sinyakov-sa/plane/MG20_3550_Wing_RevA36_SmoothBREP/README_RU.md

# MG20 3550 — крыло Rev A.36 SmoothBREP

База: Rev A.35.

## Элероны

Элероны упрощены и теперь полностью зашиты бальзой **1,0 мм сверху и снизу по всей площади**. Отдельный носовой D-box, его задняя стенка и плёночная обтяжка элеронов удалены.

Внешняя поверхность новой обшивки взята непосредственно с точной аэродинамической поверхности A.35. Все 14 нервюр элеронов перестроены с посадкой **1,05 мм** под лист 1,0 мм, то есть оставлен технологический запас 0,05 мм.

Закрылки не менялись: каркас + термоусадочная плёнка 0,08 мм.

Расчётная масса полной бальзовой обшивки двух элеронов: **19.0 г**.

Повторный импорт STEP: **PASS**. Материал новых деталей после импорта: Balsa, плотность 0,16 г/см³.

Основная сборка: `MG20_Wing_A36_SmoothBREP_KOMPAS.step`.
