sinyakov-sa/plane/нервюры перехода/README_RU.txt

MG20 — НЕРВЮРЫ ПЕРЕХОДНЫХ КОЛОДОК КОНСОЛИ, RevA / 15x5
Дата: 23.10.2026. Все размеры в миллиметрах.

КОМПЛЕКТ
На ОДНУ консоль: O0350, O0385, O0405, O0500, O0640.
Каждая нервюра состоит из передней FWD и задней AFT половинки: всего 10 деталей.
Координаты 350 / 385 / 405 / 500 / 640 отсчитываются от корня съёмной консоли.
Координата задаёт СРЕДНЮЮ плоскость 3-мм нервюры. Учтена геометрия по её толщине.
Для двух консолей вырезать комплект дважды. Профиль по высоте не зеркалить.
O0230 уже входит в комплект пенала; повторно не вырезать.
На отметке 680 мм отдельной нервюры в исходном расписании нет.

МАТЕРИАЛ И РАСКЛАДКА
Берёзовая авиационная фанера 3 мм для всех десяти деталей.
Это изменение по сравнению с исходным A26: O0385/O0405/O0640 были из бальзы 3 мм.
O0350 и O0500 сохраняют исходный материал — берёзовую фанеру 3 мм.
Расчётная масса комплекта около 32 г на консоль при плотности 700 кг/м3.
Исходные соответствующие нервюры A26: около 16,8 г на консоль.
Прибавка около 30 г на обе консоли; к прибавке массы полок прибавляется отдельно.
Раскладка помещается в лист 297 мм по X и 420 мм по Y.
Волокна наружных слоёв вдоль X (хорды). Ноль станка — снизу слева.
Позиции и обозначения показаны в LAYOUT.png и LAYOUT_LABELS_DO_NOT_CUT.svg.
Автоматической гравировки в NC нет. Подписать детали по раскладке до извлечения.

ПОРЯДОК РЕЗКИ
1. NC/00_FIT_TESTS_PLY3.nc — сначала пробные участки посадки O0350/O0500/O0640
   и контрольная деталь 30 x 20 мм. Пробные участки вырезаны из геометрии нервюр,
   это не детали для вклейки. Их положения: FIT_TESTS_LABELS_DO_NOT_CUT.svg.
2. Проверить пробные участки на фактическом переходе без натяга, с сохранением
   проектной высоты профиля и места под обшивку. Если колодки ещё не изготовлены,
   окончательное совпадение посадки до их примерки не подтверждено.
3. NC/01_RIBS_ONE_CONSOLE_PLY3.nc — основной комплект на одну консоль.
4. Для другой консоли повторить основной файл на новой заготовке.

ПАРАМЕТРЫ NC
LaserGRBL / GRBL: G21, G90, G94; M4 S1000; $30=1000, $32=1.
Подача 232,8 мм/мин, один проход — перенесено из предыдущего комплекта нервюр
пенала из фанеры 3 мм. Это исходный режим для той же установки и материала;
проверить прорезание на пробных деталях перед основным листом.
Компенсация ширины реза 0,20 мм УЖЕ ВНЕСЕНА в траектории NC.
Не включать дополнительную компенсацию, не масштабировать; overrides 100%.
Лазер выключается перед каждым быстрым перемещением и в конце файла.
В DXF_NOMINAL и SVG_NOMINAL даны НОМИНАЛЬНЫЕ контуры без компенсации реза.
При использовании их в своей CAM внести компенсацию самостоятельно один раз.
Индивидуальные DXF используют координаты профиля: по Z/Y возможны отрицательные
значения. Готовая общая раскладка перенесена в положительные координаты листа.
SVG с LABELS_DO_NOT_CUT предназначены только для просмотра, не для резки.

ГЕОМЕТРИЧЕСКАЯ ПРИВЯЗКА
Аэродинамический контур, крутка, положение заднего лонжерона и границ рулей:
исходные скрипты MG20_3550_Wing_RevA26_SmoothBREP.
O0350 обрезана перед внешним закрылком; O0385/O0405 сохраняют полный хвостовой
контур как опоры неподвижного участка между закрылком и элероном.
O0500/O0640 обрезаны перед элероном. Подвижные нервюры рулей в комплект не входят.
Главный переход: колодки 5p2 длиной 450 мм, шириной 44,30 мм у начала,
по MG20_Upper_Console_Shoe_450_Dimensions.pdf и актуальному
MG20_Lower_Console_Shoe_450_Dimensions.pdf, прочитанным 23.10.2026.
Отметка начала колодки d=230; конец колодки d=680.
До d=500 сохранены наружные поверхности и сужение этих колодок.
После d=500 вырезы рассчитаны на суммарный габарит колодка + сопряжённая полка
шириной 15 мм и общей толщиной 5 мм в зоне уса, далее — на полку 15 x 5 мм.
Это не означает, что можно вклеить полную рейку 5 мм ПОВЕРХ колодки:
в зоне 500–680 мм нужен сопряжённый ус; суммарная толщина — 5 мм.
Ранее выданные чертежи колодок рассчитаны на переменную полку: новое сопряжение
рейки 15 x 5 с колодкой подгоняется совместно, наружные поверхности сохраняются.
После отметки 680 наружная полка должна плавно продолжить эту поверхность.
Стенки перехода 2 мм, наружного лонжерона 1 мм.
На d=500 учтены наружные накладки стенок толщиной 1 мм и клеевой слой 0,1 мм.
Номинальный зазор к силовому узлу — 0,20 мм с учётом изменения сечения
по толщине нервюры. На O0500/O0640 торцы половинок прямые, без мелких выступов.
На O0350/O0385/O0405 средние выступы подходят к боковым стенкам между колодками.
Не сдвигать половинки внутрь для устранения технологического зазора.
Нервюры фиксировать на стапеле в проектной ориентации.

ПРОВЕРКИ И ГРАНИЦЫ ПРИМЕНИМОСТИ
Проверены замкнутость и корректность контуров, отсутствие пересечений деталей
на листе, размещение в 297 x 420 мм, компенсация реза и зазор к расчётному
силовому габариту по всей толщине нервюры. В приложении — verification.json.
Половинки не образуют замкнутые диафрагмы и не заменяют усиление пенала.
Это геометрически проверенный комплект для примерки и изготовления нервюр,
а не подтверждение прочности переработанного перехода или всего крыла.
Фактические колодки, накладки и клеевые наплывы не измерены.
Действующая 3D-сборка крыла этим архивом не обновляется.

ВОСПРОИЗВЕДЕНИЕ
build.py + source/: Python 3, numpy, matplotlib, shapely, ezdxf.
Запуск: python3 build.py. Скрипт записывает результаты рядом с собой.
Не запускать генератор из source отдельно: это исходник прежней модели A26.
