sinyakov-sa/plane/нервюры пенала консоли/README_RU.txt

MG20: комплект НОВЫХ нервюр пенала ОДНОЙ консоли, адаптация RevA26.
7 деталей. Для второй консоли повторить комплект, профиль не зеркалить.
01: O0000, берёзовая авиационная фанера 3 мм; 280x60 мм; F232.8.
02: передние и задние половинки O0035/O0180, берёзовая фанера 2 мм; 270x110 мм; F480.
03: половинки O0230, берёзовая фанера 3 мм; 190x60 мм; F232.8.
Везде M4 S1000, один проход, $30=1000, $32=1. Ноль снизу слева, волокна вдоль X.
Компенсация уже внесена: 2 мм — 0.25 мм; 3 мм — 0.20 мм. Масштаб и overrides 100%.
Посадки сохранены из RevD (2 мм) и эмпирической RevC (O0230).
Профиль хвостов и пазы заднего лонжерона — RevA26. O0035 теперь до полной задней кромки.
O0000 новая: носовой контур под обшивку 1.5 мм, отверстие 20.4x20.4 мм.
На новую O0000 полоски бальзы 0.5 мм НЕ нужны.
O0180/O0230 новые: длина уже по RevA26; компенсирующая накладка около 4 мм на заднюю рейку НЕ нужна.
Не использовать эти NC для дорезки установленных деталей.
Перед основными файлами используйте соответствующие тесты выступов; примерка без натяга.
Проверены замкнутость, отсутствие самопересечений/наложений и сохранение посадок.
Комплект не является подтверждением прочности разрезных нервюр или полной адаптацией переходных колодок и остального крыла.
