sinyakov-sa/plane/нервюры пенала центроплана/README_RU.txt

Нервюры ОДНОГО пенала ЦЕНТРОПЛАНА MG20, адаптация A26.
C595 — цельная корневая, отверстие под трубу 20.4x20.4, авиационная берёзовая фанера 3 мм.
C560/C525 — передние и задние половинки, берёзовая фанера 2 мм.
C445 — передняя и задняя половинки, берёзовая фанера 3 мм.
Отсчёт от торца стыка: C595=0; C560=35; C525=70; C445=150 мм.
Комплект 7 деталей, для двух пеналов центроплана вырезать два комплекта.
Нервюры ставятся в плоскостях сечений крыла; не разворачивать все перпендикулярно наклонной трубе.
Учтён наклон оси трубы 2 градуса по проекту. Контуры и задние пазы A26, носовая обшивка 2 мм.
Посадки выступов перенесены из исправленных консольных NC RevD (2 мм) и RevC (3 мм).
Это предполагает одинаковый фактический зазор между рейками с консолью; сначала приложенные тесты.
TEST_O0230_TONGUE_REVC используется как тест посадки C445, несмотря на старое имя.
3 мм F232.8; 2 мм F480; M4 S1000; один проход; $30=1000; $32=1.
Керф уже внесён: 0.20/0.25 соответственно. Масштаб и overrides 100%. Ноль снизу слева. Волокна вдоль X.
Заготовки: 01 280x60; 02 290x120; 03 210x65 мм.
DXF — номинальные контуры БЕЗ компенсации; NC — готовые траектории с компенсацией.
Цельные C560/C525 не выбраны: минимальные перемычки вокруг необработанных крышек с зазором 0.2 составили бы около 0.86/1.24 мм.
C445: нижняя крышка 3 мм выступает за профиль примерно на 1.10 мм в худшей точке по ширине.
До вклейки проверить профилирование нижней крышки; для зазора 0.15 мм нужно снять в этой точке около 1.25 мм (остаток около 1.75 мм). Не снимать одинаково по всей ширине.
Профилирование крышек и прочность разрезных нервюр/пенала требуют отдельной проверки; NC не являются подтверждением прочности узла.
Переходные C365/C285/C205 в комплект не входят. Файлы для новых деталей, не для дорезки склеенного узла.
