sinyakov-sa/plane/хвост/MG20_Tail_RevD/README_RU.md

# MG20 — хвостовое оперение RevD

**Статус: эскизная конструкция для обсуждения и изготовления пробных образцов. Не предназначена для установки на летающую модель без расчёта и проверки.**

## Главное отличие от RevC

- Устранена различная стреловидность левой и правой осей руля высоты: обе лежат на **одной прямой X=140 мм, Z=0**. Для этого передняя кромка на конце стабилизатора изменена с 40 на **56 мм**; остальные хорды сохранены.
- Ось руля направления сделана вертикальной **X=210 мм, Y=0**. Передняя кромка вершины киля перенесена со 120 на **84 мм**.
- Передние кромки подвижных рулей выполнены клинообразными, с локальным уменьшением толщины. Ширина условной щели вдоль X — 2 мм.
- Силовая сборка дополнена сегментированными стенками между полками лонжеронов: **32 стенки из берёзовой фанеры 2 мм**, их торцы стыкуются с нервюрами.
- Увеличено число нервюр до **38**; возле условных петель назначены фанерные усиленные нервюры.
- Смоделированы шесть отдельных реек/брусков передней кромки из бальзы: три неподвижные и три клиновидные на рулях. Их необходимо профилировать; их 3D-форма — конечный наружный контур, а не закупочный прямоугольный брусок.
- Показаны девять мест установки осей петель. **Крепёж, конкретные петли и их посадочные карманы не спроектированы**, цилиндры в отдельном STEP — только координатные маркеры.

**Внимание: геометрия RevC и RevD НЕ взаимозаменяема. Нельзя смешивать детали лазерной резки из разных ревизий.**

## Основные размеры и геометрия, мм

| Характеристика | Значение |
|---|---:|
| Размах стабилизатора | 1000 |
| Корневая / концевая хорда стабилизатора, включая РВ | 200 / 120 |
| Смещение передней кромки стабилизатора у конца | **56** |
| Высота киля | 420 |
| Корневая / концевая хорда киля, включая РН | 300 / 180 |
| Смещение передней кромки киля наверху | **84** |
| Ось шарниров двух половин РВ | **X=140, Z=0**, параллельно Y |
| Ось шарниров РН | **X=210, Y=0**, параллельно Z |
| Профили | NACA 0010 (H), NACA 0009 (V), полилинейная аппроксимация |
| Промежуток между половинами РВ | 30 |
| Толщина верхних/нижних полок основного лонжерона | ном. 5×4, требует расчёта |
| Полки заднего лонжерона | ном. 3×3, требует расчёта |
| Предварительная толщина фанерных стенок | 2 |

Система осей: **+X назад по самолёту**, +Y вправо, +Z вверх. Эти координаты локальные, до привязки к фюзеляжу. Размеры могут измениться после определения объёма, плеча хвоста, массы и центровки MG20.

## Состав

- **6 аэродинамических оболочек-габаритов**: 2 неподвижные части стабилизатора, 2 половины руля высоты, киль и руль направления (объёмные STEP-представления внешней формы, а не сплошные физические блоки).
- **88 конструктивных твёрдых тел**: 38 нервюр, 32 отрезка стенок лонжеронов, 12 полок, 6 фасонных передних кромок.
- **9 координатных маркеров шарниров**. Это не настоящие шарниры и не монтажные отверстия.
- **DXF 1:1**: фанерные нервюры 2 мм (21 шт.), бальза 3 мм (7 шт.), бальза 2 мм (10 шт.), фанерные стенки 2 мм (32 шт.). Все детали присутствуют отдельно в листах.

### Для чего нужны файлы

- `step/MG20_RevD_Envelope_6Solids.step` — общий аэродинамический внешний вид (6 твёрдых тел).
- `step/MG20_RevD_Structure.step` — конструктивная сборка без обшивки, шарниров, тяг, крепления к фюзеляжу (88 отдельных тел).
- `step/MG20_RevD_Hinge_Datums_ONLY.step` — координатные маркеры для проверки компоновки (9 тел).
- `step/HS_R_Fixed.step` — одиночное тело для первой проверки в КОМПАС.
- `step/HS_R_Fixed_AP203_DIAGNOSTIC.step` / `...AP214IS_DIAGNOSTIC.step` — две версии схемы STEP для проверки совместимости импорта.
- `cut/RevD_Ribs_*_TRIAL_1to1.dxf` — пробные контуры нервюр.
- `cut/RevD_Shear_Webs_PLY2_TRIAL_1to1.dxf` — пробные развёрнутые контуры стенок, ширина по высоте профиля.
- `tables/Rib_Cutlist.csv`, `tables/Shear_Web_Cutlist.csv`, `tables/Other_Members.csv` — спецификации.
- `tables/Hinges_Datums.csv` — координаты осей по каждому месту навески.
- `tables/Clearance_Sweep.csv` — протокол кинематической проверки сечений.
- `parameters.json`, `generate.py` — параметры и воспроизводимый генератор.
- `verification.json` — результаты повторного открытия STEP через OpenCascade.

**DXF не включают поправку на ширину реза, свойства конкретной фанеры, разбухание клеевого шва или запас под окончательную обработку.** На слоях `CUT` находятся линии реза, на `PART_ID_DO_NOT_CUT` — только обозначения. Пазы у полок содержат номинальный суммарный конструктивный зазор **0,2 мм**, который не заменяет учёт ширины реза. Сначала проверять на образцах.

## Проверка кинематики

При повороте **только наружного профиля** вокруг прямых расчётных осей проверено 41 сечение по размаху и 25 углов в каждом сечении (в сумме 2050 проверок). В пределах ±25° для РВ и ±30° для РН пересечений профилей не обнаружено; минимальный расстояние по сечениям — **1,663 мм**.

Это **не гарантия возможности такого полного отклонения**: не учтены петли, винты, кабанчики, тяги, обшивка, эластичность, тепловые деформации и взаимное 3D-пересечение у законцовок и фюзеляжа. Допускаемые рабочие отклонения должны устанавливаться отдельно.

## Что не сделано — нельзя считать конструкцию завершённой

1. **Крепление оперения к фюзеляжу и силовой корневой узел**: неизвестны реальные габариты и сечение хвостовой балки; сверлить монтажные отверстия по этой ревизии нельзя.
2. **Физические шарниры, усиление мест вклейки, кабанчики, тяги, сервомашинки**: маркеры показывают только положение осей, не готовые узлы.
3. **Замкнутый носовой D-бокс и торсионная жёсткость рулей**: отсутствуют верхняя/нижняя бальзовая обшивка и соединения обшивки с полками/носовыми элементами. Без них твёрдость на кручение недостаточно определена.
4. **Прочность и ресурс**: не проверены нагрузки на хвост, изгиб лонжеронов, срез стенок, вырыв шарниров, прочность клеевых соединений, флаттер. Сечения 5×4 и 3×3 только предварительные.
5. **Подбор габаритов оперения**: аэродинамические объёмные коэффициенты горизонтального/вертикального оперения не рассчитаны из реальной площади/САХ крыла и плеча до фокуса хвоста.
6. **Массовая оптимизация**: 21 фанерная нервюра — консервативная временная схема, может оказаться слишком тяжёлой.

## Импорт в КОМПАС-3D

1. Проверить **`step/HS_R_Fixed.step`**: должно появиться ОДНО твёрдое тело, габарит примерно X=0…139; Y=0…500; Z≈±10 мм.
2. Если файл распознаётся, но тела нет, попробовать AP203 и AP214IS из той же папки; выполнить «Показать всё» и проверить видимость тел в дереве модели.
3. Затем проверить шесть оболочек и только после этого крупную структурную сборку на 88 тел.
4. При повторяющейся пустой модели требуется сравнение заголовка и типов STEP-сущностей с проверенно открывающимся STEP крыла. В этой среде запуск КОМПАС невозможен; OpenCascade подтвердил наличие валидной геометрии, **но импорт КОМПАС не проверен**.

## Порядок дальнейшей конструкторской работы

Следующий обоснованный этап — совместить хвост с геометрией хвостовой балки и рассчитать нагрузки/сечение лонжеронов при реально принятой Vmax и перегрузке. После этого завершить физические узлы навески и замкнутую обшивку (торсионные коробки), затем выпустить изготовительные чертежи с припусками и допусками.
