sinyakov-sa/plane/хвост/MG20_Tail_RevA/README_RU.md

# MG20 — хвостовое оперение RevA

Предварительная CAD-компоновка, 24.10.2026. Не рабочий комплект для изготовления.
Выбран вариант обычного оперения: низко расположенный стабилизатор, отдельный киль,
две половины руля высоты и руль направления. Выбор ориентирован на простоту изготовления
и обслуживания деревянной модели; глобальная оптимизация массы и аэродинамики не выполнена.

## Файлы
- MG20_Tail_RevA_Envelope.step — внешние объёмы стабилизатора, двух рулей высоты, киля и руля направления; пять деталей. Эти объёмы НЕ изображают сплошные деревянные детали.
- MG20_Tail_RevA_Frame.step — отдельная компоновочная модель каркаса. Не накладывать её на внешние объёмы при расчёте массы.
- MG20_Tail_RevA_Preview.png — вид внешней формы и каркаса.
- build_tail.py — воспроизводимый исходник (Python, CadQuery 2.7, NumPy, Matplotlib).
- parameters_and_validation.json — размеры, расчёт и результат повторного чтения STEP.

## Исходные данные и выбор размеров
Прочитан исходник generate_wing_cutpack.py из MG20_3550_Wing_RevA26_SmoothBREP.zip.
Размах крыла 3550 мм, хорда 310 мм у корня и 169 мм на конце; линия 25% хорды прямая.
Для предварительного подбора используется номинальная трапеция без поправки на округление
последних 15 мм законцовок и проекцию поперечного V. Площадь 0,850225 м².
САХ вычисляется как (2/3)*(cr²+cr*ct+ct²)/(cr+ct).

Горизонтальное оперение: полный размах 1000 мм, хорды 200/120 мм,
смещение передней кромки законцовки назад 56 мм, полная площадь 0,160 м².
Плечо 800 мм между точками 25% САХ крыла и оперения — новое проектное допущение,
а не измерение существующего фюзеляжа. Номинальный коэффициент Vh около 0,61.
Руль высоты: 30% местной хорды, две половины, центральный вырез шириной 70 мм.

Вертикальное оперение: высота 420 мм, хорды 300/180 мм, стреловидность передней
кромки 120 мм, площадь 0,1008 м², плечо 900 мм, Vv около 0,030.
Руль направления: номинально 35% местной хорды. Корень киля расположен на Z=25 мм,
верх на Z=445 мм относительно средней плоскости стабилизатора.
Оба профиля — симметричный NACA 0010 с конечной толщиной задней кромки.
Угол установки обоих оперений в модели 0°; это геометрическая исходная установка,
не рассчитанная балансировка в полёте.

Метод: Vh=Sh*lh/(Sw*MAC), Vv=Sv*lv/(Sw*b).
В таблице Embry-Riddle для планера/мотопланера ориентиры 0,6 и 0,03:
https://eaglepubs.erau.edu/introductiontoaerospaceflightvehicles/chapter/aircraft-stability-control/
Определения и ограничения метода:
https://unicado.pages.rwth-aachen.de/unicado.gitlab.io/documentation/sizing/empennage_design/basic-concepts/
Коэффициенты рассчитаны по полным площадям, до вычета щелей и центрального выреза.
Это лишь начальный подбор; они не заменяют проверку устойчивости и управляемости.

## Каркас и изготовление
Представлены нервюры толщиной 2 мм, передние элементы, продольные стенки и элементы
по линии навески. Для основной части нервюр предложена бальза; корневые нервюры
и нервюры у центрального выреза — берёзовая фанера 2 мм. Это предложения RevA,
а не подтверждение достаточной прочности данных сечений.
Каркас иллюстрирует расположение элементов. Его сечения и клеевые соединения
не рассчитаны. В модели нет полок силовых лонжеронов, обшивки D-носка, усилений
под петли, самих петель, кабанчиков, приводов, разъёмов и узла крепления к фюзеляжу.
Конструкция каркаса требует доработки до выпуска файлов резки.
Задние кромки выполнены по профилю и требуют технологического утолщения/подбора заготовки.

Между неподвижными и подвижными объёмами оставлена номинальная щель 2 мм.
Рули показаны в нейтрали: скосы носиков и оси петель ещё не разработаны;
свобода отклонения не подтверждена. По этим STEP нельзя назначать рабочие углы рулей.
Центральный вырез и высота киля условны до получения геометрии хвостовой балки.

## Координаты и импорт в КОМПАС
Единицы — миллиметры. Как в исходнике крыла: X вдоль размаха, Y назад по хорде,
Z вверх. Начало — передняя кромка крыла в центральном сечении.
Положение хвоста уже задано в этой системе; произвольный перенос при совмещении
изменит принятые плечи. Перед соединением с крылом проверить оси импортированной сборки.
Открывать STEP отдельно через импорт КОМПАС; Envelope — внешняя форма, Frame — каркас.
Нативная сборка КОМПАС не создавалась. Импорт проверен средствами OpenCascade/CadQuery,
открытие непосредственно в КОМПАС в этой среде не проверялось.

## Что необходимо перед изготовлением
1. Согласовать плечи и посадочные поверхности с фюзеляжем, проверить зазор до земли.
2. Установить диапазон центровки, массу, расчётные скорости и перегрузки.
3. Проверить продольную/путевую устойчивость, скос потока, балансировку с закрылками
   и запас управления; при необходимости изменить площади и угол установки.
4. Рассчитать силовой каркас, крепление, шарниры, приводы и массу хвоста, проверить
   жёсткость и риск флаттера. Затем разработать рабочую конструкцию и файлы резки.

## Размещение в репозитории
При добавлении в sinyakov-sa/plane проверена имеющаяся версия крыла RevA36:
в её SOURCE/generate_wing_cutpack.py сохранены SEMISPAN=1775 мм и линейная
хорда 310–169 мм. Поэтому номинальные площадь и САХ, использованные для
предварительного подбора оперения, соответствуют и этим параметрам RevA36.
Полная проверка совместной сборки и аэродинамики с RevA36 не выполнялась.

Для пересоздания файлов: `python build_tail.py` из окружения с CadQuery 2.7,
NumPy 2.x и Matplotlib. Скрипт сохраняет результаты рядом с собой.

## Исправление экспорта для КОМПАС (24.10.2026)
Первый вариант открывался у пользователя пустой моделью. Сравнение с рабочим
MG20_Wing_A36_SmoothBREP_KOMPAS.step выявило отличие: в старом Envelope было
118 PCURVE и 59 SURFACE_CURVE, а в крыле эти сущности отсутствуют.
Причина отказа непосредственно в КОМПАС пока не подтверждена.

Экспорт заменён на прямой XCAF/STEPCAF, как в исходнике крыла:
- AP214, write.surfacecurve.mode=0, write.precision.mode=1;
- отдельные определения деталей, компоненты и UpdateAssemblies перед записью;
- каждый отдельный solid каркаса оформлен отдельной деталью сборки;
- вспомогательные PCURVE/SURFACE_CURVE отсутствуют.

Сначала открывать **MG20_Tail_RevA_Frame.step** для каркаса или
**MG20_Tail_RevA_Envelope.step** для внешней формы.
Дополнительные файлы **..._FLAT.step** содержат те же тела без дерева сборки —
запасной вариант для проверки импорта. Они не сохраняют разделение на именованные
компоненты и предназначены для открытия как многотельная геометрия.

Геометрия повторно импортирована в OpenCascade: проверены количество, валидность,
объёмы и габариты тел относительно первоначальных STEP (допуск габаритов 0,001 мм,
относительный допуск объёма 0,1%). После исключения PCURVE импортёр заново
восстанавливает параметризацию границ; объёмы могут незначительно различаться. Результат в
KOMPAS_EXPORT_AUDIT.json. Проверка непосредственно в КОМПАС не выполнялась;
исправление экспорта не меняет предварительный статус конструкции.
export_kompas.py используется основным build_tail.py, поэтому исправление
сохраняется при повторной генерации модели.
