sinyakov-sa/plane/нервюры пенала консоли/layout.png

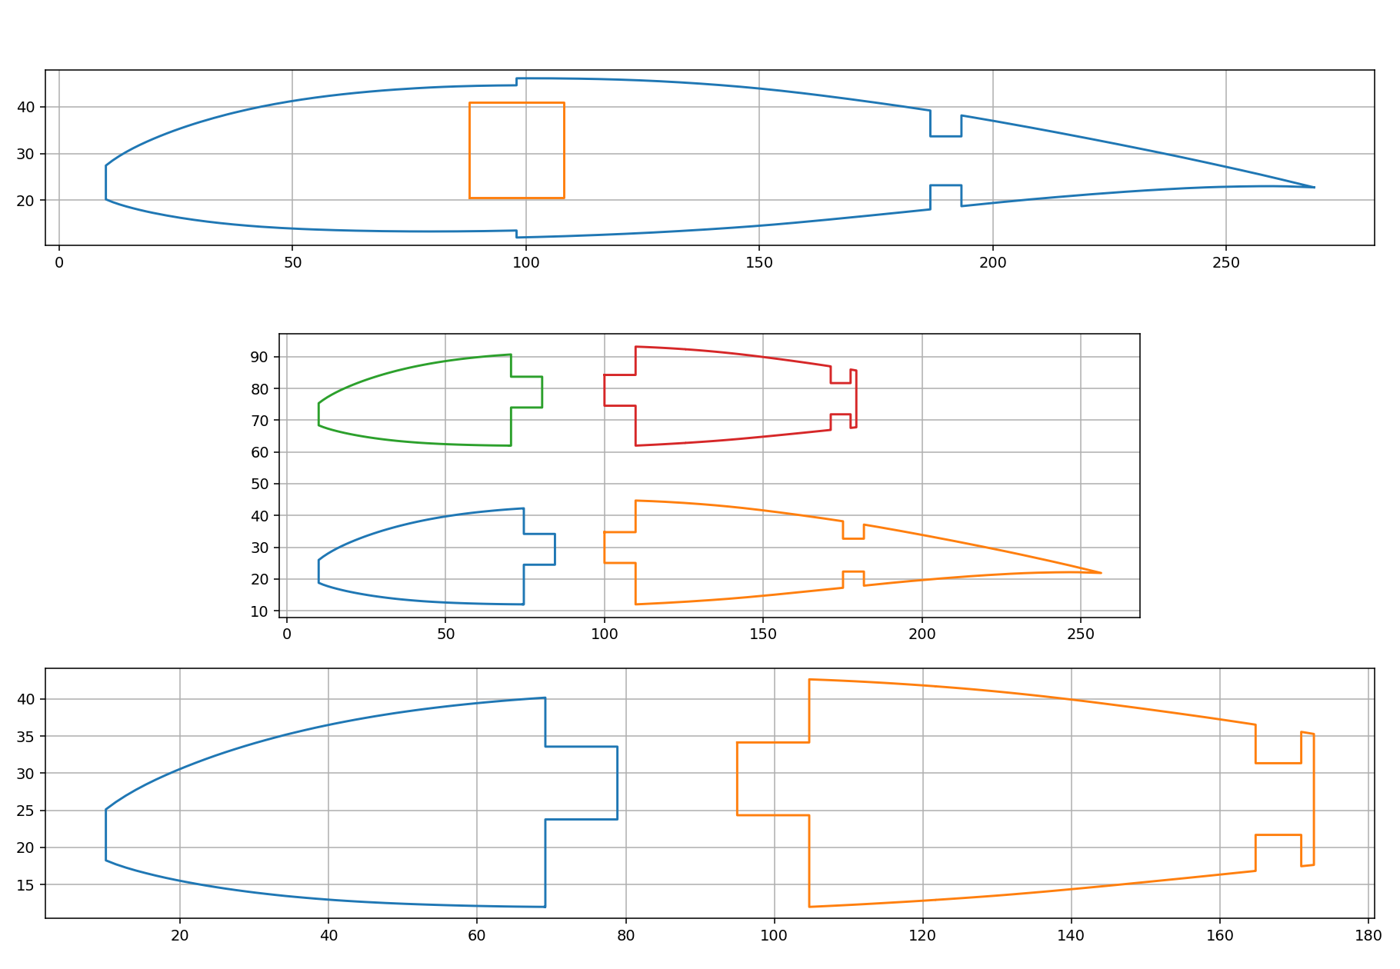
нервюры пенала консоли/layout.png
