sinyakov-sa/plane/нервюры пенала центроплана/layout.png

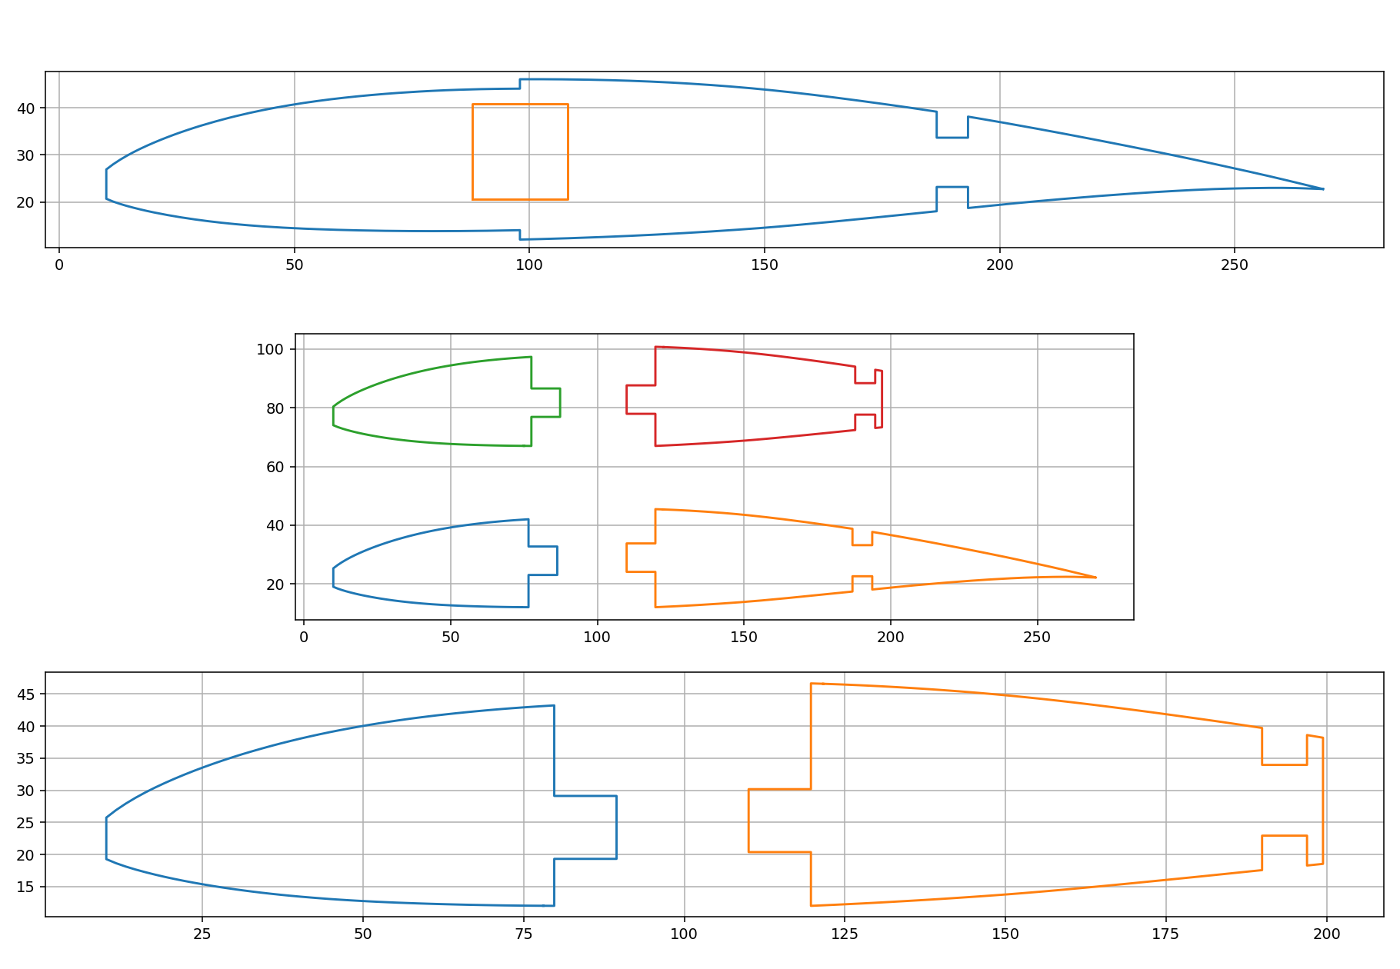
нервюры пенала центроплана/layout.png
