sinyakov-sa/plane/нервюры перехода/LAYOUT.png

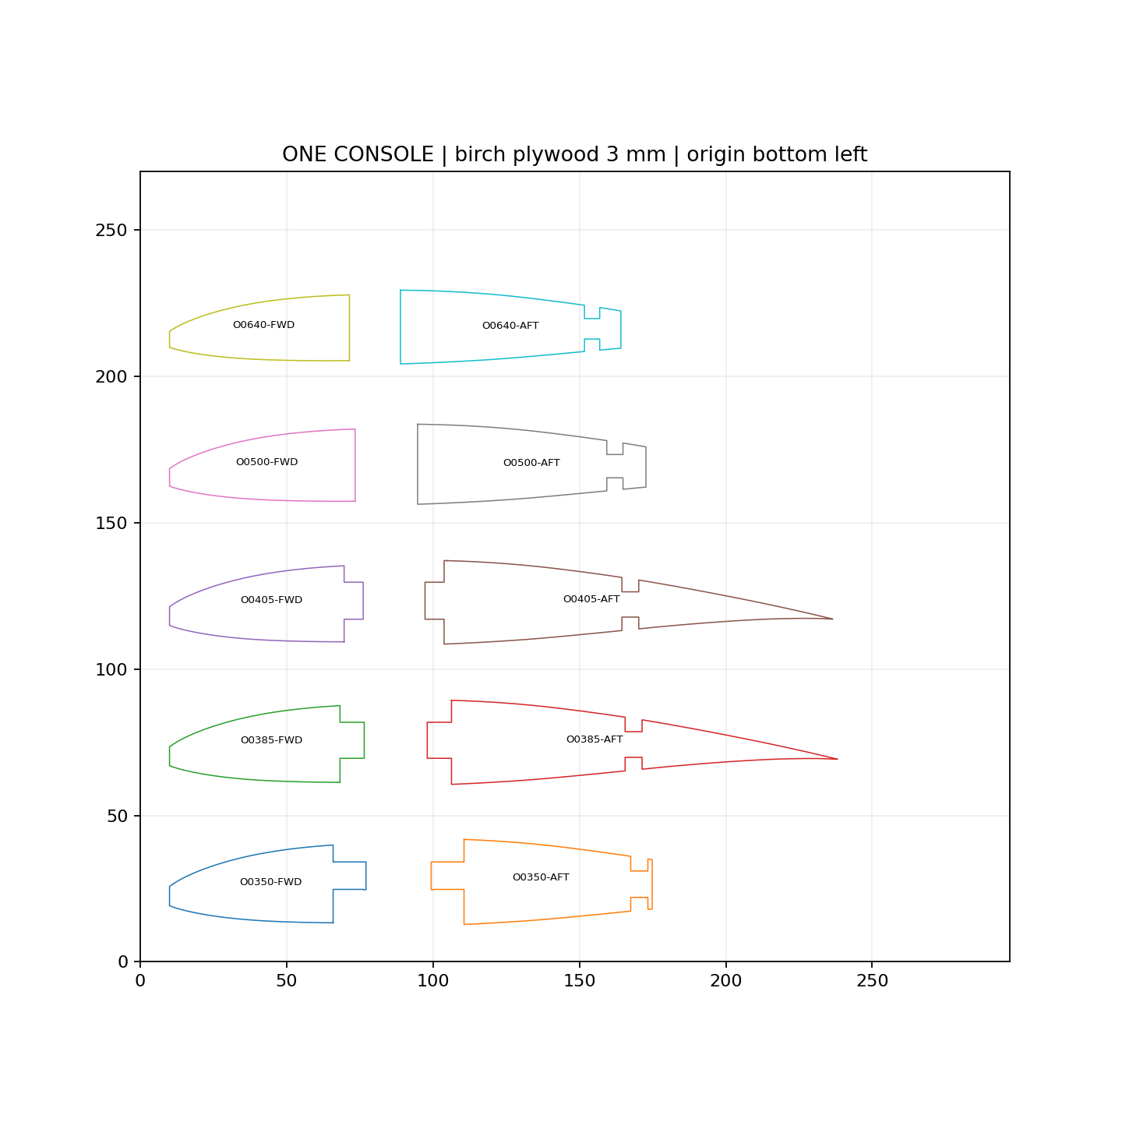
нервюры перехода/LAYOUT.png
