sinyakov-sa/plane/хвост/MG20_Tail_RevD/previews/MG20_RevD_Control_Clearance.png

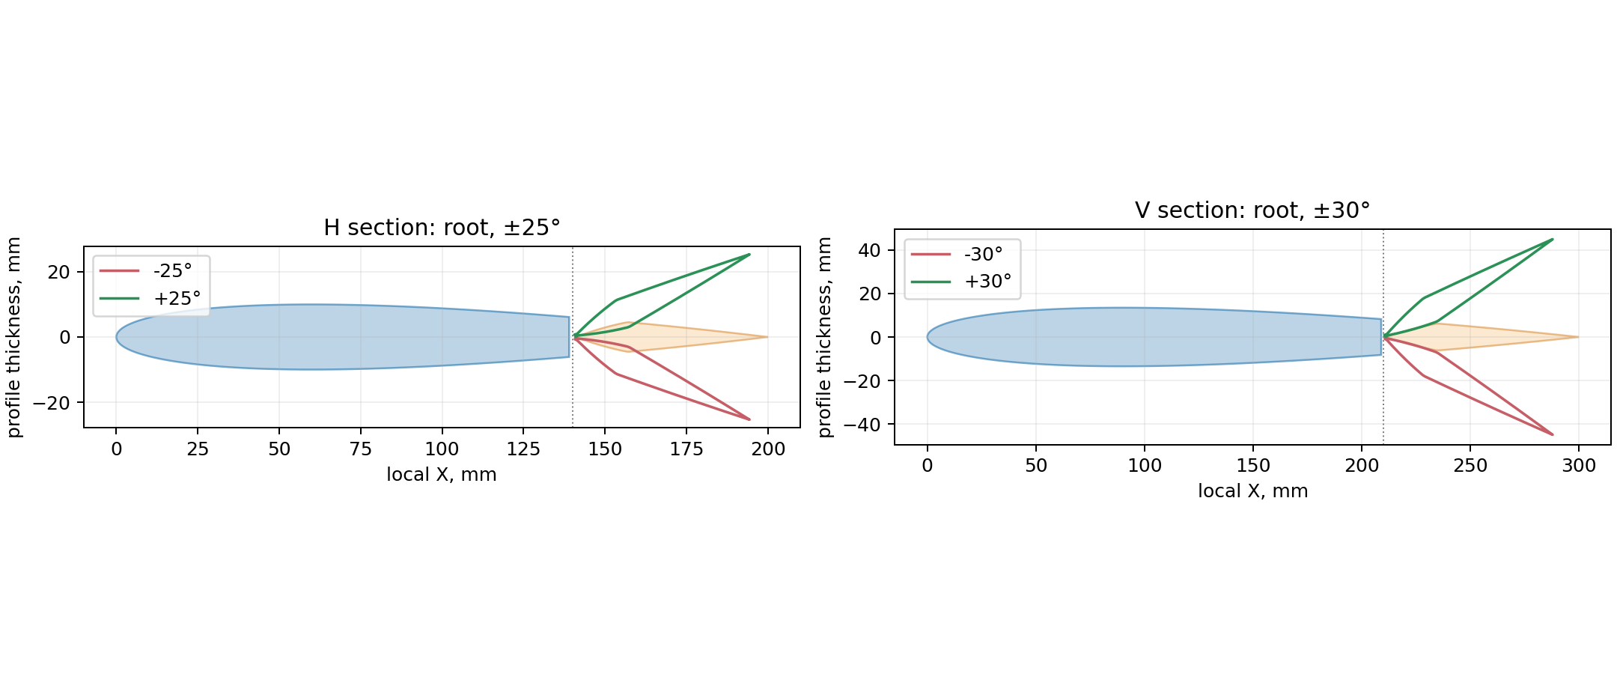
хвост/MG20_Tail_RevD/previews/MG20_RevD_Control_Clearance.png
