sinyakov-sa/plane/хвост/MG20_Tail_RevD/previews/MG20_RevD_Horizontal_Plan.png

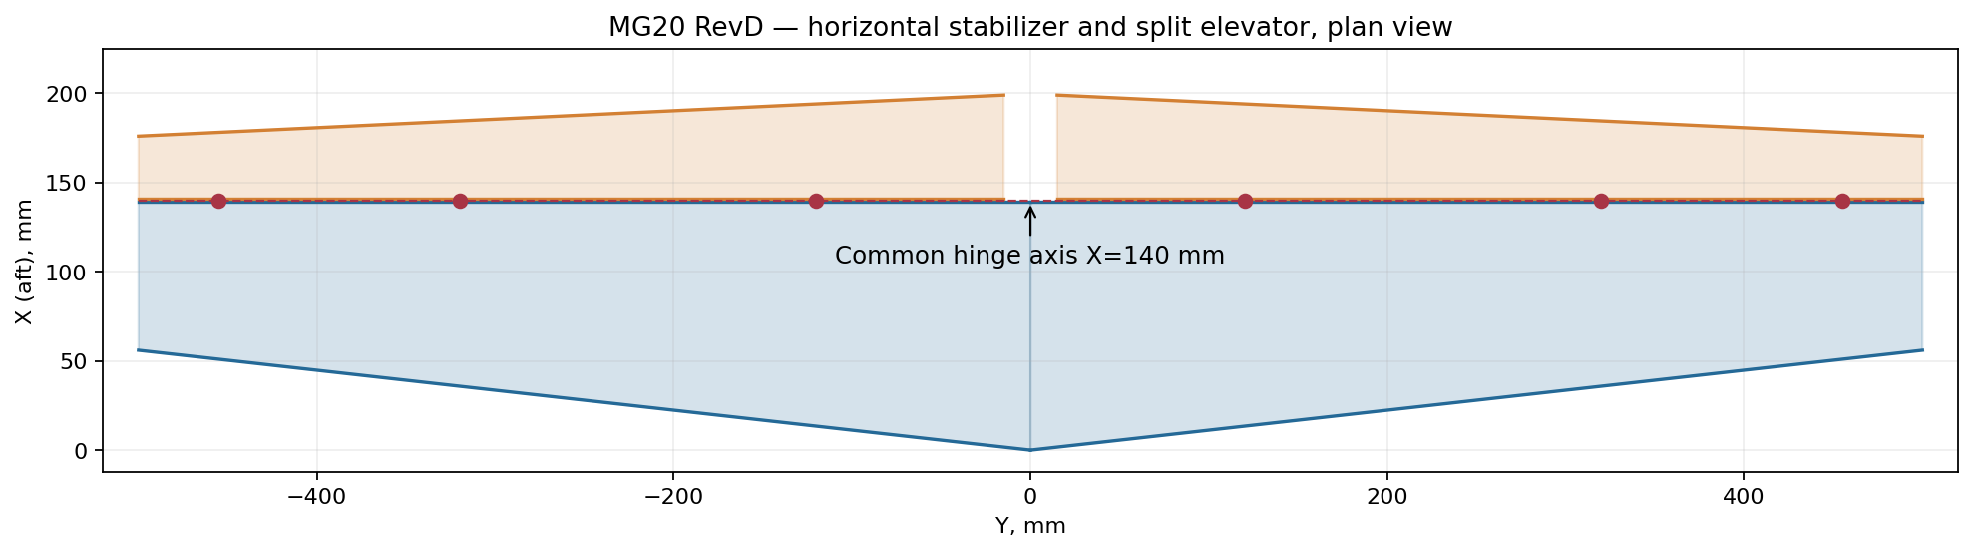
хвост/MG20_Tail_RevD/previews/MG20_RevD_Horizontal_Plan.png
