sinyakov-sa/plane/хвост/MG20_Tail_RevD/previews/MG20_RevD_Vertical_Side.png

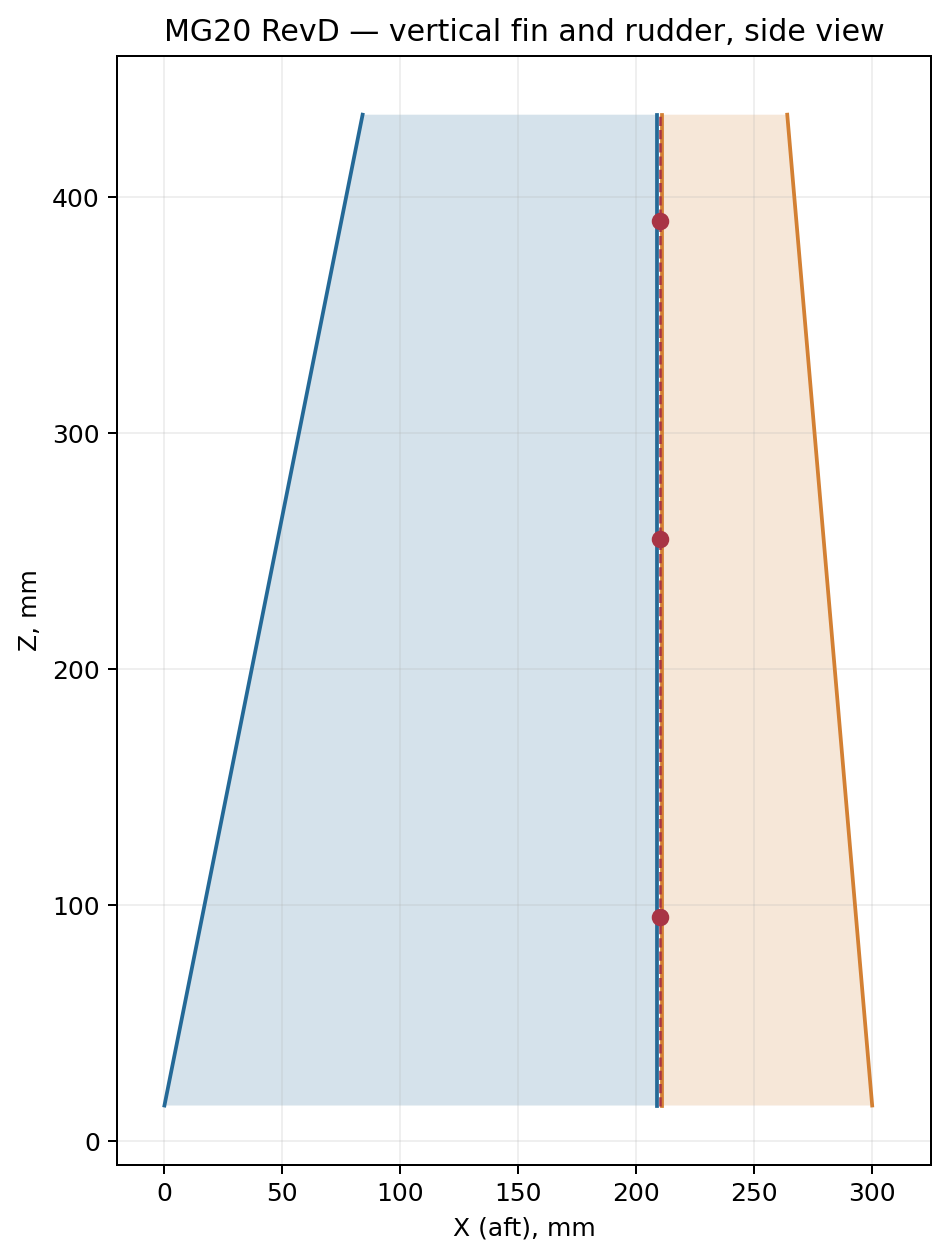
хвост/MG20_Tail_RevD/previews/MG20_RevD_Vertical_Side.png
