sinyakov-sa/plane/нервюры пенала центроплана/03_C445_PLY3_nominal.dxf

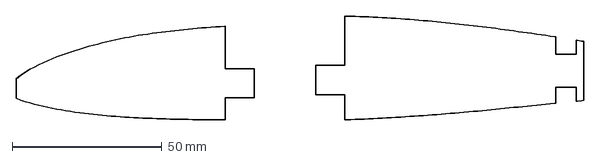
[picture p8: CAD file, 2026-10-22]
нервюры пенала центроплана/03_C445_PLY3_nominal.dxf
189.4 x 34.6 mm
