sinyakov-sa/plane/нервюры перехода/DXF_NOMINAL/O0640-AFT.dxf

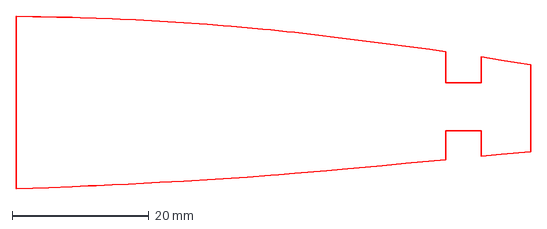
[picture p9: CAD file, 2026-10-23]
нервюры перехода/DXF_NOMINAL/O0640-AFT.dxf
75.3 x 25.2 mm
