sinyakov-sa/plane/хвост/MG20_Tail_RevB_4Solids.step

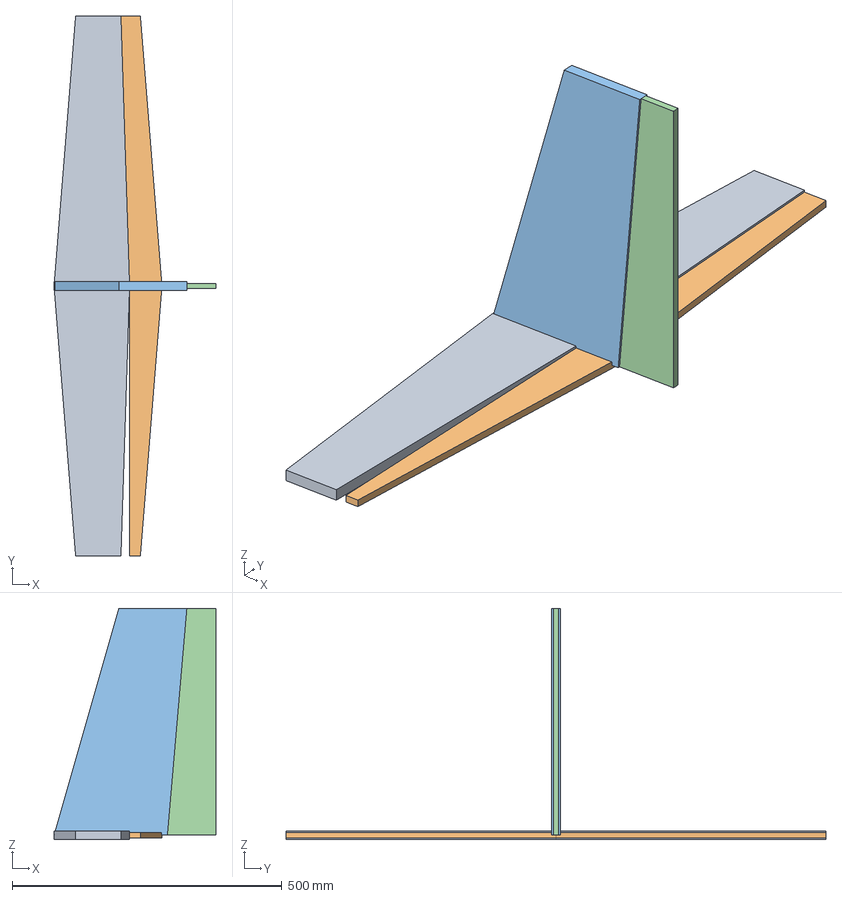
[picture p10: CAD file, 2026-10-23]
хвост/MG20_Tail_RevB_4Solids.step
300.0 x 1000.0 x 428.0 mm
