sinyakov-sa/plane/хвост/MG20_Tail_RevD/cut/RevD_Ribs_BALSA3_TRIAL_1to1.dxf

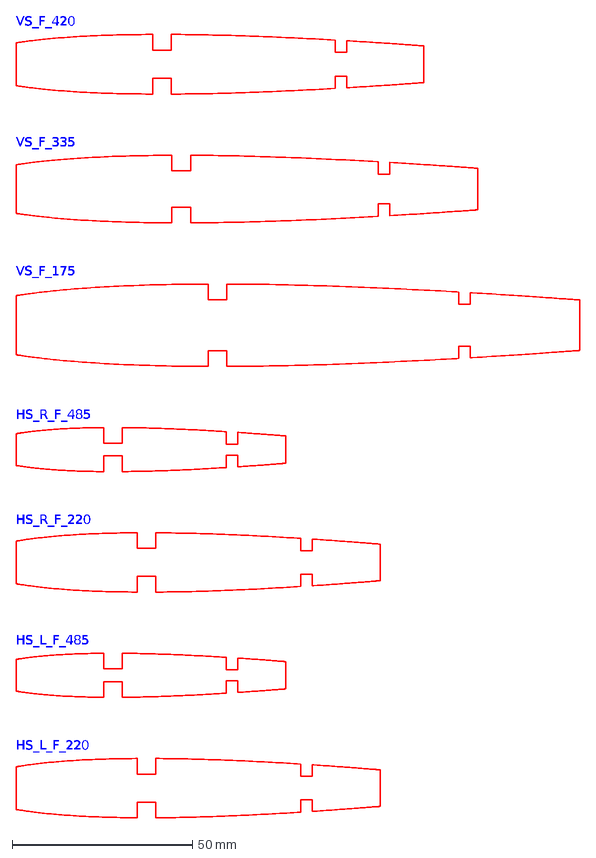
[picture p11: CAD file, 2026-10-23]
хвост/MG20_Tail_RevD/cut/RevD_Ribs_BALSA3_TRIAL_1to1.dxf
HS_L_F_220
HS_L_F_485
HS_R_F_220
HS_R_F_485
VS_F_175
VS_F_335
VS_F_420
