sinyakov-sa/plane/хвост/MG20_Tail_RevD/step/VS_Rudder.step

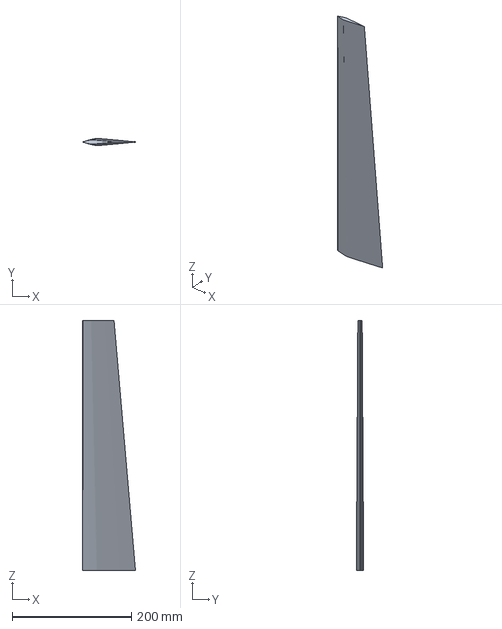
[picture p12: CAD file, 2026-10-23]
хвост/MG20_Tail_RevD/step/VS_Rudder.step
89.0 x 12.3 x 420.0 mm
