sinyakov-sa/plane/нервюры пенала центроплана/01_C595_ROOT_PLY3_nominal.dxf

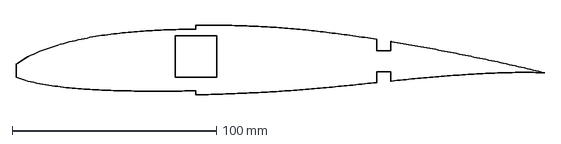
[picture p13: CAD file, 2026-10-22]
нервюры пенала центроплана/01_C595_ROOT_PLY3_nominal.dxf
258.7 x 34.1 mm
