sinyakov-sa/plane/нервюры перехода/DXF_NOMINAL/O0500-FWD.dxf

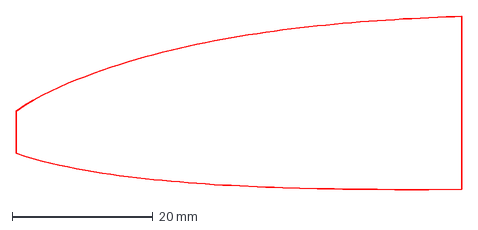
[picture p14: CAD file, 2026-10-23]
нервюры перехода/DXF_NOMINAL/O0500-FWD.dxf
63.4 x 24.7 mm
