sinyakov-sa/plane/хвост/MG20_Tail_RevD/step/VS_Fin.step

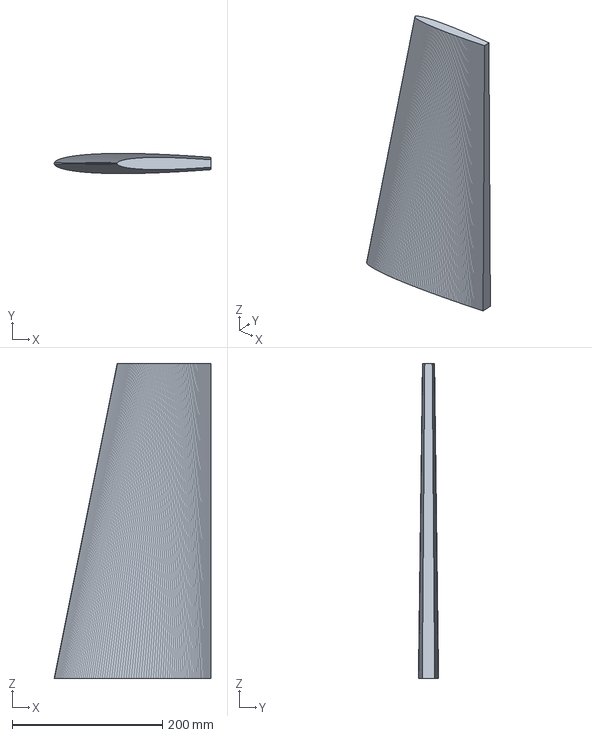
[picture p15: CAD file, 2026-10-23]
хвост/MG20_Tail_RevD/step/VS_Fin.step
209.0 x 27.0 x 420.0 mm
