sinyakov-sa/plane/нервюры пенала центроплана/02_C560_C525_PLY2_nominal.dxf

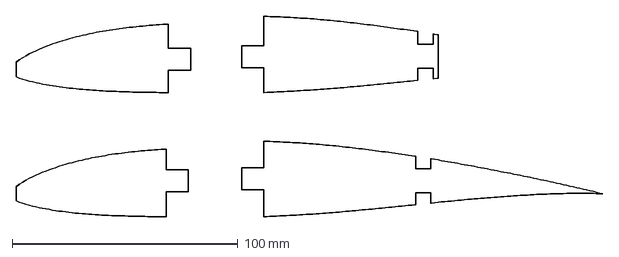
[picture p16: CAD file, 2026-10-22]
нервюры пенала центроплана/02_C560_C525_PLY2_nominal.dxf
260.0 x 88.8 mm
