sinyakov-sa/plane/нервюры перехода/DXF_NOMINAL/O0405-AFT.dxf

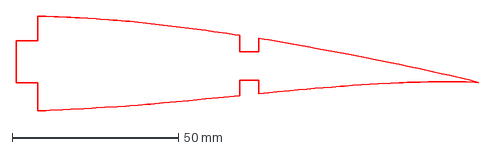
[picture p17: CAD file, 2026-10-23]
нервюры перехода/DXF_NOMINAL/O0405-AFT.dxf
139.3 x 28.5 mm
