sinyakov-sa/plane/хвост/MG20_Tail_RevD/cut/RevD_Ribs_BALSA2_TRIAL_1to1.dxf

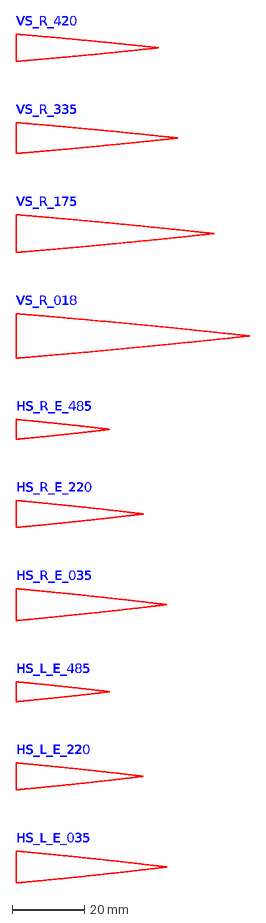
[picture p18: CAD file, 2026-10-23]
хвост/MG20_Tail_RevD/cut/RevD_Ribs_BALSA2_TRIAL_1to1.dxf
HS_L_E_035
HS_L_E_220
HS_L_E_485
HS_R_E_035
HS_R_E_220
HS_R_E_485
VS_R_018
VS_R_175
VS_R_335
VS_R_420
