sinyakov-sa/plane/хвост/MG20_Tail_RevD/step/HS_R_Fixed_AP214IS_DIAGNOSTIC.step

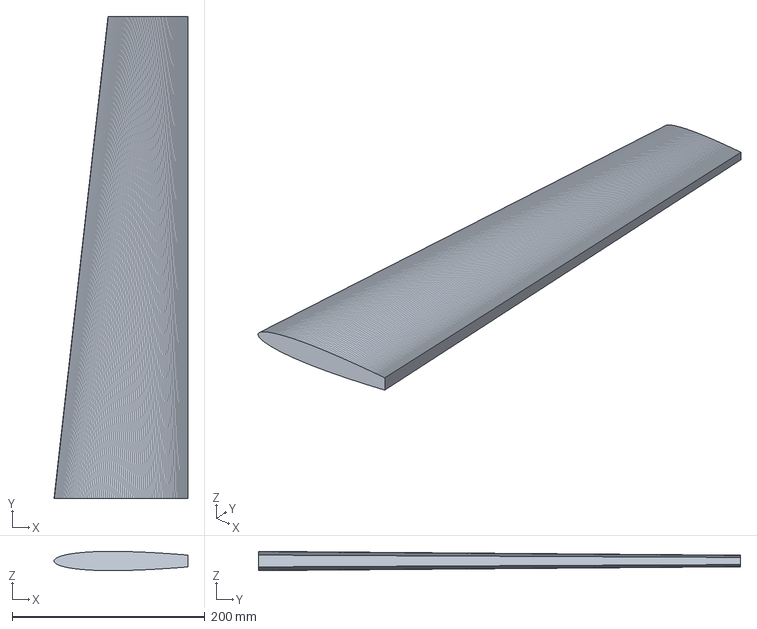
[picture p19: CAD file, 2026-10-23]
хвост/MG20_Tail_RevD/step/HS_R_Fixed_AP214IS_DIAGNOSTIC.step
139.0 x 500.0 x 20.0 mm
