sinyakov-sa/plane/нервюры перехода/DXF_NOMINAL/O0385-AFT.dxf

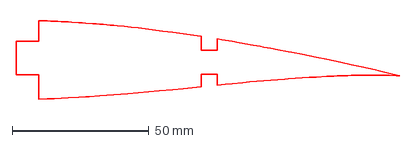
[picture p20: CAD file, 2026-10-23]
нервюры перехода/DXF_NOMINAL/O0385-AFT.dxf
140.1 x 28.7 mm
