sinyakov-sa/plane/хвост/MG20_Tail_RevD/cut/RevD_Ribs_PLY2_TRIAL_1to1.dxf

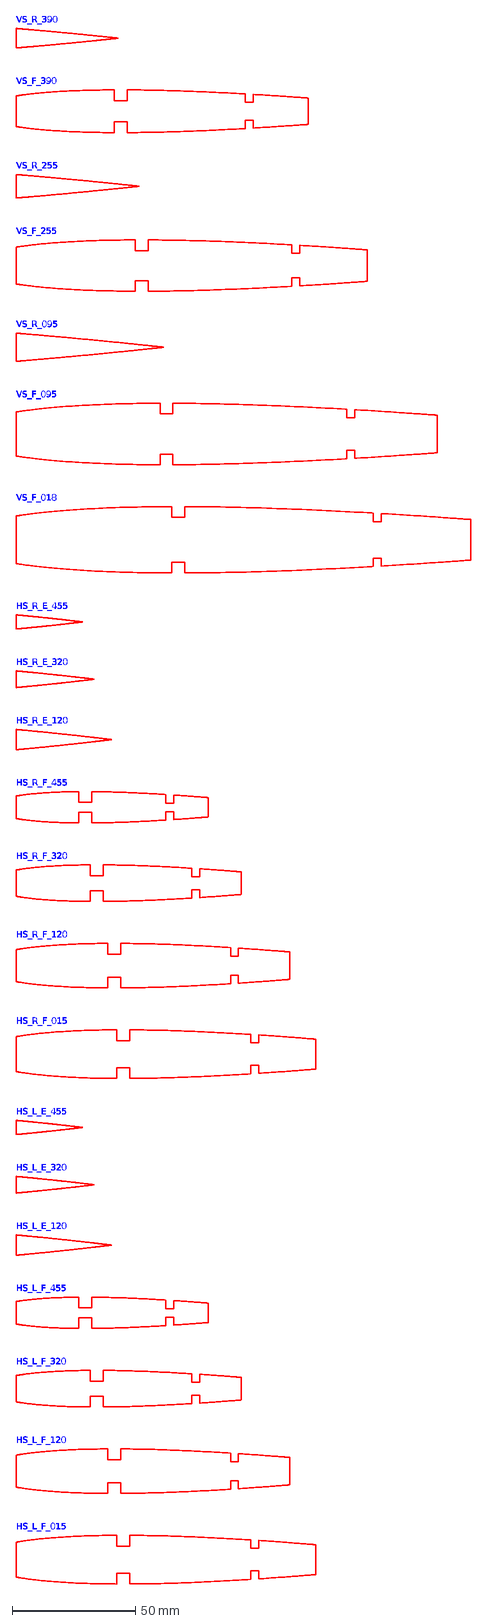
[picture p21: CAD file, 2026-10-23]
хвост/MG20_Tail_RevD/cut/RevD_Ribs_PLY2_TRIAL_1to1.dxf
HS_L_F_015
HS_L_F_120
HS_L_F_320
HS_L_F_455
HS_L_E_120
HS_L_E_320
HS_L_E_455
HS_R_F_015
HS_R_F_120
HS_R_F_320
HS_R_F_455
HS_R_E_120
HS_R_E_320
HS_R_E_455
VS_F_018
VS_F_095
VS_R_095
VS_F_255
VS_R_255
VS_F_390
VS_R_390
