sinyakov-sa/plane/хвост/MG20_Tail_RevD/step/MG20_RevD_Envelope_6Solids.step

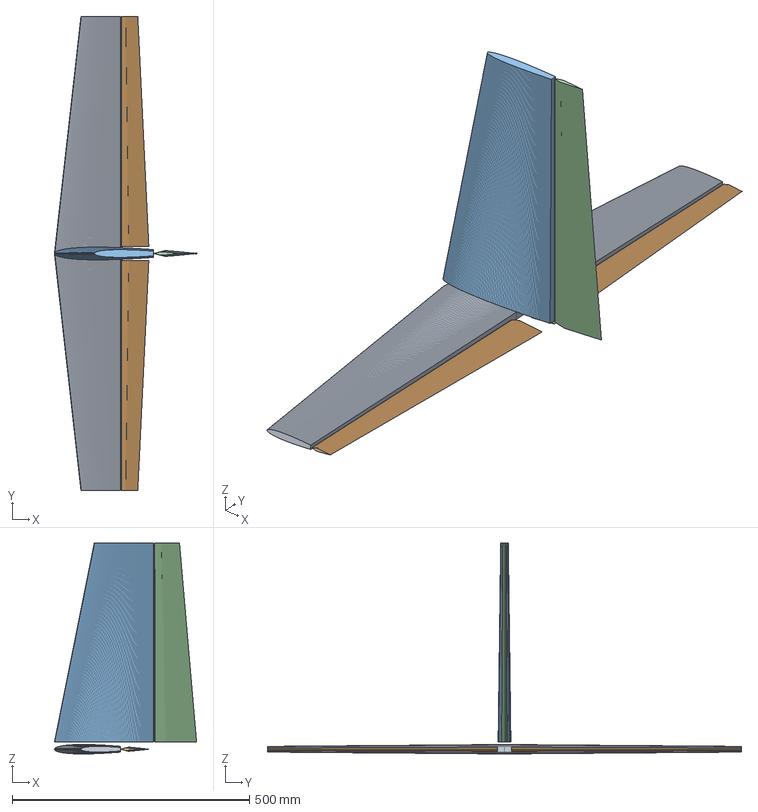
[picture p22: CAD file, 2026-10-23]
хвост/MG20_Tail_RevD/step/MG20_RevD_Envelope_6Solids.step
300.0 x 1000.0 x 445.0 mm
