sinyakov-sa/plane/нервюры перехода/DXF_NOMINAL/O0385-FWD.dxf

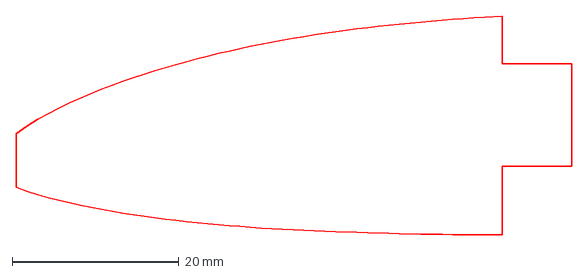
[picture p23: CAD file, 2026-10-23]
нервюры перехода/DXF_NOMINAL/O0385-FWD.dxf
66.5 x 26.2 mm
