sinyakov-sa/plane/хвост/MG20_Tail_RevD/step/HS_L_Elevator.step

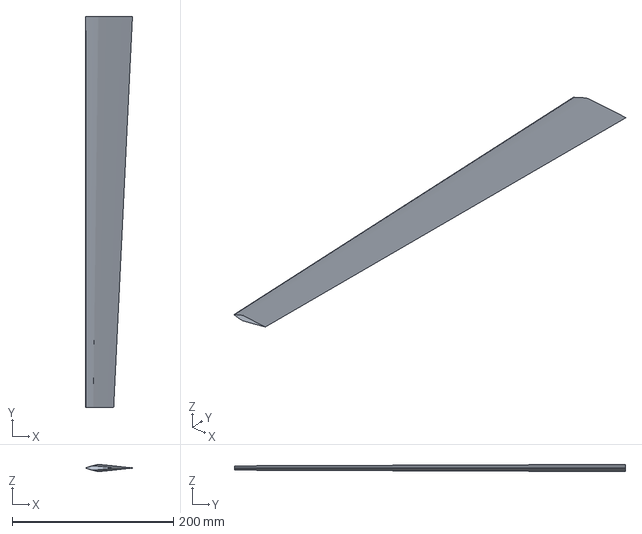
[picture p24: CAD file, 2026-10-23]
хвост/MG20_Tail_RevD/step/HS_L_Elevator.step
58.3 x 485.0 x 8.95 mm
