sinyakov-sa/plane/нервюры перехода/DXF_NOMINAL/O0500-AFT.dxf

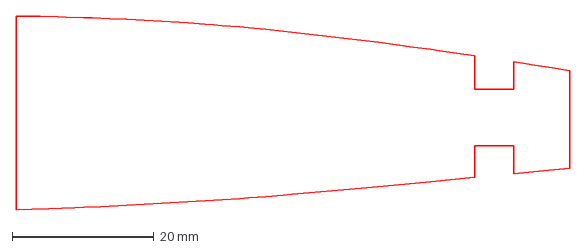
[picture p25: CAD file, 2026-10-23]
нервюры перехода/DXF_NOMINAL/O0500-AFT.dxf
78.0 x 27.3 mm
