sinyakov-sa/plane/хвост/MG20_Tail_RevD/step/MG20_RevD_Hinge_Datums_ONLY.step

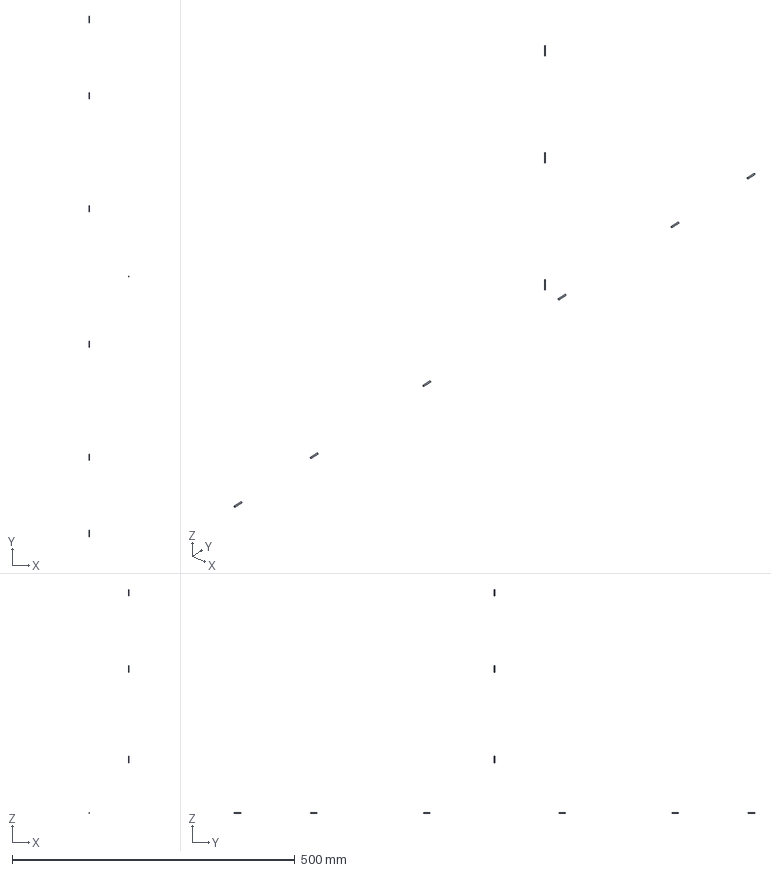
[picture p26: CAD file, 2026-10-23]
хвост/MG20_Tail_RevD/step/MG20_RevD_Hinge_Datums_ONLY.step
71.6 x 922.0 x 396.8 mm
