sinyakov-sa/plane/нервюры перехода/DXF_NOMINAL/O0350-AFT.dxf

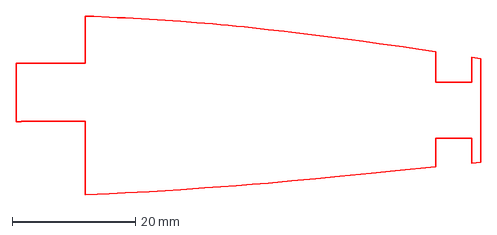
[picture p27: CAD file, 2026-10-23]
нервюры перехода/DXF_NOMINAL/O0350-AFT.dxf
75.5 x 29.1 mm
