sinyakov-sa/plane/нервюры перехода/DXF_NOMINAL/FIT_TESTS.dxf

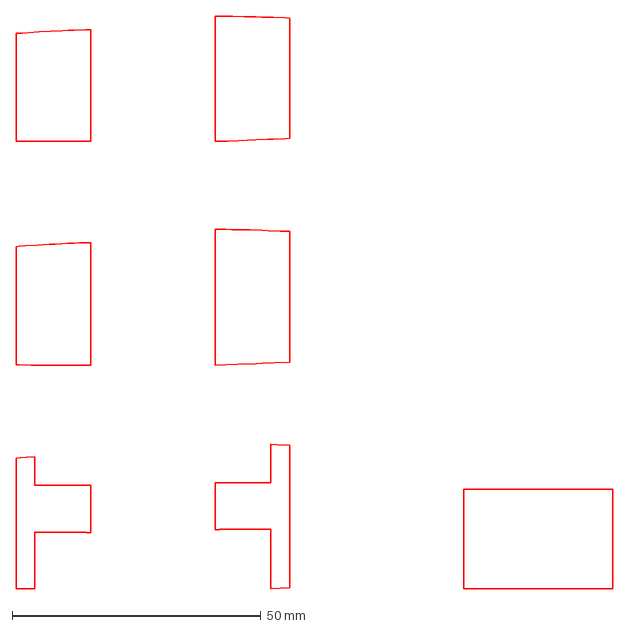
[picture p28: CAD file, 2026-10-23]
нервюры перехода/DXF_NOMINAL/FIT_TESTS.dxf
120.0 x 115.2 mm
