sinyakov-sa/plane/нервюры перехода/DXF_NOMINAL/O0405-FWD.dxf

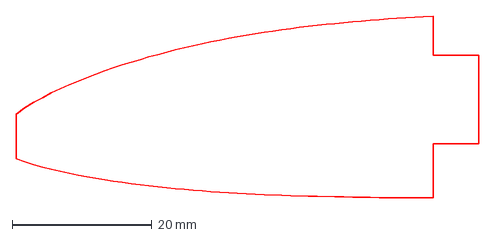
[picture p29: CAD file, 2026-10-23]
нервюры перехода/DXF_NOMINAL/O0405-FWD.dxf
66.2 x 26.0 mm
