sinyakov-sa/plane/нервюры перехода/DXF_NOMINAL/SHEET_ONE_CONSOLE_297x420.dxf

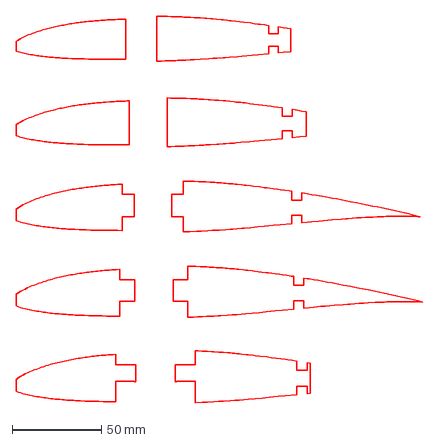
[picture p30: CAD file, 2026-10-23]
нервюры перехода/DXF_NOMINAL/SHEET_ONE_CONSOLE_297x420.dxf
228.2 x 216.7 mm
