sinyakov-sa/plane/нервюры перехода/DXF_NOMINAL/O0350-FWD.dxf

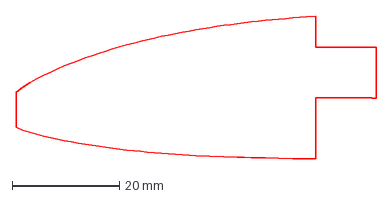
[picture p31: CAD file, 2026-10-23]
нервюры перехода/DXF_NOMINAL/O0350-FWD.dxf
67.1 x 26.6 mm
