sinyakov-sa/plane/нервюры перехода/DXF_NOMINAL/O0640-FWD.dxf

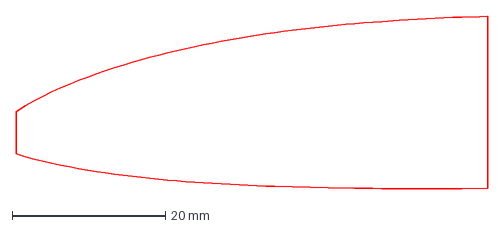
[picture p32: CAD file, 2026-10-23]
нервюры перехода/DXF_NOMINAL/O0640-FWD.dxf
61.5 x 22.5 mm
