sinyakov-sa/plane/(list of files, cad)

Other CAD files:
MG20_3550_Wing_RevA36_SmoothBREP/MG20_Wing_A36_SmoothBREP_KOMPAS.step
хвост/MG20_Tail_RevD/cut/RevD_Shear_Webs_PLY2_TRIAL_1to1.dxf
хвост/MG20_Tail_RevD/step/HS_L_Fixed.step
хвост/MG20_Tail_RevD/step/HS_R_Elevator.step
хвост/MG20_Tail_RevD/step/MG20_RevD_Structure.step
хвост/MG20_Tail_RevD/step/HS_R_Fixed_AP203_DIAGNOSTIC.step
хвост/MG20_Tail_RevD/step/HS_R_Fixed.step
хвост/MG20_Tail_RevA/MG20_Tail_RevA_Envelope.step
хвост/MG20_Tail_RevA/MG20_Tail_RevA_Envelope_FLAT.step
хвост/MG20_Tail_RevA/MG20_Tail_RevA_Frame.step
хвост/MG20_Tail_RevA/MG20_Tail_RevA_Frame_FLAT.step
хвост/MG20_Tail_RevB/H_Elevator.step
хвост/MG20_Tail_RevB/H_Stabilizer.step
хвост/MG20_Tail_RevB/V_Fin.step
хвост/MG20_Tail_RevB/V_Rudder.step
хвост/MG20_Tail_RevC/cut/Fit_Test_Slots_5mm_3mm.dxf
хвост/MG20_Tail_RevC/cut/Tail_Ribs_balsa2_1to1.dxf
хвост/MG20_Tail_RevC/cut/Tail_Ribs_balsa3_1to1.dxf
хвост/MG20_Tail_RevC/cut/Tail_Ribs_ply2_1to1.dxf
хвост/MG20_Tail_RevC/step/HS_R_Fixed_AP203.step
хвост/MG20_Tail_RevC/step/HS_R_Fixed_AP214IS.step
хвост/MG20_Tail_RevC/step/MG20_RevC_Airfoil_6Solids.step
хвост/MG20_Tail_RevC/step/MG20_RevC_Skeleton.step
хвост/MG20_Tail_RevC/step/skins/HS_L_Elevator.step
хвост/MG20_Tail_RevC/step/skins/HS_L_Fixed.step
хвост/MG20_Tail_RevC/step/skins/HS_R_Elevator.step
хвост/MG20_Tail_RevC/step/skins/HS_R_Fixed.step
хвост/MG20_Tail_RevC/step/skins/VS_Fin.step
хвост/MG20_Tail_RevC/step/skins/VS_Rudder.step
