sinyakov-sa/plane/MG20_3550_Wing_RevA36_SmoothBREP/SOURCE/generate_wing_cutpack.py

#!/usr/bin/env python3
"""Generate the MG-20/3550 Wing Rev A.29 internal-rear-M6-pad package.

All dimensions are millimetres.  The script deliberately separates nominal
geometry from machine kerf compensation.  Kerf is established with the
included coupon and applied in CAM/LaserGRBL, never baked into the master DXF.
"""

from __future__ import annotations

import csv
import hashlib
import json
import math
import shutil
import textwrap
import zipfile
from dataclasses import dataclass, field
from pathlib import Path
from typing import Iterable, Sequence

import matplotlib.pyplot as plt
import numpy as np


ROOT = Path(__file__).resolve().parent
SOURCE = ROOT / "source_airfoils"
OUT = ROOT / "MG20_3550_Wing_RevA31_Development"
ZIP_PATH = ROOT / "MG20_3550_Wing_RevA31_Development.zip"

BED_W = 400.0
BED_H = 300.0
MARGIN = 10.0
GAP = 6.0
REVISION = "A.31-OF-servo-U-frame"
DATE = "2026-08-30"

SEMISPAN = 1775.0
CENTRE_PANEL_HALF = 595.0
OUTER_PANEL_LENGTH = 1180.0
TIP_LENGTH = 15.0
TIP_ROOT_GLOBAL = SEMISPAN - TIP_LENGTH
TIP_ROOT_LOCAL = OUTER_PANEL_LENGTH - TIP_LENGTH
TIP_OUTER_PLANFORM_SCALE = 0.96
TIP_OUTER_THICKNESS_SCALE = 0.03
LEADING_EDGE_CUTBACK = 4.0
MEMBER_NOTCH_CLEARANCE = 0.15
JOINER_OPENING_CLEARANCE = 0.20

# A.21 moves the continuous rear spar forward to 70% chord and the flap hinge
# to 74% chord.  The 4%-chord separation from A.20 is retained, while flap
# chord grows from 24% to 26%.  The rear M6 wing-mount axis moves forward too.
REAR_SPAR_FRACTION = 0.70
FLAP_HINGE_FRACTION = 0.74
AILERON_HINGE_FRACTION = 0.77
# A.24 uses a physical flap pivot: the steel pin centre is the actual rotation
# axis.  The pin line remains at nominal 74% chord, but vertically it sits
# 3.5 mm above the local lower airfoil contour.  This keeps a 5 mm hinge
# barrel inside the profile with about 1 mm lower-skin allowance.
FLAP_HINGE_HALF_GAP = 1.00
HINGE_HALF_GAP = FLAP_HINGE_HALF_GAP  # compatibility with older helper names
HINGE_SPAR_CHORD = 4.0
FLAP_HINGE_AXIS_ABOVE_LOWER_MM = 3.5
FLAP_MAX_DOWN_DEG = 50.0
FLAP_MAX_UP_DEG = 8.0
FLAP_NOSE_REAR_OFFSET = 7.0
FLAP_BARREL_POCKET_DIAMETER_MM = 5.5
FLAP_HINGE_SHANK_DIAMETER_MAX = 4.0

# A.23 fixes the aileron hinge line.  The former 1.4 mm shell gap was paired
# with two 4 mm vertical spars that touched at the 77% axis.  A.23 gives the
# aileron its own 2.0 mm neutral gap and a double-bevel nose sized for ±25°.
AILERON_HINGE_HALF_GAP = 1.0
AILERON_MAX_DEFLECTION_DEG = 25.0
AILERON_NOSE_REAR_OFFSET = 6.0  # axis -> aft face of shaped balsa nose block

# A.23 separates flap and aileron hinge hardware. Flaps use larger point
# hinges; the thinner outboard aileron uses smaller hinges and adaptive
# hardwood block heights so the blocks remain inside the local profile.
FLAP_HINGE_BARREL_DIAMETER_MAX = 5.0
AILERON_HINGE_BARREL_DIAMETER_MAX = 3.0
FLAP_HINGE_BLOCK_HEIGHT = 8.0
AILERON_HINGE_BLOCK_HEIGHTS = {1025: 9.0, 1235: 7.5, 1450: 6.0, 1660: 4.7}
FLAP_HINGE_BLOCK_CHORD = 12.0
AILERON_HINGE_BLOCK_CHORD = 6.0
AILERON_HINGE_BLOCK_AXIS_OFFSET = 2.0
AILERON_HINGE_SHANK_DIAMETER_MAX = 2.8
HINGE_BLOCK_SPAN = 20.0
HINGE_BLOCK_MIN_PROFILE_MARGIN = 0.9

# A.30 replaces the old free-floating 80x70 servo plates with real recessed
# hatch modules.  The 1.5 mm cover and 1.5 mm bezel share one local tangent
# plane 0.8 mm inside the lower airfoil contour; a 2 mm birch backing ring
# supports the cover.  Two 6x6 spruce rails bridge the adjacent fixed ribs and
# carry the frame.  The servo itself stays removable with the cover on two
# hardwood mounting blocks which pass through the backing-ring opening.
SERVO_COVER_THICKNESS = 1.5
SERVO_BEZEL_THICKNESS = 1.5
SERVO_BACKING_THICKNESS = 2.0
SERVO_RECESS_MM = 0.80
SERVO_SUPPORT_RAIL_SIZE = 6.0
SERVO_COVER_SCREW_DIAMETER = 2.7   # M2.5 clearance
SERVO_SCREW_SPAN_OFFSET = 25.0
SERVO_OF_SIDE_RAIL_SPAN_OFFSET = 30.0
SERVO_OF_SIDE_RAIL_SPAN_WIDTH = 8.0
SERVO_OF_JOINER_FACE_ALLOWANCE = 0.85
SERVO_BAY_DEFS = {
    "CF": {
        "panel": "CENTRE", "rib0": "C205", "rib1": "C285",
        "local0": 205.0, "local1": 285.0, "global0": 205.0, "global1": 285.0,
        "centre": 245.0, "fraction": 0.54,
        "cover_span": 68.0, "cover_chord": 56.0,
        "bezel_span": 74.0, "bezel_chord": 62.0,
        "bezel_open_span": 68.4, "bezel_open_chord": 56.4,
        "backing_open_span": 58.0, "backing_open_chord": 46.0,
        "rail_chord_offset": 26.5, "screw_chord_offset": 26.0,
        "mount_block_span": 48.0, "mount_block_chord": 6.0, "mount_block_height": 6.0,
        "servo_plan_envelope": "body <=42x20 mm; check actual depth before drilling",
    },
    "OF": {
        "panel": "OUTER", "rib0": "O230", "rib1": "O350",
        "local0": 230.0, "local1": 350.0, "global0": 825.0, "global1": 945.0,
        "centre": 885.0, "fraction": 0.54,
        "cover_span": 68.0, "cover_chord": 56.0,
        "bezel_span": 74.0, "bezel_chord": 62.0,
        "bezel_open_span": 68.4, "bezel_open_chord": 56.4,
        "backing_open_span": 54.0, "backing_open_chord": 42.0,
        "rail_chord_offset": 25.0, "screw_chord_offset": 24.5,
        "screw_points": [(-30.0,-10.0),(30.0,-10.0),(25.0,24.5),(-25.0,24.5)],
        "mount_block_span": 48.0, "mount_block_chord": 6.0, "mount_block_height": 6.0,
        "servo_plan_envelope": "low-profile body <=42x20 mm; check actual depth before drilling",
    },
    "AIL": {
        "panel": "OUTER", "rib0": "O785", "rib1": "O880",
        "local0": 785.0, "local1": 880.0, "global0": 1380.0, "global1": 1475.0,
        "centre": 1427.5, "fraction": 0.53326,
        "cover_span": 68.0, "cover_chord": 46.0,
        "bezel_span": 74.0, "bezel_chord": 52.0,
        "bezel_open_span": 68.4, "bezel_open_chord": 46.4,
        "backing_open_span": 58.0, "backing_open_chord": 36.0,
        "rail_chord_offset": 21.5, "screw_chord_offset": 21.0,
        "mount_block_span": 48.0, "mount_block_chord": 5.0, "mount_block_height": 5.0,
        "servo_plan_envelope": "slim wing-servo body <=34x18 mm; verify depth <=10-11 mm",
    },
}

def hinge_fraction(control_kind: str) -> float:
    return FLAP_HINGE_FRACTION if control_kind == "flap" else AILERON_HINGE_FRACTION

def hinge_half_gap(control_kind: str) -> float:
    return FLAP_HINGE_HALF_GAP if control_kind == "flap" else AILERON_HINGE_HALF_GAP

def fixed_hinge_front_x(chord: float, control_kind: str, global_y: float | None = None) -> float:
    if control_kind == "flap" and global_y is not None:
        axis_x = flap_hinge_geometry(global_y)["axis_x"]
        return axis_x - FLAP_HINGE_HALF_GAP - HINGE_SPAR_CHORD
    return hinge_fraction(control_kind) * chord - hinge_half_gap(control_kind) - HINGE_SPAR_CHORD


def movable_hinge_aft_x(chord: float, control_kind: str, global_y: float | None = None) -> float:
    if control_kind == "aileron":
        return AILERON_HINGE_FRACTION * chord + AILERON_NOSE_REAR_OFFSET
    if global_y is not None:
        return flap_hinge_geometry(global_y)["rear_x"]
    return FLAP_HINGE_FRACTION * chord + FLAP_NOSE_REAR_OFFSET


def _airfoil_ordinate_mm(global_y: float, x_mm: float) -> tuple[float, float]:
    chord = chord_at_global_y(global_y)
    _, yu, yl = interpolate_airfoil(profile_thickness_at_y(global_y))
    src_x = AIRFOILS[10.0][0]
    xf = max(0.0, min(1.0, x_mm / chord))
    return float(np.interp(xf, src_x, yu) * chord), float(np.interp(xf, src_x, yl) * chord)

def _flap_nominal_axis_local(global_y: float) -> tuple[float, float]:
    chord=chord_at_global_y(global_y); x=FLAP_HINGE_FRACTION*chord
    _,zl=_airfoil_ordinate_mm(global_y,x)
    return x, zl+FLAP_HINGE_AXIS_ABOVE_LOWER_MM


def _flap_local_axis_to_3d(global_y: float, x_local: float, z_local: float) -> np.ndarray:
    chord=chord_at_global_y(global_y); le=0.25*(310.0-chord)
    y0=le+x_local; a=math.radians(-twist_at_y(global_y)); yy=y0-77.5
    ca,sa=math.cos(a),math.sin(a)
    yt=77.5+yy*ca-z_local*sa; zt=yy*sa+z_local*ca
    if global_y<=595.0: return np.array([global_y,yt,zt],dtype=float)
    th=math.radians(2.0); t=global_y-595.0
    return np.array([595.0+t*math.cos(th)-zt*math.sin(th),yt,t*math.sin(th)+zt*math.cos(th)],dtype=float)


def _flap_nominal_axis_3d(global_y: float) -> np.ndarray:
    x,z=_flap_nominal_axis_local(global_y)
    return _flap_local_axis_to_3d(global_y,x,z)


def _flap_actual_axis_3d(global_y: float) -> np.ndarray:
    # A rigid flap needs all point-hinge pin centres to be exactly collinear.
    # Use the end hinge centres to define the straight physical line and
    # intersect that line with the requested rib/section plane.
    a,b=((155.0,530.0) if global_y<595.0 else (655.0,955.0))
    p0,p1=_flap_nominal_axis_3d(a),_flap_nominal_axis_3d(b); d=p1-p0
    if global_y<=595.0:
        if abs(d[0])<1e-12: raise ValueError('degenerate centre flap hinge axis')
        t=(global_y-p0[0])/d[0]
    else:
        th=math.radians(2.0); n=np.array([math.cos(th),0.0,math.sin(th)])
        target=global_y-595.0
        denom=float(np.dot(n,d))
        t=(target-float(np.dot(n,p0-np.array([595.0,0.0,0.0]))))/denom
    return p0+t*d


def _flap_axis_3d_to_local(global_y: float, p: np.ndarray) -> tuple[float,float]:
    chord=chord_at_global_y(global_y); le=0.25*(310.0-chord)
    if global_y<=595.0:
        yt=float(p[1]); zt=float(p[2])
    else:
        th=math.radians(2.0); X=float(p[0]-595.0); Z=float(p[2])
        zt=-X*math.sin(th)+Z*math.cos(th); yt=float(p[1])
    a=math.radians(-twist_at_y(global_y)); yy=yt-77.5
    ca,sa=math.cos(a),math.sin(a)
    y0=77.5+yy*ca+zt*sa
    z0=-yy*sa+zt*ca
    return y0-le,z0


def flap_hinge_axis_local(global_y: float) -> tuple[float,float]:
    return _flap_axis_3d_to_local(global_y,_flap_actual_axis_3d(global_y))


def flap_hinge_geometry(global_y: float) -> dict[str, float]:
    """A.24 flap section around the *physical steel-pin centre*.

    The point-hinge pin centre is the actual rotation axis.  It stays on the
    74% chord line and is located 3.5 mm above the local lower contour.  The
    movable balsa nose is asymmetric: the lower bevel is sized for 50 deg down
    and the upper bevel for 8 deg up.  The fixed wing ends 1.0 mm ahead of the
    pin centre and the movable V-apex starts 1.0 mm aft of it.
    """
    chord = chord_at_global_y(global_y)
    axis_x, axis_z = flap_hinge_axis_local(global_y)
    zu_axis, zl_axis = _airfoil_ordinate_mm(global_y, axis_x)
    if axis_z >= zu_axis - 2.0:
        raise ValueError(f"Flap hinge axis leaves insufficient upper material at y={global_y}")
    apex_x = axis_x + FLAP_HINGE_HALF_GAP

    def root(upper: bool, angle_deg: float) -> float:
        slope = math.tan(math.radians(angle_deg))
        def f(x: float) -> float:
            zu, zl = _airfoil_ordinate_mm(global_y, x)
            dz = (zu - axis_z) if upper else (axis_z - zl)
            return x - (apex_x + max(0.0, dz) * slope)
        lo, hi = apex_x, min(chord - 4.0, axis_x + 18.0)
        flo, fhi = f(lo), f(hi)
        if flo * fhi > 0.0:
            raise ValueError(f"Flap bevel root not bracketed at y={global_y}: {flo}, {fhi}")
        for _ in range(70):
            mid = 0.5 * (lo + hi)
            fm = f(mid)
            if flo * fm <= 0.0:
                hi, fhi = mid, fm
            else:
                lo, flo = mid, fm
        return 0.5 * (lo + hi)

    upper_x = root(True, FLAP_MAX_UP_DEG)
    lower_x = root(False, FLAP_MAX_DOWN_DEG)
    upper_z, _ = _airfoil_ordinate_mm(global_y, upper_x)
    _, lower_z = _airfoil_ordinate_mm(global_y, lower_x)
    rear_x = axis_x + FLAP_NOSE_REAR_OFFSET
    if rear_x <= max(upper_x, lower_x) + 1.0:
        raise ValueError(f"Flap nose rear face too close to bevel root at y={global_y}")
    return {
        "axis_x": axis_x, "axis_z": axis_z, "apex_x": apex_x,
        "upper_x": upper_x, "upper_z": upper_z,
        "lower_x": lower_x, "lower_z": lower_z,
        "rear_x": rear_x,
        "fixed_aft_x": axis_x - FLAP_HINGE_HALF_GAP,
    }

def aileron_bevel_geometry(global_y: float) -> dict[str, float]:
    """Section geometry for the A.23 double-bevel aileron nose."""
    chord = chord_at_global_y(global_y)
    axis_x = AILERON_HINGE_FRACTION * chord
    zu_axis, zl_axis = _airfoil_ordinate_mm(global_y, axis_x)
    axis_z = 0.5 * (zu_axis + zl_axis)
    apex_x = axis_x + AILERON_HINGE_HALF_GAP
    slope = math.tan(math.radians(AILERON_MAX_DEFLECTION_DEG))

    def root(upper: bool) -> float:
        def f(x: float) -> float:
            zu, zl = _airfoil_ordinate_mm(global_y, x)
            dz = (zu - axis_z) if upper else (axis_z - zl)
            return x - (apex_x + max(0.0, dz) * slope)
        lo, hi = apex_x, min(chord - 4.0, axis_x + 12.0)
        flo, fhi = f(lo), f(hi)
        if flo * fhi > 0.0:
            raise ValueError(f"Aileron bevel root not bracketed at y={global_y}: {flo}, {fhi}")
        for _ in range(70):
            mid = 0.5 * (lo + hi)
            fm = f(mid)
            if flo * fm <= 0.0:
                hi, fhi = mid, fm
            else:
                lo, flo = mid, fm
        return 0.5 * (lo + hi)

    upper_x = root(True)
    lower_x = root(False)
    upper_z, _ = _airfoil_ordinate_mm(global_y, upper_x)
    _, lower_z = _airfoil_ordinate_mm(global_y, lower_x)
    return {
        "axis_x": axis_x, "axis_z": axis_z, "apex_x": apex_x,
        "upper_x": upper_x, "upper_z": upper_z,
        "lower_x": lower_x, "lower_z": lower_z,
        "rear_x": axis_x + AILERON_NOSE_REAR_OFFSET,
    }

# A.15 keeps every load-path, control-boundary and servo-bay station.  Only
# redundant intermediate stations are removed/re-spaced.  Compared with A.13,
# O090 and O270 are deleted and O595/O690 are replaced by one O640 station.
CENTER_FIXED_POSITIONS = [0, 75, 100, 125, 205, 285, 365, 445, 525, 560, 595]
OUTER_FIXED_POSITIONS = [0, 35, 180, 230, 350, 385, 405, 500, 640, 785, 880, 975, 1090, 1165]
CENTER_FLAP_RIB_POSITIONS = [129, 205, 285, 365, 445, 525, 556]
OUTER_FLAP_RIB_POSITIONS = [39, 180, 230, 350, 381]
AILERON_RIB_POSITIONS = [409, 500, 640, 785, 880, 975, 1086]
LEGACY_OUTER_FIXED_POSITIONS = [0, 35, 90, 180, 230, 270, 350, 385, 405, 500, 595, 690, 785, 880, 975, 1090, 1180]

STOCK_LENGTH = 600.0
STOCK_WIDTH = 300.0
ROOT_TUBE_CENTRE = 8.013
JOINER_TUBE = 20.0
JOINER_CLEAR = 20.4
JOINER_WEB = 2.0
JOINER_COVER = 1.0
JOINER_SLEEVE_WIDTH = JOINER_CLEAR + 2 * JOINER_WEB
JOINER_SLEEVE_HEIGHT = JOINER_CLEAR + 2 * JOINER_COVER
CENTRE_INSERTION = 150.0
OUTER_INSERTION = 230.0
CENTRE_RAIL_OVERLAP = 120.0
OUTER_RAIL_OVERLAP = 120.0
CENTRE_SHOE_NARROW = 120.0
OUTER_SHOE_NARROW = 150.0
CENTRE_TRANSITION = CENTRE_RAIL_OVERLAP + CENTRE_SHOE_NARROW
OUTER_TRANSITION = OUTER_RAIL_OVERLAP + OUTER_SHOE_NARROW
CAP_SCARF_LENGTH = 180.0
CAP_SCARF_FEATHER = 0.10
CAP_SCARF_GLUE_LINE = 0.10

# A.21 retains the A.18 centre-panel / fuselage interface.  The mount bay is bounded by the
# new C075 rib and existing C100 rib on each side; hardware is centred in the
# bay so neither the longitudinal front pin nor the vertical rear bolt cuts a rib.
MOUNT_BAY_INNER = 75.0
MOUNT_BAY_OUTER = 100.0
MOUNT_SPAN = 0.5 * (MOUNT_BAY_INNER + MOUNT_BAY_OUTER)
MOUNT_PIN_DIAMETER = 8.0
MOUNT_PIN_LENGTH = 80.0
MOUNT_PIN_BLOCK = (35.0, 25.0, 18.0)  # chord x span x height, hardwood
MOUNT_PIN_BLOCK_X0 = 20.0
MOUNT_PIN_BLOCK_X1 = MOUNT_PIN_BLOCK_X0 + MOUNT_PIN_BLOCK[0]
MOUNT_PIN_FRONT_PROJECTION = 25.0
MOUNT_BOLT_X = 182.0
MOUNT_BOLT_DIAMETER = 6.0
MOUNT_BOLT_CLEARANCE = 6.5
MOUNT_BOLT_SLEEVE_OD = 8.0
# A.28 rear M6 package fits entirely inside the clear 22 mm bay between the
# 3 mm C075/C100 ribs.  0.10 mm nominal adhesive/assembly clearance is left
# at each rib face; neither the hardwood block nor the plywood pads intersect
# a rib in CAD.
MOUNT_BOLT_BAY_SIDE_CLEARANCE = 0.10
MOUNT_BOLT_FIT_SPAN = (MOUNT_BAY_OUTER - 1.5) - (MOUNT_BAY_INNER + 1.5) - 2*MOUNT_BOLT_BAY_SIDE_CLEARANCE
MOUNT_BOLT_BLOCK = (25.0, MOUNT_BOLT_FIT_SPAN, 20.0)
MOUNT_BOLT_PAD = (40.0, MOUNT_BOLT_FIT_SPAN, 3.0)
MOUNT_BOLT_PAD_SKIN_OFFSET = 2.0  # centre-panel balsa skin; pads sit fully inside contour
MOUNT_BOLT_SLEEVE_BORE = 8.10
MOUNT_BOLT_SCREW_LENGTH = 45.0
MOUNT_BOLT_HEAD_DIAMETER = 10.0
MOUNT_BOLT_HEAD_HEIGHT = 6.0
MOUNT_BOLT_WASHER_OD = 12.0
MOUNT_BOLT_WASHER_ID = 6.6
MOUNT_BOLT_WASHER_THICKNESS = 1.6
MOUNT_BOLT_FUSELAGE_THREAD_ENGAGEMENT_MIN = 8.0

# A.25 replaces the small rectangular external front-pin doublers with
# forward rib-shaped birch-plywood doublers.  They run from the solid leading-
# edge interface through the main-spar cap notch and end just aft of the main
# spar, so pin-block loads spread into the D-box skin/leading edge and main spar.
MOUNT_PIN_DOUBLER_THICKNESS = 3.0
MOUNT_PIN_DOUBLER_AFT_FRACTION = 0.40
MOUNT_PIN_DOUBLER_OUTBOARD_SHIFT_MM = 3.0


Point = tuple[float, float]


@dataclass
class Circle:
    center: Point
    radius: float
    layer: str = "CUT"


@dataclass
class TextMark:
    at: Point
    text: str
    height: float = 3.0
    layer: str = "ENGRAVE"


@dataclass
class Part:
    part_id: str
    material: str
    thickness: float
    outer: list[Point]
    holes: list[list[Point]] = field(default_factory=list)
    circles: list[Circle] = field(default_factory=list)
    marks: list[TextMark] = field(default_factory=list)
    note: str = ""
    source_station: float | None = None

    def all_cut_points(self) -> list[Point]:
        pts = list(self.outer)
        for poly in self.holes:
            pts.extend(poly)
        for c in self.circles:
            x, y = c.center
            r = c.radius
            pts.extend([(x - r, y - r), (x + r, y + r)])
        return pts

    def bbox(self) -> tuple[float, float, float, float]:
        pts = self.all_cut_points()
        xs = [p[0] for p in pts]
        ys = [p[1] for p in pts]
        return min(xs), min(ys), max(xs), max(ys)


@dataclass
class PlacedPart:
    part: Part
    dx: float
    dy: float


def read_airfoil(path: Path) -> tuple[np.ndarray, np.ndarray, np.ndarray]:
    """Return common ascending x, upper y and lower y arrays."""
    rows: list[tuple[float, float]] = []
    for line in path.read_text(encoding="latin-1").splitlines()[1:]:
        fields = line.replace(",", ".").split()
        if len(fields) < 2:
            continue
        try:
            rows.append((float(fields[0]), float(fields[1])))
        except ValueError:
            continue
    arr = np.asarray(rows, dtype=float)
    if len(arr) < 40:
        raise ValueError(f"Too few points in {path}")
    le = int(np.argmin(arr[:, 0]))
    upper = arr[: le + 1][::-1]
    lower = arr[le:]
    x = 0.5 * (1.0 - np.cos(np.linspace(0.0, math.pi, 241)))
    yu = np.interp(x, upper[:, 0], upper[:, 1])
    yl = np.interp(x, lower[:, 0], lower[:, 1])
    return x, yu, yl


AIRFOILS = {
    10.0: read_airfoil(SOURCE / "HQW-25-10.dat"),
    12.0: read_airfoil(SOURCE / "HQW-25-12.dat"),
    13.0: read_airfoil(SOURCE / "HQW-25-13.dat"),
}


def interpolate_airfoil(thickness: float) -> tuple[np.ndarray, np.ndarray, np.ndarray]:
    keys = sorted(AIRFOILS)
    if thickness <= keys[0]:
        return AIRFOILS[keys[0]]
    if thickness >= keys[-1]:
        return AIRFOILS[keys[-1]]
    lo = max(k for k in keys if k <= thickness)
    hi = min(k for k in keys if k >= thickness)
    if lo == hi:
        return AIRFOILS[lo]
    t = (thickness - lo) / (hi - lo)
    x = AIRFOILS[lo][0]
    yu = AIRFOILS[lo][1] * (1 - t) + AIRFOILS[hi][1] * t
    yl = AIRFOILS[lo][2] * (1 - t) + AIRFOILS[hi][2] * t
    return x, yu, yl


def chord_at_global_y(y: float) -> float:
    return 310.0 + (169.0 - 310.0) * y / SEMISPAN


def profile_thickness_at_y(y: float) -> float:
    if y <= 895.0:
        return 13.0
    if y <= 1245.0:
        return 13.0 - (y - 895.0) / 350.0
    return 12.0 - 2.0 * (y - 1245.0) / 530.0


def twist_at_y(y: float) -> float:
    if y <= 950.0:
        return 0.0
    return -1.5 * (y - 950.0) / (SEMISPAN - 950.0)


def wingtip_scales_at_y(global_y: float) -> tuple[float, float]:
    """Planform and thickness scales for the smooth A.15 rounded cap."""
    if global_y <= TIP_ROOT_GLOBAL:
        return 1.0, 1.0
    t = min(max((global_y - TIP_ROOT_GLOBAL) / TIP_LENGTH, 0.0), 1.0)
    # Quintic smoothstep has zero first derivative at O1165 and at the outer
    # face.  The chord barely changes; only thickness rolls into the tip.
    ease = t**3 * (10.0 - 15.0 * t + 6.0 * t**2)
    planform = 1.0 - (1.0 - TIP_OUTER_PLANFORM_SCALE) * ease
    thickness = 1.0 - (1.0 - TIP_OUTER_THICKNESS_SCALE) * ease
    return planform, thickness


def wingtip_planform_scale_at_y(global_y: float) -> float:
    return wingtip_scales_at_y(global_y)[0]


def wingtip_thickness_scale_at_y(global_y: float) -> float:
    return wingtip_scales_at_y(global_y)[1]


def interp_surface(xq: float, x: np.ndarray, y: np.ndarray) -> float:
    return float(np.interp(xq, x, y))


def skin_thickness(global_y: float) -> float:
    return 2.0 if global_y <= 595.0 else 1.5


def spar_cap(global_y: float) -> tuple[float, float]:
    """Chordwise width and vertical height of one cap at this station."""
    stations = np.array([0.0, 125.0, 595.0, 895.0, 1245.0, SEMISPAN])
    widths = np.array([24.0, 24.0, 20.0, 17.0, 13.0, 8.0])
    heights = np.array([8.0, 8.0, 6.0, 5.5, 4.5, 3.0])
    return float(np.interp(global_y, stations, widths)), float(np.interp(global_y, stations, heights))


def rear_spar(global_y: float) -> tuple[float, float]:
    """Chordwise width and vertical height of each rear-spar rail."""
    t = min(max(global_y / SEMISPAN, 0.0), 1.0)
    return 8.0 * (1 - t) + 4.0 * t, 5.0 * (1 - t) + 3.0 * t


def rear_spar_geometry(global_y: float) -> dict[str, float]:
    """Exact paired-rail envelope used by both rib notches and the 3D model."""
    chord = chord_at_global_y(global_y)
    centre = REAR_SPAR_FRACTION * chord
    width, height = rear_spar(global_y)
    _, yu, yl = rib_outer_contour(global_y, main_notch=False, rear_notch=False)
    x1, x2 = centre - width / 2.0, centre + width / 2.0
    samples = np.linspace(x1, x2, 41)
    upper_top = min(yu(float(x)) for x in samples) - MEMBER_NOTCH_CLEARANCE
    lower_bottom = max(yl(float(x)) for x in samples) + MEMBER_NOTCH_CLEARANCE
    return {
        "centre": centre,
        "width": width,
        "height": height,
        "x1": x1,
        "x2": x2,
        "upper_bottom": upper_top - height,
        "upper_top": upper_top,
        "lower_bottom": lower_bottom,
        "lower_top": lower_bottom + height,
    }


def joiner_axis_z(global_y: float, panel: str) -> float:
    """Tube-axis height in the local rib coordinate system."""
    if panel == "C":
        return ROOT_TUBE_CENTRE + math.tan(math.radians(2.0)) * (global_y - 595.0)
    return ROOT_TUBE_CENTRE


def normal_spar_geometry(global_y: float) -> tuple[float, float, float, float]:
    """Cap width/height plus clear lower/upper web limits at one station."""
    chord = chord_at_global_y(global_y)
    main_x = 0.35 * chord
    cap_w, cap_h = spar_cap(global_y)
    _, yu, yl = rib_outer_contour(global_y, main_notch=False, rear_notch=False)
    x1, x2 = main_x - cap_w / 2, main_x + cap_w / 2
    cap_samples = np.linspace(x1, x2, 41)
    upper_bottom = min(yu(float(x)) for x in cap_samples) - cap_h - 0.15
    lower_top = max(yl(float(x)) for x in cap_samples) + cap_h + 0.15
    return cap_w, cap_h, lower_top, upper_bottom


def transition_schedule(panel: str) -> dict[str, float]:
    """Spanwise stations for the manufacturable A.13 transition."""
    if panel == "C":
        tube_end = 595.0 - CENTRE_INSERTION
        rail_end = tube_end - CENTRE_RAIL_OVERLAP
        transition_end = rail_end - CENTRE_SHOE_NARROW
        scarf_end = transition_end - CAP_SCARF_LENGTH
        return {
            "tube_end": tube_end,
            "rail_end": rail_end,
            "transition_end": transition_end,
            "scarf_end": scarf_end,
            "overlap": CENTRE_RAIL_OVERLAP,
            "narrow": CENTRE_SHOE_NARROW,
        }
    if panel == "O":
        tube_end = 595.0 + OUTER_INSERTION
        rail_end = tube_end + OUTER_RAIL_OVERLAP
        transition_end = rail_end + OUTER_SHOE_NARROW
        scarf_end = transition_end + CAP_SCARF_LENGTH
        return {
            "tube_end": tube_end,
            "rail_end": rail_end,
            "transition_end": transition_end,
            "scarf_end": scarf_end,
            "overlap": OUTER_RAIL_OVERLAP,
            "narrow": OUTER_SHOE_NARROW,
        }
    raise ValueError(f"Unknown panel: {panel}")


def cap_scarf_transition_fraction(global_y: float) -> float | None:
    """Fraction of cap thickness carried by the A.13 transition shoe."""
    centre = transition_schedule("C")
    outer = transition_schedule("O")
    if centre["scarf_end"] <= global_y <= centre["transition_end"]:
        return (global_y - centre["scarf_end"]) / CAP_SCARF_LENGTH
    if outer["transition_end"] <= global_y <= outer["scarf_end"]:
        return (outer["scarf_end"] - global_y) / CAP_SCARF_LENGTH
    return None


def cap_scarf_geometry(global_y: float) -> dict[str, float] | None:
    """Complementary transition-shoe/cap thicknesses preserving the envelope."""
    fraction = cap_scarf_transition_fraction(global_y)
    if fraction is None:
        return None
    cap_w, cap_h, lower_top, upper_bottom = normal_spar_geometry(global_y)
    shoe_thickness = CAP_SCARF_FEATHER + fraction * (
        cap_h - 2.0 * CAP_SCARF_FEATHER - CAP_SCARF_GLUE_LINE
    )
    return {
        "fraction": fraction,
        "cap_width": cap_w,
        "cap_height": cap_h,
        "shoe_thickness": shoe_thickness,
        "normal_cap_thickness": cap_h - shoe_thickness - CAP_SCARF_GLUE_LINE,
        "lower_cap_bottom": lower_top - cap_h,
        "lower_cap_top": lower_top,
        "upper_cap_bottom": upper_bottom,
        "upper_cap_top": upper_bottom + cap_h,
    }


def joiner_transition_geometry(panel: str, distance_from_joint: float) -> dict[str, float]:
    """Envelope of the A.13 straight-rail/shoe transition."""
    if panel == "C":
        insertion = CENTRE_INSERTION
        total = CENTRE_INSERTION + CENTRE_TRANSITION
        global_y = 595.0 - distance_from_joint
        end_y = transition_schedule("C")["transition_end"]
    else:
        insertion = OUTER_INSERTION
        total = OUTER_INSERTION + OUTER_TRANSITION
        global_y = 595.0 + distance_from_joint
        end_y = transition_schedule("O")["transition_end"]
    axis = joiner_axis_z(global_y, panel)
    _, _, end_lower, end_upper = normal_spar_geometry(end_y)
    end_axis = joiner_axis_z(end_y, panel)
    q = min(max((distance_from_joint - insertion) / (total - insertion), 0.0), 1.0)
    end_lower_rel = end_lower - end_axis
    end_upper_rel = end_upper - end_axis
    web_lower = axis + (-10.2 * (1 - q) + end_lower_rel * q)
    web_upper = axis + (10.2 * (1 - q) + end_upper_rel * q)
    lower_top = axis + (-5.0 * (1 - q) + end_lower_rel * q)
    upper_bottom = axis + (5.0 * (1 - q) + end_upper_rel * q)
    cap_w, cap_h, _, _ = normal_spar_geometry(end_y)
    web_outer_half = (
        JOINER_SLEEVE_WIDTH / 2 * (1 - q)
        + (cap_w / 2 + JOINER_WEB) * q
    )
    after_tube = max(0.0, distance_from_joint - insertion)
    overlap = CENTRE_RAIL_OVERLAP if panel == "C" else OUTER_RAIL_OVERLAP
    narrow = CENTRE_SHOE_NARROW if panel == "C" else OUTER_SHOE_NARROW
    overlap_fraction = min(max(after_tube / overlap, 0.0), 1.0)
    narrow_fraction = min(max((after_tube - overlap) / narrow, 0.0), 1.0)
    cap_envelope_height = 5.0 * (1 - q) + cap_h * q
    rail_height = (
        (5.0 - CAP_SCARF_GLUE_LINE - 2.0 * CAP_SCARF_FEATHER)
        * (1.0 - overlap_fraction)
        + CAP_SCARF_FEATHER
        if after_tube <= overlap + 1e-9
        else 0.0
    )
    shoe_thickness = (
        cap_envelope_height - rail_height - CAP_SCARF_GLUE_LINE
        if after_tube <= overlap + 1e-9
        else cap_envelope_height - CAP_SCARF_FEATHER - CAP_SCARF_GLUE_LINE
    )
    full_shoe_width = 2.0 * (JOINER_SLEEVE_WIDTH / 2.0 + 10.0)
    shoe_width = (
        full_shoe_width
        if after_tube <= overlap + 1e-9
        else full_shoe_width * (1.0 - narrow_fraction) + cap_w * narrow_fraction
    )
    rail_outer_half = JOINER_SLEEVE_WIDTH / 2.0 + 10.0
    rail_width = 10.0
    rail_present = after_tube <= overlap + 1e-9
    return {
        "global_y": global_y,
        "axis": axis,
        "web_lower": web_lower,
        "web_upper": web_upper,
        "lower_cap_bottom": lower_top - cap_envelope_height,
        "upper_cap_top": upper_bottom + cap_envelope_height,
        "lower_rail_bottom": lower_top - rail_height,
        "lower_rail_top": lower_top,
        "upper_rail_bottom": upper_bottom,
        "upper_rail_top": upper_bottom + rail_height,
        "web_outer_half": web_outer_half,
        "rail_outer_half": rail_outer_half,
        "rail_width": rail_width,
        "rail_height": rail_height,
        "rail_present": rail_present,
        "shoe_width": shoe_width,
        "shoe_thickness": shoe_thickness,
        "lower_shoe_bottom": lower_top - cap_envelope_height,
        "lower_shoe_top": lower_top - rail_height - CAP_SCARF_GLUE_LINE,
        "upper_shoe_bottom": upper_bottom + rail_height + CAP_SCARF_GLUE_LINE,
        "upper_shoe_top": upper_bottom + cap_envelope_height,
        "cap_envelope_height": cap_envelope_height,
        "overlap_fraction": overlap_fraction,
        "narrow_fraction": narrow_fraction,
        "envelope_outer_half": max(
            web_outer_half,
            shoe_width / 2.0,
            rail_outer_half if rail_present else 0.0,
        ),
    }


def transition_shoe_geometry(panel: str, global_y: float) -> dict[str, float] | None:
    """Cross-section of one upper/lower A.13 transition shoe."""
    schedule = transition_schedule(panel)
    in_transition = (
        schedule["transition_end"] <= global_y <= schedule["tube_end"]
        if panel == "C"
        else schedule["tube_end"] <= global_y <= schedule["transition_end"]
    )
    if in_transition:
        distance = 595.0 - global_y if panel == "C" else global_y - 595.0
        geometry = joiner_transition_geometry(panel, distance)
        return {
            "width": geometry["shoe_width"],
            "thickness": geometry["shoe_thickness"],
            "lower_bottom": geometry["lower_shoe_bottom"],
            "lower_top": geometry["lower_shoe_top"],
            "upper_bottom": geometry["upper_shoe_bottom"],
            "upper_top": geometry["upper_shoe_top"],
        }
    scarf = cap_scarf_geometry(global_y)
    if scarf is None:
        return None
    return {
        "width": scarf["cap_width"],
        "thickness": scarf["shoe_thickness"],
        "lower_bottom": scarf["lower_cap_bottom"],
        "lower_top": scarf["lower_cap_bottom"] + scarf["shoe_thickness"],
        "upper_bottom": scarf["upper_cap_top"] - scarf["shoe_thickness"],
        "upper_top": scarf["upper_cap_top"],
    }


def closed_joiner_opening(cx: float, cy: float) -> list[Point]:
    """Passage around the 24.4x22.4 sleeve and its four side rails."""
    sleeve_half = JOINER_SLEEVE_WIDTH / 2.0 + JOINER_OPENING_CLEARANCE
    cover_half = JOINER_SLEEVE_HEIGHT / 2.0 + JOINER_OPENING_CLEARANCE
    rail_outer = JOINER_SLEEVE_WIDTH / 2.0 + 10.0 + JOINER_OPENING_CLEARANCE
    rail_inner_z = 5.0 - JOINER_OPENING_CLEARANCE
    rail_outer_z = 10.0 + JOINER_OPENING_CLEARANCE
    rel = [
        (-sleeve_half, cover_half), (sleeve_half, cover_half),
        (sleeve_half, rail_outer_z), (rail_outer, rail_outer_z),
        (rail_outer, rail_inner_z), (sleeve_half, rail_inner_z),
        (sleeve_half, -rail_inner_z), (rail_outer, -rail_inner_z),
        (rail_outer, -rail_outer_z), (sleeve_half, -rail_outer_z),
        (sleeve_half, -cover_half), (-sleeve_half, -cover_half),
        (-sleeve_half, -rail_outer_z), (-rail_outer, -rail_outer_z),
        (-rail_outer, -rail_inner_z), (-sleeve_half, -rail_inner_z),
        (-sleeve_half, rail_inner_z), (-rail_outer, rail_inner_z),
        (-rail_outer, rail_outer_z), (-sleeve_half, rail_outer_z),
    ]
    return [(cx + x, cy + y) for x, y in rel]


def rectangular_opening(cx: float, cy: float, width: float, height: float) -> list[Point]:
    """Sharp nominal laser opening; avoids false corner clashes with square stock."""
    return [
        (cx - width / 2.0, cy - height / 2.0),
        (cx + width / 2.0, cy - height / 2.0),
        (cx + width / 2.0, cy + height / 2.0),
        (cx - width / 2.0, cy + height / 2.0),
    ]


def joiner_opening(global_y: float, panel: str, zone: str) -> list[Point]:
    chord = chord_at_global_y(global_y)
    main_x = 0.35 * chord
    axis = joiner_axis_z(global_y, panel)
    if zone == "root":
        return rectangular_opening(main_x, axis, JOINER_CLEAR, JOINER_CLEAR)
    if zone in {"closed", "tube_end"}:
        return closed_joiner_opening(main_x, axis)
    if panel == "C":
        distance = 595.0 - global_y
    else:
        distance = global_y - 595.0
    if zone == "transition":
        g = joiner_transition_geometry(panel, distance)
        return rectangular_opening(
            main_x,
            (g["lower_cap_bottom"] + g["upper_cap_top"]) / 2,
            2 * g["envelope_outer_half"] + 0.4,
            g["upper_cap_top"] - g["lower_cap_bottom"] + 0.4,
        )
    raise ValueError(f"Unknown joiner zone: {zone}")


def transition_end_wall_openings(global_y: float) -> list[list[Point]]:
    """Two internal slots for the 2 mm walls at the normal-spar interface."""
    chord = chord_at_global_y(global_y)
    main_x = 0.35 * chord
    cap_w, _, lower_top, upper_bottom = normal_spar_geometry(global_y)
    slot_width = JOINER_WEB + 0.4
    slot_height = upper_bottom - lower_top + 0.4
    centre_y = (lower_top + upper_bottom) / 2.0
    offset = cap_w / 2.0 + JOINER_WEB / 2.0
    return [
        rectangular_opening(main_x - offset, centre_y, slot_width, slot_height),
        rectangular_opening(main_x + offset, centre_y, slot_width, slot_height),
    ]


def rounded_rect(cx: float, cy: float, width: float, height: float, radius: float, n: int = 6) -> list[Point]:
    radius = min(radius, width / 2, height / 2)
    pts: list[Point] = []
    corners = [
        (cx + width / 2 - radius, cy + height / 2 - radius, 0, 90),
        (cx - width / 2 + radius, cy + height / 2 - radius, 90, 180),
        (cx - width / 2 + radius, cy - height / 2 + radius, 180, 270),
        (cx + width / 2 - radius, cy - height / 2 + radius, 270, 360),
    ]
    for x0, y0, a0, a1 in corners:
        for a in np.linspace(a0, a1, n, endpoint=False):
            ar = math.radians(float(a))
            pts.append((x0 + radius * math.cos(ar), y0 + radius * math.sin(ar)))
    return pts


def _dedupe_consecutive(points: Sequence[Point], tol: float = 1e-4) -> list[Point]:
    clean: list[Point] = []
    for p in points:
        if not clean or math.hypot(p[0] - clean[-1][0], p[1] - clean[-1][1]) > tol:
            clean.append(p)
    if len(clean) > 1 and math.hypot(clean[0][0] - clean[-1][0], clean[0][1] - clean[-1][1]) <= tol:
        clean.pop()
    return clean


def _clip_polygon_x(poly: Sequence[Point], cut: float, keep_less: bool) -> list[Point]:
    """Clip a closed polygon by x<=cut or x>=cut."""
    if not poly:
        return []

    def inside(p: Point) -> bool:
        return p[0] <= cut + 1e-8 if keep_less else p[0] >= cut - 1e-8

    def crossing(a: Point, b: Point) -> Point:
        if abs(b[0] - a[0]) < 1e-12:
            return (cut, a[1])
        t = (cut - a[0]) / (b[0] - a[0])
        return (cut, a[1] + t * (b[1] - a[1]))

    out: list[Point] = []
    previous = poly[-1]
    previous_in = inside(previous)
    for current in poly:
        current_in = inside(current)
        if current_in:
            if not previous_in:
                out.append(crossing(previous, current))
            out.append(current)
        elif previous_in:
            out.append(crossing(previous, current))
        previous, previous_in = current, current_in
    return _dedupe_consecutive(out)


def rib_outer_contour(global_y: float, main_notch: bool = True, rear_notch: bool = True) -> tuple[list[Point], callable, callable]:
    chord = chord_at_global_y(global_y)
    thickness = profile_thickness_at_y(global_y)
    x, yu_n, yl_n = interpolate_airfoil(thickness)
    sk = skin_thickness(global_y)
    le_x = LEADING_EDGE_CUTBACK
    main_x = 0.35 * chord
    main_w, main_h = spar_cap(global_y)
    rear_x = REAR_SPAR_FRACTION * chord
    rear_w, rear_h = rear_spar(global_y)

    def base_yu(mm_x: float) -> float:
        return interp_surface(mm_x / chord, x, yu_n) * chord

    def base_yl(mm_x: float) -> float:
        return interp_surface(mm_x / chord, x, yl_n) * chord

    def yu(mm_x: float) -> float:
        base = base_yu(mm_x)
        return base - (sk if le_x <= mm_x <= main_x else 0.0)

    def yl(mm_x: float) -> float:
        base = base_yl(mm_x)
        return base + (sk if le_x <= mm_x <= main_x else 0.0)

    # Densify at all notch/skin transition boundaries.
    special = [
        le_x,
        main_x - main_w / 2,
        main_x,
        main_x + main_w / 2,
        rear_x - rear_w / 2,
        rear_x + rear_w / 2,
        chord,
    ]
    base_x = list(np.linspace(le_x, chord, 180)) + special
    xs = sorted(set(round(float(v), 5) for v in base_x if le_x <= v <= chord))

    def upper_path() -> list[Point]:
        p: list[Point] = []
        bounds = []
        if rear_notch:
            bounds.append((rear_x - rear_w / 2, rear_x + rear_w / 2, rear_h))
        if main_notch:
            bounds.append((main_x - main_w / 2, main_x + main_w / 2, main_h))
        for xx in reversed(xs):
            inside = next((b for b in bounds if b[0] + 1e-4 < xx < b[1] - 1e-4), None)
            if inside:
                continue
            if not main_notch and abs(xx - main_x) < 1e-4:
                p.extend([(main_x, base_yu(main_x)), (main_x, base_yu(main_x) - sk)])
            else:
                p.append((xx, yu(xx)))
            for x1, x2, h in bounds:
                if abs(xx - x2) < 1e-4:
                    base = min(yu(float(x)) for x in np.linspace(x1, x2, 41)) - h - MEMBER_NOTCH_CLEARANCE
                    p.extend([(x2, base), (x1, base), (x1, yu(x1))])
        return p

    def lower_path() -> list[Point]:
        p: list[Point] = []
        bounds = []
        if main_notch:
            bounds.append((main_x - main_w / 2, main_x + main_w / 2, main_h))
        if rear_notch:
            bounds.append((rear_x - rear_w / 2, rear_x + rear_w / 2, rear_h))
        for xx in xs:
            inside = next((b for b in bounds if b[0] + 1e-4 < xx < b[1] - 1e-4), None)
            if inside:
                continue
            if not main_notch and abs(xx - main_x) < 1e-4:
                p.extend([(main_x, base_yl(main_x) + sk), (main_x, base_yl(main_x))])
            else:
                p.append((xx, yl(xx)))
            for x1, x2, h in bounds:
                if abs(xx - x1) < 1e-4:
                    base = max(yl(float(x)) for x in np.linspace(x1, x2, 41)) + h + MEMBER_NOTCH_CLEARANCE
                    p.extend([(x1, base), (x2, base), (x2, yl(x2))])
        return p

    upper = upper_path()
    lower = lower_path()
    # The open front is closed by the flat aft face of the solid leading-edge blank.
    outer = _dedupe_consecutive(upper + [(le_x, yl(le_x))] + lower[1:])
    return outer, yu, yl


def rib_part(
    part_id: str,
    global_y: float,
    material: str,
    thickness: float,
    joiner_zone: str | None = None,
    joiner_panel: str | None = None,
    doubler_mark: str | None = None,
    control_kind: str | None = None,
) -> Part:
    chord = chord_at_global_y(global_y)
    rear_notch = True
    # Closed-sleeve and intermediate transition ribs are diaphragms.  A
    # transition-end station is built separately by transition_end_rib_parts().
    main_notch = joiner_zone is None or joiner_zone == "transition_end"
    outer, yu, yl = rib_outer_contour(global_y, main_notch=main_notch, rear_notch=rear_notch)
    if control_kind:
        hinge_frac = hinge_fraction(control_kind)
        fixed_end = fixed_hinge_front_x(chord, control_kind, global_y)
        outer = _clip_polygon_x(outer, fixed_end, keep_less=True)
    holes: list[list[Point]] = []
    circles: list[Circle] = []
    if joiner_zone:
        if joiner_panel not in {"C", "O"}:
            raise ValueError(f"{part_id}: joiner panel must be C or O")
        if joiner_zone == "transition_end":
            holes.extend(transition_end_wall_openings(global_y))
        else:
            holes.append(joiner_opening(global_y, joiner_panel, joiner_zone))
    label_x = 0.48 * chord if not control_kind else 0.43 * chord
    marks = [TextMark((label_x, (yu(label_x) + yl(label_x)) / 2), part_id, 3.0)]
    if doubler_mark:
        marks.append(TextMark((0.60 * chord, (yu(0.60 * chord) + yl(0.60 * chord)) / 2 - 4), doubler_mark, 2.4))
    return Part(
        part_id=part_id,
        material=material,
        thickness=thickness,
        outer=outer,
        holes=holes,
        circles=circles,
        marks=marks,
        note=(f"y={global_y:.0f}; c={chord:.1f}; HQ/W-2.5/{profile_thickness_at_y(global_y):.2f}; "
              f"twist={twist_at_y(global_y):.2f} deg" +
              (f"; A6.2 joiner zone={joiner_zone}" if joiner_zone else "") +
              (f"; fixed wing ends {hinge_half_gap(control_kind) + HINGE_SPAR_CHORD:.1f} mm before {control_kind} hinge axis" if control_kind else "")),
        source_station=global_y,
    )


def transition_end_rib_parts(
    part_id: str,
    global_y: float,
    material: str,
    thickness: float,
    control_kind: str | None = None,
) -> list[Part]:
    """Front and rear half-ribs bonded to the completed spar envelope."""
    chord = chord_at_global_y(global_y)
    outer, yu, yl = rib_outer_contour(
        global_y, main_notch=False, rear_notch=True
    )
    if control_kind:
        hinge_frac = hinge_fraction(control_kind)
        outer = _clip_polygon_x(outer, fixed_hinge_front_x(chord, control_kind, global_y), keep_less=True)
    main_x = 0.35 * chord
    cap_w, _, _, _ = normal_spar_geometry(global_y)
    clearance = 0.2
    web_splice_plate = 1.0
    front_end = main_x - cap_w / 2.0 - JOINER_WEB - web_splice_plate - clearance
    rear_start = main_x + cap_w / 2.0 + JOINER_WEB + web_splice_plate + clearance
    front = _clip_polygon_x(outer, front_end, keep_less=True)
    rear = _clip_polygon_x(outer, rear_start, keep_less=False)
    pieces = []
    for suffix, polygon, label_x, description in (
        ("FWD", front, 0.55 * front_end, "nose half-rib bonded to front transition wall"),
        ("AFT", rear, 0.5 * (rear_start + max(x for x, _ in rear)), "aft half-rib bonded to rear transition wall"),
    ):
        pieces.append(Part(
            part_id=f"{part_id}-{suffix}",
            material=material,
            thickness=thickness,
            outer=polygon,
            marks=[TextMark((label_x, (yu(label_x) + yl(label_x)) / 2.0), f"{part_id}-{suffix}", 2.4)],
            note=(f"y={global_y:.0f}; A.13 transition-end {description}; "
                  f"0.2 mm nominal clearance to external 1 mm web splice plate"),
            source_station=global_y,
        ))
    return pieces


def control_surface_rib(part_id: str, global_y: float, control_kind: str) -> Part:
    chord = chord_at_global_y(global_y)
    hinge_frac = hinge_fraction(control_kind)
    front = movable_hinge_aft_x(chord, control_kind, global_y)
    rear = chord - 4.0
    outer, yu, yl = rib_outer_contour(global_y, main_notch=False, rear_notch=False)
    outer = _clip_polygon_x(outer, front, keep_less=False)
    outer = _clip_polygon_x(outer, rear, keep_less=True)
    label_x = (front + rear) / 2
    mark = TextMark((label_x, (yu(label_x) + yl(label_x)) / 2), part_id, 2.2)
    return Part(
        part_id=part_id,
        material="Balsa",
        thickness=3.0,
        outer=outer,
        marks=[mark],
        note=(f"{control_kind}; y={global_y:.0f}; hinge={hinge_frac*100:.0f}% chord; " +
              (f"movable rib front={AILERON_NOSE_REAR_OFFSET:.1f} mm aft of hinge axis behind shaped double-bevel nose; rear face 4 mm before theoretical TE" if control_kind == "aileron" else
               f"movable rib front={FLAP_NOSE_REAR_OFFSET:.1f} mm aft of physical hinge-pin axis behind asymmetric 50-down/8-up nose; rear face 4 mm before theoretical TE")),
        source_station=global_y,
    )


def full_airfoil_contour(
    global_y: float,
    planform_scale: float = 1.0,
    thickness_scale: float = 1.0,
) -> list[Point]:
    """Closed outer-mould-line profile used for laminated balsa wingtips."""
    chord = chord_at_global_y(global_y)
    x, yu, yl = interpolate_airfoil(profile_thickness_at_y(global_y))
    upper = [(float(xx * chord), float(zz * chord)) for xx, zz in zip(x[::-1], yu[::-1])]
    lower = [(float(xx * chord), float(zz * chord)) for xx, zz in zip(x[1:], yl[1:])]
    quarter = 0.25 * chord
    return _dedupe_consecutive([
        (quarter + (px - quarter) * planform_scale, pz * thickness_scale)
        for px, pz in upper + lower
    ])


def build_wingtips() -> list[Part]:
    """Five 3 mm laminations per side, sanded to one 15 mm rounded tip."""
    parts: list[Part] = []
    for side in ("L", "R"):
        for index in range(1, 6):
            local_inner = TIP_ROOT_LOCAL + (index - 1) * 3.0
            global_inner = CENTRE_PANEL_HALF + local_inner
            global_centre = global_inner + 1.5
            planform_scale, thickness_scale = wingtip_scales_at_y(global_centre)
            outer = full_airfoil_contour(global_centre, planform_scale, thickness_scale)
            chord = chord_at_global_y(global_centre)
            quarter = 0.25 * chord
            parts.append(Part(
                part_id=f"TIP-{side}-{index:02d}",
                material="Balsa",
                thickness=3.0,
                outer=outer,
                marks=[TextMark((quarter - 14.0 * planform_scale, 0.0), f"TIP-{side}-{index:02d}", 2.2)],
                note=(f"A.15 wingtip lamination {index}/5; local y={local_inner:.0f}..{local_inner + 3.0:.0f}; "
                      f"planform scale={planform_scale:.3f}; thickness scale={thickness_scale:.3f}; grain chordwise; "
                      "laminate in number order and sand only the exterior after cure"),
                source_station=global_centre,
            ))
    return parts


def translate_points(points: Sequence[Point], dx: float, dy: float) -> list[Point]:
    return [(x + dx, y + dy) for x, y in points]


def normalize_part(part: Part) -> Part:
    x0, y0, _, _ = part.bbox()
    dx, dy = -x0, -y0
    return Part(
        part.part_id,
        part.material,
        part.thickness,
        translate_points(part.outer, dx, dy),
        [translate_points(h, dx, dy) for h in part.holes],
        [Circle((c.center[0] + dx, c.center[1] + dy), c.radius, c.layer) for c in part.circles],
        [TextMark((m.at[0] + dx, m.at[1] + dy), m.text, m.height, m.layer) for m in part.marks],
        part.note,
        part.source_station,
    )


def nest_parts(parts: Sequence[Part]) -> list[list[PlacedPart]]:
    """Simple deterministic shelf nesting, adequate for long shallow ribs."""
    sheets: list[list[PlacedPart]] = []
    sheet: list[PlacedPart] = []
    x = MARGIN
    y = MARGIN
    row_h = 0.0
    for original in parts:
        part = normalize_part(original)
        x0, y0, x1, y1 = part.bbox()
        w = x1 - x0
        h = y1 - y0
        if w > BED_W - 2 * MARGIN or h > BED_H - 2 * MARGIN:
            raise ValueError(f"{part.part_id} does not fit {BED_W}x{BED_H}")
        if x + w > BED_W - MARGIN:
            x = MARGIN
            y += row_h + GAP
            row_h = 0.0
        if y + h > BED_H - MARGIN:
            sheets.append(sheet)
            sheet = []
            x = MARGIN
            y = MARGIN
            row_h = 0.0
        sheet.append(PlacedPart(part, x, y))
        x += w + GAP
        row_h = max(row_h, h)
    if sheet:
        sheets.append(sheet)
    return sheets


def dxf_header(layers: Sequence[str]) -> list[str]:
    out = [
        "0", "SECTION", "2", "HEADER", "9", "$ACADVER", "1", "AC1024",
        "9", "$INSUNITS", "70", "4", "0", "ENDSEC",
        "0", "SECTION", "2", "TABLES", "0", "TABLE", "2", "LAYER", "70", str(len(layers)),
    ]
    colors = {"CUT": 1, "ENGRAVE": 3, "REFERENCE": 8}
    for layer in layers:
        out += ["0", "LAYER", "2", layer, "70", "0", "62", str(colors.get(layer, 7)), "6", "CONTINUOUS"]
    out += ["0", "ENDTAB", "0", "ENDSEC", "0", "SECTION", "2", "ENTITIES"]
    return out


def dxf_polyline(points: Sequence[Point], layer: str, closed: bool = True) -> list[str]:
    out = ["0", "LWPOLYLINE", "100", "AcDbEntity", "8", layer, "100", "AcDbPolyline", "90", str(len(points)), "70", "1" if closed else "0"]
    for x, y in points:
        out += ["10", f"{x:.5f}", "20", f"{y:.5f}"]
    return out


def dxf_circle(circle: Circle) -> list[str]:
    x, y = circle.center
    return ["0", "CIRCLE", "100", "AcDbEntity", "8", circle.layer, "100", "AcDbCircle", "10", f"{x:.5f}", "20", f"{y:.5f}", "30", "0", "40", f"{circle.radius:.5f}"]


def dxf_text(mark: TextMark) -> list[str]:
    x, y = mark.at
    safe = mark.text.replace("\n", " ")
    return ["0", "TEXT", "100", "AcDbEntity", "8", mark.layer, "100", "AcDbText", "10", f"{x:.5f}", "20", f"{y:.5f}", "30", "0", "40", f"{mark.height:.5f}", "1", safe, "50", "0"]


def write_sheet_dxf(path: Path, placed: Sequence[PlacedPart], master: bool) -> None:
    layers = ["CUT"] if not master else ["CUT", "ENGRAVE", "REFERENCE"]
    out = dxf_header(layers)
    if master:
        out += dxf_polyline([(0, 0), (BED_W, 0), (BED_W, BED_H), (0, BED_H)], "REFERENCE")
    for pp in placed:
        p = pp.part
        out += dxf_polyline(translate_points(p.outer, pp.dx, pp.dy), "CUT")
        for hole in p.holes:
            out += dxf_polyline(translate_points(hole, pp.dx, pp.dy), "CUT")
        for c in p.circles:
            out += dxf_circle(Circle((c.center[0] + pp.dx, c.center[1] + pp.dy), c.radius, "CUT"))
        if master:
            for m in p.marks:
                out += dxf_text(TextMark((m.at[0] + pp.dx, m.at[1] + pp.dy), m.text, m.height, "ENGRAVE"))
    out += ["0", "ENDSEC", "0", "EOF"]
    path.write_text("\n".join(out) + "\n", encoding="ascii", errors="replace")


def svg_poly(points: Sequence[Point], cls: str) -> str:
    data = " ".join(f"{x:.3f},{BED_H-y:.3f}" for x, y in points)
    return f'<polygon class="{cls}" points="{data}"/>'


def write_sheet_svg(path: Path, placed: Sequence[PlacedPart], title: str) -> None:
    lines = [
        '<?xml version="1.0" encoding="UTF-8"?>',
        f'<svg xmlns="http://www.w3.org/2000/svg" width="{BED_W}mm" height="{BED_H}mm" viewBox="0 0 {BED_W} {BED_H}">',
        '<style>.cut{fill:none;stroke:#e22;stroke-width:.25}.hole{fill:none;stroke:#e22;stroke-width:.25}.bed{fill:white;stroke:#999;stroke-width:.3}.mark{font:3px sans-serif;fill:#176b27}.head{font:4px sans-serif;fill:#555}</style>',
        f'<rect class="bed" x="0" y="0" width="{BED_W}" height="{BED_H}"/>',
        f'<text class="head" x="8" y="8">{title}</text>',
    ]
    for pp in placed:
        p = pp.part
        lines.append(svg_poly(translate_points(p.outer, pp.dx, pp.dy), "cut"))
        for hole in p.holes:
            lines.append(svg_poly(translate_points(hole, pp.dx, pp.dy), "hole"))
        for c in p.circles:
            cx, cy = c.center[0] + pp.dx, BED_H - (c.center[1] + pp.dy)
            lines.append(f'<circle class="hole" cx="{cx:.3f}" cy="{cy:.3f}" r="{c.radius:.3f}"/>')
        for m in p.marks:
            x, y = m.at[0] + pp.dx, BED_H - (m.at[1] + pp.dy)
            lines.append(f'<text class="mark" x="{x:.3f}" y="{y:.3f}">{m.text}</text>')
    lines.append('</svg>')
    path.write_text("\n".join(lines), encoding="utf-8")


def rect_part(part_id: str, w: float, h: float, material: str, thickness: float, holes: list[list[Point]] | None = None, circles: list[Circle] | None = None, note: str = "") -> Part:
    return Part(part_id, material, thickness, [(0, 0), (w, 0), (w, h), (0, h)], holes or [], circles or [], [TextMark((3, h / 2), part_id, min(3.0, max(1.8, h * 0.25)))], note)


def build_ribs() -> list[Part]:
    parts: list[Part] = []
    center_positions = CENTER_FIXED_POSITIONS
    center_qty = {0: 1, **{p: 2 for p in center_positions if p != 0}}
    center_ply3 = {75, 100, 205, 285, 445, 595}
    center_ply2 = {365, 525, 560}
    center_joiner = {
        205: "transition_end",
        285: "transition",
        365: "transition",
        445: "tube_end",
        525: "closed",
        560: "closed",
        595: "root",
    }
    servo_marks = {205: "CF SERVO FRAME", 285: "CF SERVO FRAME"}
    for pos in center_positions:
        for copy in range(center_qty[pos]):
            suffix = "" if center_qty[pos] == 1 else ("L" if copy == 0 else "R")
            if pos in center_ply3:
                material, th = "Birch plywood", 3.0
            elif pos in center_ply2:
                material, th = "Birch plywood", 2.0
            else:
                material, th = "Balsa", 3.0
            control = "flap" if 125 < pos < 560 else None
            part_id = f"C{pos:03d}{suffix}"
            if center_joiner.get(pos) == "transition_end":
                parts.extend(transition_end_rib_parts(
                    part_id, float(pos), material, th, control
                ))
            else:
                parts.append(rib_part(
                    part_id, float(pos), material, th,
                    center_joiner.get(pos), "C" if pos in center_joiner else None,
                    servo_marks.get(pos), control,
                ))

    outer_positions = OUTER_FIXED_POSITIONS
    outer_ply3 = {0, 230, 350, 500}
    outer_ply2 = {35, 180}
    outer_joiner = {
        0: "root",
        35: "closed",
        180: "closed",
        230: "tube_end",
        350: "transition",
        385: "transition",
        405: "transition",
        500: "transition_end",
    }
    servo_marks_o = {230: "OF SERVO FRAME", 350: "OF SERVO FRAME", 785: "AIL SERVO FRAME", 880: "AIL SERVO FRAME"}
    for pos in outer_positions:
        gy = 595.0 + pos
        for side in ("L", "R"):
            if pos in outer_ply3:
                material, th = "Birch plywood", 3.0
            elif pos in outer_ply2:
                material, th = "Birch plywood", 2.0
            else:
                material, th = "Balsa", 3.0
            control = "flap" if 35 < pos < 385 else ("aileron" if 405 < pos < 1090 else None)
            part_id = f"O{pos:04d}{side}"
            if outer_joiner.get(pos) == "transition_end":
                parts.extend(transition_end_rib_parts(
                    part_id, gy, material, th, control
                ))
            else:
                parts.append(rib_part(
                    part_id, gy, material, th,
                    outer_joiner.get(pos), "O" if pos in outer_joiner else None,
                    servo_marks_o.get(pos), control,
                ))
    return parts


def build_control_surface_ribs() -> list[Part]:
    parts: list[Part] = []
    for pos in CENTER_FLAP_RIB_POSITIONS:
        for side in ("L", "R"):
            parts.append(control_surface_rib(f"SF-CF-C{pos:03d}{side}", float(pos), "flap"))
    for pos in OUTER_FLAP_RIB_POSITIONS:
        for side in ("L", "R"):
            parts.append(control_surface_rib(f"SF-OF-O{pos:04d}{side}", 595.0 + pos, "flap"))
    for pos in AILERON_RIB_POSITIONS:
        for side in ("L", "R"):
            parts.append(control_surface_rib(f"SF-AIL-O{pos:04d}{side}", 595.0 + pos, "aileron"))
    return parts


def joiner_transition_web_parts(part_id: str, panel: str) -> list[Part]:
    """Laser-cut sleeve and transition wall sections, split at the tube-end diaphragm."""
    if panel == "C":
        insertion = CENTRE_INSERTION
        total = CENTRE_INSERTION + CENTRE_TRANSITION
        end_y = transition_schedule("C")["transition_end"]
    else:
        insertion = OUTER_INSERTION
        total = OUTER_INSERTION + OUTER_TRANSITION
        end_y = transition_schedule("O")["transition_end"]
    _, _, lower_top, upper_bottom = normal_spar_geometry(end_y)
    end_axis = joiner_axis_z(end_y, panel)
    end_lower = lower_top - end_axis + JOINER_CLEAR / 2
    end_upper = upper_bottom - end_axis + JOINER_CLEAR / 2
    transition_length = total - insertion
    transition_outer = [
        (0, 0), (transition_length, end_lower),
        (transition_length, end_upper), (0, JOINER_CLEAR),
    ]
    return [
        rect_part(
            f"{part_id}-SLEEVE", insertion, JOINER_CLEAR,
            "Aircraft-grade birch plywood", JOINER_WEB,
            note=(f"A.13 straight sleeve-wall section {insertion:.0f} mm; butt joint lies "
                  "on the 3 mm C445/O230 tube-end diaphragm"),
        ),
        Part(
            f"{part_id}-TRANSITION",
            "Aircraft-grade birch plywood",
            JOINER_WEB,
            transition_outer,
            marks=[TextMark((4, JOINER_CLEAR / 2), f"{part_id}-TRANSITION", 2.6)],
            note=(f"A.13 profiled wall after tube; length {transition_length:.0f} mm to "
                  f"y={end_y:.0f}; align on C445/O230 diaphragm"),
        ),
    ]


def angle_gauge(part_id: str, length: float, angle_deg: float, width: float = 20.0) -> Part:
    rise = math.tan(math.radians(angle_deg)) * length
    outer = [(0, 0), (length, rise), (length, rise + width), (0, width)]
    return Part(
        part_id, "Birch plywood", 3.0, outer,
        marks=[TextMark((8, width / 2), f"{part_id} {angle_deg:.3f}deg", 3)],
        note=f"Assembly gauge; length {length:.1f}; offset {rise:.3f}",
    )


def screw_ring(
    part_id: str,
    width: float,
    height: float,
    opening_width: float,
    opening_height: float,
    material: str,
    thickness: float,
    screw_diameter: float,
    note: str,
) -> Part:
    hole = rounded_rect(width / 2, height / 2, opening_width, opening_height, 2.0, 8)
    inset = 5.0
    circles = [
        Circle((inset, inset), screw_diameter / 2),
        Circle((width - inset, inset), screw_diameter / 2),
        Circle((width - inset, height - inset), screw_diameter / 2),
        Circle((inset, height - inset), screw_diameter / 2),
    ]
    return Part(
        part_id, material, thickness,
        [(0, 0), (width, 0), (width, height), (0, height)],
        [hole], circles,
        [TextMark((8, height - 8), part_id, 2.7)], note,
    )


def screw_cover(
    part_id: str,
    width: float,
    height: float,
    material: str,
    thickness: float,
    screw_diameter: float,
    note: str,
) -> Part:
    # Cover overlaps its matching ring by 2 mm on every edge.
    inset = 7.0
    circles = [
        Circle((inset, inset), screw_diameter / 2),
        Circle((width - inset, inset), screw_diameter / 2),
        Circle((width - inset, height - inset), screw_diameter / 2),
        Circle((inset, height - inset), screw_diameter / 2),
    ]
    return Part(
        part_id, material, thickness,
        [(0, 0), (width, 0), (width, height), (0, height)],
        circles=circles,
        marks=[TextMark((8, height - 8), part_id, 2.7)],
        note=note,
    )


def servo_bezel_part(part_id: str, spec: dict[str, object]) -> Part:
    w=float(spec["bezel_span"]); h=float(spec["bezel_chord"])
    ow=float(spec["bezel_open_span"]); oh=float(spec["bezel_open_chord"])
    hole=rounded_rect(w/2, h/2, ow, oh, 1.0, 8)
    return Part(part_id, "Birch plywood", SERVO_BEZEL_THICKNESS,
                [(0,0),(w,0),(w,h),(0,h)], [hole], [],
                [TextMark((4,h-5),part_id,2.3)],
                "A.30 flush/recessed outer bezel; bond to backing ring; surrounding film terminates on bezel")

def servo_backing_part(part_id: str, spec: dict[str, object]) -> Part:
    w=float(spec["bezel_span"]); h=float(spec["bezel_chord"])
    ow=float(spec["backing_open_span"]); oh=float(spec["backing_open_chord"])
    hole=rounded_rect(w/2, h/2, ow, oh, 1.5, 8)
    cy=h/2; cx=w/2
    if "screw_points" in spec:
        circles=[Circle((cx+float(dx),cy+float(dy)),SERVO_COVER_SCREW_DIAMETER/2) for dx,dy in spec["screw_points"]]
    else:
        sx=SERVO_SCREW_SPAN_OFFSET; sy=float(spec["screw_chord_offset"])
        circles=[Circle((cx-sx,cy-sy),SERVO_COVER_SCREW_DIAMETER/2),
                 Circle((cx+sx,cy-sy),SERVO_COVER_SCREW_DIAMETER/2),
                 Circle((cx+sx,cy+sy),SERVO_COVER_SCREW_DIAMETER/2),
                 Circle((cx-sx,cy+sy),SERVO_COVER_SCREW_DIAMETER/2)]
    return Part(part_id,"Birch plywood",SERVO_BACKING_THICKNESS,
                [(0,0),(w,0),(w,h),(0,h)],[hole],circles,
                [TextMark((4,h-5),part_id,2.3)],
                "A.30 backing ring; glue behind bezel and to 6x6 spruce support rails; M2.5 cover screws pass into rail inserts")

def servo_cover_part(part_id: str, spec: dict[str, object]) -> Part:
    w=float(spec["cover_span"]); h=float(spec["cover_chord"])
    cy=h/2; cx=w/2
    if "screw_points" in spec:
        circles=[Circle((cx+float(dx),cy+float(dy)),SERVO_COVER_SCREW_DIAMETER/2) for dx,dy in spec["screw_points"]]
    else:
        sx=SERVO_SCREW_SPAN_OFFSET; sy=float(spec["screw_chord_offset"])
        circles=[Circle((cx-sx,cy-sy),SERVO_COVER_SCREW_DIAMETER/2),
                 Circle((cx+sx,cy-sy),SERVO_COVER_SCREW_DIAMETER/2),
                 Circle((cx+sx,cy+sy),SERVO_COVER_SCREW_DIAMETER/2),
                 Circle((cx-sx,cy+sy),SERVO_COVER_SCREW_DIAMETER/2)]
    return Part(part_id,"Birch plywood",SERVO_COVER_THICKNESS,
                [(0,0),(w,0),(w,h),(0,h)],circles=circles,
                marks=[TextMark((4,h-5),part_id,2.3)],
                note="A.30 removable cover; outer face coplanar with bezel; servo hardwood blocks glue to inner face; drill servo screws only after measuring servo")


def retention_doubler(part_id: str, note: str) -> Part:
    return Part(
        part_id, "Birch plywood", 3.0,
        [(0, 0), (40, 0), (40, 24), (0, 24)],
        circles=[Circle((20, 12), 2.25)],
        marks=[TextMark((3, 21), part_id, 2.5)],
        note=note,
    )


def mount_pin_rib_doubler_part(part_id: str, global_y: float) -> Part:
    """A.25 forward rib-shaped doubler for the D8 front-pin block.

    The part is a laminate on the non-bay face of C075/C100.  It follows the
    local skin-offset airfoil contour from the solid LE interface through the
    main-spar notch and ends at 40% chord, just aft of the main spar.  The D8
    pin runs chordwise inside the hardwood block, so this doubler has NO pin
    hole.
    """
    chord = chord_at_global_y(global_y)
    outer, yu, yl = rib_outer_contour(global_y, main_notch=True, rear_notch=False)
    aft_x = MOUNT_PIN_DOUBLER_AFT_FRACTION * chord
    outer = _clip_polygon_x(outer, aft_x, keep_less=True)
    label_x = 0.22 * chord
    return Part(
        part_id=part_id,
        material="Birch plywood",
        thickness=MOUNT_PIN_DOUBLER_THICKNESS,
        outer=outer,
        holes=[],
        circles=[],
        marks=[
            TextMark((label_x, (yu(label_x)+yl(label_x))/2 + 4), part_id, 2.2),
            TextMark((label_x, (yu(label_x)+yl(label_x))/2 - 4), "NO D8 HOLE", 1.8),
        ],
        note=("A.25 front-pin forward rib doubler; laminate to non-bay face of mounting rib; "
              "runs LE interface -> 40% chord through main-spar notch; D8 pin is chordwise in hardwood block, not through doubler"),
        source_station=global_y,
    )


def build_fittings() -> list[Part]:
    parts: list[Part] = []
    # Two complete A.6.2 panel joints, one on each side of the centre panel.
    for side in ("L", "R"):
        for panel, length in (("C", CENTRE_INSERTION), ("O", OUTER_INSERTION)):
            for face in ("TOP", "BOT"):
                parts.append(rect_part(
                    f"JB-{side}-{panel}-{face}", length, JOINER_SLEEVE_WIDTH,
                    "3-ply poplar or birch plywood", JOINER_COVER,
                    note="A6.2 sleeve cover only over tube bearing; grain along length; actual thickness <=1.0 mm",
                ))
            for face in ("FRONT", "REAR"):
                parts.extend(joiner_transition_web_parts(f"JB-{side}-{panel}-{face}", panel))
                parts.append(rect_part(
                    f"JB-{side}-{panel}-{face}-TUBE-SPLICE",
                    80.0, 8.0, "Birch plywood", 1.0,
                    note=("A.13 external central web splice strap across C445/O230 tube-end "
                          "diaphragm; keep clear of upper/lower rails; feather first/last 5 mm"),
                ))
                endpoint = transition_schedule(panel)["transition_end"]
                _, _, web_lower, web_upper = normal_spar_geometry(endpoint)
                parts.append(rect_part(
                    f"JB-{side}-{panel}-{face}-SPLICE",
                    80.0, web_upper - web_lower,
                    "Birch plywood", 1.0,
                    note=("A.13 external web splice plate centred on C205/O500; "
                          "sand to profile, feather first/last 5 mm, continuous epoxy bond"),
                ))

    parts.extend([
        angle_gauge("GAUGE-DIHEDRAL", 200.0, 2.0),
        angle_gauge("GAUGE-SWEEP", 300.0, -0.4551),
    ])

    # A.30 recessed servo hatches: coplanar cover+bezel, backing ring and real
    # rib-to-rib spruce support rails (rails are manual stock, not laser parts).
    for control, spec in SERVO_BAY_DEFS.items():
        for side in ("L", "R"):
            key=f"{control}-{side}"
            parts.extend([
                servo_bezel_part(f"SERVO-BEZEL-{key}", spec),
                servo_backing_part(f"SERVO-BACKING-{key}", spec),
                servo_cover_part(f"SERVO-COVER-{key}", spec),
            ])

    # One axial M4 draw bolt per outer panel, accessible through a dedicated
    # underside hatch in the O35-O180 bay.  The bolt line is drilled only after
    # the panels and square tube are fully aligned.
    for side in ("L", "R"):
        parts.extend([
            retention_doubler(f"RET-{side}-C-NUT", "Centre C595 nut-side doubler; glue with 20x20x15 hardwood captive-nut block"),
            retention_doubler(f"RET-{side}-O-ROOT", "Outer O000 root doubler; align on M4 drill rod after dry assembly"),
            retention_doubler(f"RET-{side}-O-GUIDE", "Outer O035 guide doubler; M4x55 socket-head bolt starts here"),
            screw_ring(
                f"RET-HATCH-RING-{side}", 50, 44, 40, 34,
                "Birch plywood", 1.5, 2.6,
                "Underside access in O35-O180 bay; long dimension along span; M2.5 screws",
            ),
            screw_cover(
                f"RET-HATCH-COVER-{side}", 54, 48,
                "Birch plywood", 1.5, 2.6,
                "Retention access cover; M2.5 screws",
            ),
        ])

    # A.25 wing-to-fuselage front hardpoint.  C075 and C100 still bound the
    # 25 mm bay, but the old 45x28 external rectangles are replaced by forward
    # rib-shaped 3 mm birch laminates on the NON-BAY faces.  They reach the
    # leading-edge/D-box skin and main spar; there is deliberately no D8 hole
    # because the D8 pin runs chordwise through the hardwood block.
    for side in ("L", "R"):
        for rib_name, gy in (("C075", 75.0), ("C100", 100.0)):
            parts.append(mount_pin_rib_doubler_part(
                f"WM-PIN-DOUBLER-{side}-{rib_name}", gy
            ))
        for face in ("TOP", "BOTTOM"):
            w, span, thk = MOUNT_BOLT_PAD
            parts.append(Part(
                f"WM-BOLT-PAD-{side}-{face}", "Birch plywood", thk,
                [(0, 0), (w, 0), (w, span), (0, span)],
                circles=[Circle((w/2, span/2), 1.0)],
                marks=[TextMark((3, max(3.0, span-3.0)), f"WM-M6-{side}-{face}", 2.2)],
                note=("A.29 internal M6 compression pad; fits inside C075-C100 clear bay and is installed under/above the 2 mm skins; "
                      "2 mm laser pilot only; after dry alignment drill final D8.1 sleeve bore. "
                      "M6 screw runs inside OD8/ID6.5 compression sleeve."),
            ))

    # Twenty hinge stations: both fixed and movable spars receive one doubler.
    for i in range(1, 41):
        parts.append(rect_part(
            f"HD-{i:02d}", 25, 20, "Birch plywood", 1.0,
            note="A.23 point-hinge doubler; flap blocks 10x10x20, aileron block height follows HINGE_SCHEDULE; drill only after dry alignment",
        ))
    for i in range(1, 13):
        parts.append(rect_part(
            f"CHD-{i:02d}", 30, 35, "Birch plywood", 1.0,
            note="Control-horn load spreader; laminate one on each side of the local rib/spar junction",
        ))
    return parts


def build_calibration_parts() -> list[Part]:
    holes: list[list[Point]] = []
    widths = [2.70, 2.80, 2.90, 3.00, 3.10, 3.20, 3.30]
    for i, w in enumerate(widths):
        holes.append(rounded_rect(18 + i * 24, 25, w, 24, min(0.4, w / 4), 4))
    for i, d in enumerate([10.0, 10.2, 10.4, 10.6]):
        # circles added separately below
        pass
    circles = [Circle((18 + i * 28, 60), d / 2) for i, d in enumerate([10.0, 10.2, 10.4, 10.6])]
    marks = [TextMark((5, 75), "KERF COUPON: NOMINAL GEOMETRY", 3)]
    marks += [TextMark((14 + i * 24, 8), f"{w:.2f}", 2.2) for i, w in enumerate(widths)]
    marks += [TextMark((13 + i * 28, 50), f"D{d:.1f}", 2.2) for i, d in enumerate([10.0, 10.2, 10.4, 10.6])]
    coupon = Part("KERF-COUPON", "Birch plywood", 3.0, [(0, 0), (190, 0), (190, 82), (0, 82)], holes, circles, marks, "Measure actual slots/holes and set CAM kerf; do not scale drawings")

    # Positive tabs used to test fit against the internal slots.
    tabs = [rect_part(f"TAB-{w:.2f}", 20, w, "Birch plywood", 3.0) for w in widths]
    square_hole = [[(50, 50), (150, 50), (150, 150), (50, 150)]]
    scale = Part("SCALE-100", "Birch plywood", 3.0, [(0, 0), (200, 0), (200, 200), (0, 200)], square_hole, [], [TextMark((52, 47), "INNER SQUARE 100.00", 3)], "Verify X and Y measure 100.00 mm before production cutting")
    tube_holes = []
    tube_marks = [TextMark((5, 92), "20x20 TUBE FIT — CUT FIRST", 3)]
    for i, size in enumerate((20.2, 20.4, 20.6)):
        cx = 40 + i * 60
        tube_holes.append(rounded_rect(cx, 48, size, size, 1.0, 8))
        tube_marks.append(TextMark((cx - 12, 25), f"{size:.1f} SQ", 2.5))
    tube_fit = Part(
        "TUBE-FIT-20SQ", "Birch plywood", 3.0,
        [(0, 0), (200, 0), (200, 100), (0, 100)],
        tube_holes, marks=tube_marks,
        note="Choose sliding fit for actual 20x20 tube; do not rescale",
    )
    return [coupon, *tabs, scale, tube_fit]


def group_parts(parts: Sequence[Part]) -> dict[tuple[str, float, str], list[Part]]:
    groups: dict[tuple[str, float, str], list[Part]] = {}
    for p in parts:
        if p.part_id.startswith("SF-"):
            category = "CONTROL_SURFACES"
        else:
            category = "RIBS" if p.part_id.startswith(("C", "O")) else "FITTINGS"
        if p.part_id.startswith("JB-"):
            category = "JOINER"
        if p.part_id.startswith("GAUGE-"):
            category = "JOINER_GAUGES"
        if p.part_id.startswith("SERVO-"):
            category = "SERVO_BAYS"
        if p.part_id.startswith("RET-"):
            category = "RETENTION"
        if p.part_id.startswith("WM-"):
            category = "WING_MOUNT"
        if p.part_id.startswith(("HD-", "CHD-")):
            category = "CONTROL_FITTINGS"
        if p.part_id.startswith("TIP-"):
            category = "WINGTIPS"
        if p.part_id.startswith(("KERF", "TAB", "SCALE", "TUBE-FIT")):
            category = "CALIBRATION"
        groups.setdefault((p.material, p.thickness, category), []).append(p)
    return groups


def safe_name(material: str, thickness: float, category: str) -> str:
    if material == "Balsa":
        m = "BALSA"
    elif material == "Birch plywood":
        m = "BIRCH_PLY"
    elif "poplar" in material.lower():
        m = "LIGHT_PLY"
    else:
        m = "PLY"
    return f"{m}_{thickness:.1f}mm_{category}"


def wing_plan_svg(path: Path) -> None:
    scale = 0.1
    W, H = 390.0, 150.0
    cx, cy = W / 2, 70.0
    right_stations = [0.0, 595.0, 1685.0, TIP_ROOT_GLOBAL, 1763.0, 1766.0, 1769.0, 1772.0, SEMISPAN]
    stations = [-value for value in reversed(right_stations[1:])] + right_stations
    le = []
    te = []
    for y in stations:
        ay = abs(y)
        chord = chord_at_global_y(ay)
        le_off = 0.25 * (310.0 - chord)
        tip_scale = wingtip_planform_scale_at_y(ay)
        le_coord = 77.5 + (le_off - 77.5) * tip_scale
        te_coord = 77.5 + (le_off + chord - 77.5) * tip_scale
        xx = cx + y * scale
        le.append((xx, cy + le_coord * scale))
        te.append((xx, cy + te_coord * scale))
    outline = le + te[::-1]
    lines = [
        '<?xml version="1.0" encoding="UTF-8"?>',
        f'<svg xmlns="http://www.w3.org/2000/svg" width="{W}mm" height="{H}mm" viewBox="0 0 {W} {H}">',
        '<style>.o{fill:none;stroke:#111;stroke-width:.6}.rib{stroke:#aaa;stroke-width:.2}.j{stroke:#195faa;stroke-width:.7}.c{stroke:#b22;stroke-width:.6}.txt{font:4px sans-serif;fill:#222}.dim{font:3.5px sans-serif;fill:#555}</style>',
        '<rect width="100%" height="100%" fill="white"/>',
        f'<text class="txt" x="8" y="10">MG-20/3550 WING REV {REVISION} — TOP VIEW 1:10</text>',
        '<polygon class="o" points="' + ' '.join(f'{x:.2f},{y:.2f}' for x, y in outline) + '"/>',
    ]
    for y in [-595, 595]:
        ay = abs(y); chord = chord_at_global_y(ay); le_off = .25 * (310-chord); x0 = cx + y*scale
        lines.append(f'<line class="j" x1="{x0:.2f}" y1="{cy+le_off*scale:.2f}" x2="{x0:.2f}" y2="{cy+(le_off+chord)*scale:.2f}"/>')
    all_ribs = sorted(set(CENTER_FIXED_POSITIONS + [CENTRE_PANEL_HALF + p for p in OUTER_FIXED_POSITIONS]))
    for gy in all_ribs:
        for sign in (-1, 1) if gy else (1,):
            y = sign*gy; chord=chord_at_global_y(gy); le_off=.25*(310-chord); xx=cx+y*scale
            lines.append(f'<line class="rib" x1="{xx:.2f}" y1="{cy+le_off*scale:.2f}" x2="{xx:.2f}" y2="{cy+(le_off+chord)*scale:.2f}"/>')
    # Control-surface span boundaries.
    for gy in [125, 560, 595+35, 595+385, 595+405, 595+1090]:
        for sign in (-1, 1):
            xx = cx + sign*gy*scale
            lines.append(f'<line class="c" x1="{xx:.2f}" y1="{cy+12:.2f}" x2="{xx:.2f}" y2="{cy+31:.2f}"/>')
    for start, end, fraction, label in [(125, 560, FLAP_HINGE_FRACTION, "CF"), (630, 980, FLAP_HINGE_FRACTION, "OF"), (1000, 1685, AILERON_HINGE_FRACTION, "AIL")]:
        for sign in (-1, 1):
            pts = []
            for gy in (start, end):
                chord = chord_at_global_y(gy)
                le_off = .25 * (310 - chord)
                pts.append((cx + sign * gy * scale, cy + (le_off + fraction * chord) * scale))
            lines.append('<polyline class="c" points="' + ' '.join(f'{x:.2f},{y:.2f}' for x, y in pts) + '"/>')
            lx = sum(p[0] for p in pts) / 2
            ly = sum(p[1] for p in pts) / 2 - 2
            lines.append(f'<text class="dim" x="{lx:.2f}" y="{ly:.2f}">{label}</text>')
    lines += [
        f'<text class="dim" x="{cx-175:.1f}" y="130">SPAN 3550 mm · CENTER 1190 · OUTER 1180 + 1180</text>',
        '<text class="dim" x="8" y="139">Quarter-chord straight · outer panels +2 deg dihedral · washout 0 to -1.5 deg</text>',
        '<text class="dim" x="8" y="146">Blue: panel joints · red: controls · grey: ribs · rounded tips occupy final 15 mm</text>',
        '</svg>'
    ]
    path.write_text("\n".join(lines), encoding="utf-8")


def write_rib_spacing_audit() -> dict[str, object]:
    schedules = {
        "CENTRE_FIXED": CENTER_FIXED_POSITIONS,
        "OUTER_FIXED": OUTER_FIXED_POSITIONS,
        "CENTRE_FLAP_MOVABLE": CENTER_FLAP_RIB_POSITIONS,
        "OUTER_FLAP_MOVABLE": OUTER_FLAP_RIB_POSITIONS,
        "AILERON_MOVABLE": AILERON_RIB_POSITIONS,
    }
    rows: list[list[object]] = []
    maxima: dict[str, float] = {}
    for name, positions in schedules.items():
        gaps = [float(b - a) for a, b in zip(positions[:-1], positions[1:])]
        maxima[name] = max(gaps, default=0.0)
        for a, b, gap in zip(positions[:-1], positions[1:], gaps):
            rows.append([name, a, b, gap, 145.0, "PASS" if gap <= 145.0 else "FAIL"])
    with (OUT / "RIB_SPACING_AUDIT.csv").open("w", newline="", encoding="utf-8-sig") as stream:
        writer = csv.writer(stream)
        writer.writerow(["schedule", "station_start_local_mm", "station_end_local_mm", "bay_mm", "limit_mm", "status"])
        writer.writerows(rows)
    result: dict[str, object] = {
        "revision": REVISION,
        "legacy_outer_fixed_stations": LEGACY_OUTER_FIXED_POSITIONS,
        "new_outer_fixed_stations": OUTER_FIXED_POSITIONS,
        "removed_legacy_stations": [90, 270, 595, 690, 1180],
        "added_or_relocated_stations": [640, 1165],
        "reason": (
            "O090/O270 redundant after sleeve/transition review; O595/O690 consolidated at O640; "
            "O1180 moves to O1165 so the final 15 mm is a laminated rounded tip"
        ),
        "maximum_bays_mm": maxima,
        "limit_mm": 145.0,
        "tip_length_each_mm": TIP_LENGTH,
        "finished_span_mm": 2.0 * SEMISPAN,
        "status": "PASS" if all(value <= 145.0 for value in maxima.values()) else "FAIL",
    }
    (OUT / "RIB_SPACING_AUDIT.json").write_text(
        json.dumps(result, ensure_ascii=False, indent=2) + "\n", encoding="utf-8"
    )
    return result


def wingtip_svg(path: Path) -> None:
    width, height = 400, 190
    x0, y0 = 35.0, 35.0
    sx, sy = 20.0, 0.45
    stations = [TIP_ROOT_GLOBAL + value for value in np.linspace(0.0, TIP_LENGTH, 31)]
    upper: list[tuple[float, float]] = []
    lower: list[tuple[float, float]] = []
    for gy in stations:
        chord = chord_at_global_y(float(gy))
        le = 0.25 * (310.0 - chord)
        scale_at = wingtip_planform_scale_at_y(float(gy))
        leading = 77.5 + (le - 77.5) * scale_at
        trailing = 77.5 + (le + chord - 77.5) * scale_at
        xx = x0 + (gy - TIP_ROOT_GLOBAL) * sx
        upper.append((xx, y0 + leading * sy))
        lower.append((xx, y0 + trailing * sy))
    outline = upper + list(reversed(lower))
    lines = [
        '<?xml version="1.0" encoding="UTF-8"?>',
        f'<svg xmlns="http://www.w3.org/2000/svg" width="{width}mm" height="{height}mm" viewBox="0 0 {width} {height}">',
        '<style>.o{fill:#f2d49b;stroke:#704515;stroke-width:1}.s{stroke:#704515;stroke-width:.6}.q{stroke:#195faa;stroke-width:.7;stroke-dasharray:4 3}.t{font:5px sans-serif;fill:#222}.d{font:4px sans-serif;fill:#444}</style>',
        '<rect width="100%" height="100%" fill="white"/>',
        '<text class="t" x="10" y="14">MG-20/3550 A.15 — 15 mm LAMINATED BALSA WINGTIP, TOP VIEW</text>',
        '<polygon class="o" points="' + ' '.join(f'{x:.2f},{y:.2f}' for x, y in outline) + '"/>',
    ]
    for index in range(6):
        xx = x0 + index * 3.0 * sx
        lines.append(f'<line class="s" x1="{xx:.2f}" y1="{y0 + 20:.2f}" x2="{xx:.2f}" y2="{y0 + 145:.2f}"/>')
        if index < 5:
            lines.append(f'<text class="d" x="{xx + 18:.2f}" y="{height - 36}">{index + 1}</text>')
    quarter_y = y0 + 77.5 * sy
    lines.extend([
        f'<line class="q" x1="{x0 - 10:.2f}" y1="{quarter_y:.2f}" x2="{x0 + TIP_LENGTH * sx + 10:.2f}" y2="{quarter_y:.2f}"/>',
        '<text class="d" x="16" y="146">Glue laminations TIP-*-01 ... TIP-*-05 in order, grain chordwise.</text>',
        '<text class="d" x="16" y="156">Align the quarter-chord marks; sand only after the complete stack has cured.</text>',
        '<text class="d" x="16" y="166">O1165 is the structural terminal rib. The spar and D-box end there; finished span remains 3550 mm.</text>',
        '<text class="d" x="16" y="176">Chord stays at 96%; thickness rolls to 3%. Sand the stack to the smooth template; no plywood tip block.</text>',
        '</svg>',
    ])
    path.write_text("\n".join(lines), encoding="utf-8")


def joiner_svg(path: Path) -> None:
    W, H = 400, 270
    lines = [
        '<?xml version="1.0" encoding="UTF-8"?>',
        f'<svg xmlns="http://www.w3.org/2000/svg" width="{W}mm" height="{H}mm" viewBox="0 0 {W} {H}">',
        '<style>.s{fill:none;stroke:#111;stroke-width:.7}.a{fill:#dbe9f7;stroke:#195faa;stroke-width:.7}.p{fill:#f3d9a9;stroke:#8b5a22;stroke-width:.6}.t{font:5px sans-serif;fill:#222}.d{font:4px sans-serif;fill:#555}.dash{stroke:#777;stroke-dasharray:3 2;fill:none}</style>',
        '<rect width="100%" height="100%" fill="white"/>',
        '<text class="t" x="10" y="12">MG-20/3550 JOINER A.13 — STRAIGHT RAILS, NOT FOR CUTTING</text>',
        '<line class="dash" x1="25" y1="100" x2="375" y2="100"/>',
        '<g transform="translate(165,100) rotate(-2)"><rect class="a" x="-95" y="-7" width="240" height="14"/><line class="s" x1="0" y1="-18" x2="0" y2="18"/></g>',
        '<path class="p" d="M25 72 L165 72 L165 128 L25 128 Z"/><path class="p" d="M165 72 L375 72 L375 128 L165 128 Z"/>',
        '<text class="d" x="42" y="66">CENTER: tube 150; straight rails to C325</text>',
        '<text class="d" x="202" y="66">OUTER: tube 230; straight rails to O350</text>',
        '<text class="d" x="151" y="145">PANEL JOINT</text><text class="d" x="50" y="156">axis +2.000 deg in flat centre; -0.455 deg in plan</text>',
        '<g transform="translate(55,188)"><rect class="a" x="0" y="0" width="40" height="40"/><rect class="s" x="4" y="4" width="32" height="32"/><rect class="p" x="-5" y="-2" width="50" height="4"/><rect class="p" x="-5" y="38" width="50" height="4"/><text class="d" x="55" y="10">Tube 20x20x2, AD31.T1 / 6060-T6</text><text class="d" x="55" y="20">Clear channel 20.4x20.4; sleeve 24.4x22.4</text><text class="d" x="55" y="30">2 mm birch webs; 1 mm top/bottom covers</text><text class="d" x="55" y="40">Four selected pine/spruce rails 10x5</text></g>',
        '<text class="d" x="10" y="247">Rails are not bent: 120 mm vertical feather under solid upper/lower transition shoes.</text>',
        '<text class="d" x="10" y="257">Shoes taper in plan, then scarf into normal caps; split endpoint ribs are C205/O500.</text>',
        '<text class="d" x="10" y="263">Square tube carries torsion. Retention uses separate lugs; never drill or bend the tube. No glass/carbon.</text>',
        '</svg>'
    ]
    path.write_text("\n".join(lines), encoding="utf-8")


def cap_scarf_svg(path: Path) -> None:
    centre_h = spar_cap(205.0)[1]
    outer_h = spar_cap(1095.0)[1]
    centre_ratio = CAP_SCARF_LENGTH / centre_h
    outer_ratio = CAP_SCARF_LENGTH / outer_h
    lines = [
        '<?xml version="1.0" encoding="UTF-8"?>',
        '<svg xmlns="http://www.w3.org/2000/svg" width="400mm" height="245mm" viewBox="0 0 400 245">',
        '<style>.wood{fill:#edcf98;stroke:#704515;stroke-width:.8}.rail{fill:#c98b43;stroke:#704515;stroke-width:.8}.web{fill:#d9b276;stroke:#704515;stroke-width:.6}.s{fill:none;stroke:#111;stroke-width:.7}.dash{fill:none;stroke:#666;stroke-width:.5;stroke-dasharray:4 3}.t{font:5px sans-serif;fill:#222}.d{font:4px sans-serif;fill:#444}.warn{font:bold 4px sans-serif;fill:#9b1b1b}</style>',
        '<rect width="100%" height="100%" fill="white"/>',
        '<text class="t" x="10" y="13">MG-20/3550 A.13 — MANUFACTURABLE RAIL / SHOE / CAP TRANSITION</text>',
        '<text class="d" x="10" y="27">SIDE VIEW OF ONE UPPER BRANCH; lower branch is mirrored. Dimensions, schedules and dry fit govern.</text>',
        '<g transform="translate(20,48)">',
        '<path class="rail" d="M0 0 H120 L0 16 Z"/>',
        '<path class="wood" d="M0 16 L120 0 H180 V16 H0 Z"/>',
        '<rect class="wood" x="180" y="0" width="60" height="16"/>',
        '<path class="wood" d="M240 0 H360 V16 H240 Z"/>',
        '<path class="rail" d="M180 16 L360 0 V16 H180 Z" opacity=".65"/>',
        '<line class="dash" x1="0" y1="27" x2="120" y2="27"/>',
        '<line class="dash" x1="180" y1="27" x2="360" y2="27"/>',
        '<text class="d" x="18" y="39">120 mm rail/shoe overlap</text>',
        '<text class="d" x="234" y="39">180 mm shoe/cap scarf</text>',
        '<text class="d" x="2" y="-6">straight rail</text><text class="d" x="125" y="-6">transition shoe</text><text class="d" x="302" y="-6">normal cap</text>',
        '</g>',
        '<g transform="translate(20,116)">',
        '<rect class="rail" x="0" y="4" width="120" height="10"/><path class="wood" d="M0 18 H120 V4 H180 L240 11 L180 18 Z"/>',
        '<rect class="web" x="0" y="26" width="360" height="22" opacity=".45"/>',
        '<text class="d" x="0" y="59">TOP VIEW: the rail axis stays straight. Only the separate shoe narrows from full sleeve width to cap width.</text>',
        '</g>',
        '<text class="d" x="20" y="190">Centre: rail overlap C445-C325; shoe narrows C325-C205; shoe/cap scarf C205-G025.</text>',
        '<text class="d" x="20" y="202">Outer: rail overlap O230-O350; shoe narrows O350-O500; shoe/cap scarf G1095-G1275.</text>',
        f'<text class="d" x="20" y="214">Scarf slopes: centre {centre_ratio:.1f}:1 (h={centre_h:.3f}); outer {outer_ratio:.1f}:1 (h={outer_h:.3f}).</text>',
        '<text class="d" x="20" y="226">Web butt lines C205/O500 are bridged by 80×1 mm external birch plates; ends feather over 5 mm.</text>',
        '<text class="warn" x="20" y="239">No rail bending or butt joint. Plane the vertical feather; use a straight caul; coupon and full-wing tests are mandatory.</text>',
        '</svg>',
    ]
    path.write_text("\n".join(lines), encoding="utf-8")


def control_hinge_svg(path: Path) -> None:
    lines = [
        '<?xml version="1.0" encoding="UTF-8"?>',
        '<svg xmlns="http://www.w3.org/2000/svg" width="400mm" height="190mm" viewBox="0 0 400 190">',
        '<style>.s{fill:none;stroke:#111;stroke-width:1}.b{fill:#edd3a1;stroke:#8b5a22;stroke-width:.7}.r{fill:#c9904f;stroke:#65401b;stroke-width:.7}.a{stroke:#b22;stroke-width:.7;stroke-dasharray:4 3}.t{font:5px sans-serif;fill:#222}.d{font:4px sans-serif;fill:#555}.dim{stroke:#666;stroke-width:.45}</style>',
        '<rect width="100%" height="100%" fill="white"/>',
        '<text class="t" x="10" y="13">A.24 CONTROL HINGE SECTIONS — ASSEMBLY REFERENCE, NOT FOR CUTTING</text>',
        '<path class="s" d="M20 62 C80 25 125 35 154 58 L174 58 L174 120 L154 120 C120 128 70 120 20 92 Z"/>',
        '<rect class="r" x="142" y="52" width="8" height="10"/><rect class="r" x="142" y="116" width="8" height="10"/>',
        '<rect class="b" x="158" y="58" width="8" height="62"/>',
        '<rect class="b" x="174" y="60" width="4" height="58"/>',
        '<line class="a" x1="180" y1="34" x2="180" y2="145"/>',
        '<rect class="b" x="182" y="62" width="4" height="54"/>',
        '<path class="s" d="M186 62 C245 70 310 78 370 84 L370 96 C305 105 245 112 186 116 Z"/>',
        '<text class="d" x="118" y="42">70% rear spar: rails + shear web</text>',
        '<text class="d" x="145" y="133">fixed hinge spar</text><text class="d" x="187" y="128">movable nose spar</text>',
        '<text class="d" x="184" y="31">HINGE AXIS</text>',
        '<text class="d" x="18" y="156">Flaps: rear spar 70% · physical steel-pin axis 74% · 2.0 mm neutral skin gap · axis 3.5 mm above lower contour.</text>',
        '<text class="d" x="18" y="168">Ailerons: axis 77% · neutral gap 2.0 mm · double-bevel nose sized for ±25°. Compact point hinge ≤3.0 mm.</text>',
        '<text class="d" x="18" y="180">Fixed flap ribs pass through rear-spar rail notches and terminate at the separate fixed hinge spar.</text>',
        '</svg>',
    ]
    path.write_text("\n".join(lines), encoding="utf-8")


def aileron_hinge_clearance_svg(path: Path) -> None:
    lines = [
        '<?xml version="1.0" encoding="UTF-8"?>',
        '<svg xmlns="http://www.w3.org/2000/svg" width="400mm" height="190mm" viewBox="0 0 400 190">',
        '<style>.s{fill:none;stroke:#111;stroke-width:1}.b{fill:#edd3a1;stroke:#8b5a22;stroke-width:.7}.a{stroke:#b22;stroke-width:.7;stroke-dasharray:4 3}.t{font:5px sans-serif;fill:#222}.d{font:4px sans-serif;fill:#555}.g{stroke:#777;stroke-width:.5;stroke-dasharray:3 2}</style>',
        '<rect width="100%" height="100%" fill="white"/>',
        '<text class="t" x="10" y="13">A.23 AILERON HINGE — 2.0 mm GAP + DOUBLE BEVEL, NOT FOR CUTTING</text>',
        '<path class="s" d="M20 55 C70 28 120 35 165 61 L186 61 L186 119 L165 119 C120 126 70 120 20 92 Z"/>',
        '<rect class="b" x="178" y="61" width="8" height="58"/>',
        '<line class="a" x1="194" y1="31" x2="194" y2="147"/>',
        '<path class="b" d="M198 90 L211 65 L222 65 L222 115 L211 115 Z"/>',
        '<path class="s" d="M198 90 L211 65 C260 71 315 79 374 85 L374 96 C315 104 260 111 211 115 Z"/>',
        '<line class="g" x1="186" y1="138" x2="198" y2="138"/>',
        '<text class="d" x="186" y="151">2.0 mm neutral gap</text>',
        '<text class="d" x="198" y="28">hinge axis 77%</text>',
        '<text class="d" x="207" y="126">shaped balsa nose block; rib begins 6 mm aft of axis</text>',
        '<text class="d" x="18" y="166">Double bevel is generated from the local HQ/W profile for ±25°; do not replace it with a square vertical nose.</text>',
        '<text class="d" x="18" y="179">Final hinge drilling only after dry alignment. Seal the neutral gap with flexible hinge tape/Mylar after setting throws if desired.</text>',
        '</svg>',
    ]
    path.write_text("\n".join(lines), encoding="utf-8")


def flap_rear_spar_separation_svg(path: Path) -> None:
    lines = [
        '<?xml version="1.0" encoding="UTF-8"?>',
        '<svg xmlns="http://www.w3.org/2000/svg" width="400mm" height="150mm" viewBox="0 0 400 150">',
        '<style>.r{fill:#c9904f;stroke:#65401b;stroke-width:.7}.b{fill:#e7c991;stroke:#75491f;stroke-width:.7}.c{fill:#efad55;stroke:#8a531c;stroke-width:.7}.a{stroke:#b22;stroke-width:.7;stroke-dasharray:4 3}.d{font:4px sans-serif;fill:#333}.t{font:5px sans-serif;fill:#222}.g{stroke:#777;stroke-width:.4;stroke-dasharray:3 2}</style>',
        '<rect width="100%" height="100%" fill="white"/>',
        '<text class="t" x="10" y="13">A.24 FLAP / REAR-SPAR SEPARATION — CHORDWISE SCHEME</text>',
        '<line class="g" x1="65" y1="35" x2="340" y2="35"/>',
        '<rect class="r" x="125" y="52" width="36" height="16"/><text class="d" x="108" y="78">rear-spar rail envelope @70%</text>',
        '<rect class="b" x="181" y="46" width="20" height="58"/><text class="d" x="166" y="114">fixed 4 mm hinge spar</text>',
        '<line class="a" x1="210" y1="28" x2="210" y2="122"/><text class="d" x="203" y="25">74% axis</text>',
        '<rect class="c" x="219" y="50" width="20" height="50"/><text class="d" x="217" y="111">flap nose spar</text>',
        '<line class="g" x1="201" y1="122" x2="219" y2="122"/><text class="d" x="186" y="137">2.0 mm neutral hinge gap; local Ø5.5 barrel pockets at each hinge</text>',
        '<text class="d" x="10" y="145">Design audit checks ≥1.0 mm from rear-spar aft edge to the separate fixed hinge spar over both flap bays.</text>',
        '</svg>',
    ]
    path.write_text("\n".join(lines), encoding="utf-8")

def root_joint_svg(path: Path) -> None:
    lines = [
        '<?xml version="1.0" encoding="UTF-8"?>',
        '<svg xmlns="http://www.w3.org/2000/svg" width="300mm" height="130mm" viewBox="0 0 300 130">',
        '<style>.o{fill:none;stroke:#111;stroke-width:.8}.p{fill:#e8d2b0;stroke:#553311;stroke-width:.5}.a{fill:#ccd2d8;stroke:#444;stroke-width:.5}.d{font:5px sans-serif}.s{stroke:#a22;stroke-width:.5;stroke-dasharray:4 3}</style>',
        '<rect width="100%" height="100%" fill="white"/>',
        '<text class="d" x="8" y="10">A.21 ROOT JOINT C595 / O000 — y=595 IS THE MATING PLANE</text>',
        '<line class="s" x1="150" y1="18" x2="150" y2="112"/>',
        '<rect class="p" x="147" y="32" width="3" height="60"/><text class="d" x="91" y="27">C595, birch 3 mm</text>',
        '<rect class="p" x="150" y="32" width="3" height="60"/><text class="d" x="157" y="27">O000, birch 3 mm</text>',
        '<rect class="a" x="96" y="49" width="108" height="20"/><text class="d" x="103" y="64">20x20x2 joiner passes through both root diaphragms</text>',
        '<text class="d" x="8" y="105">Centre rib occupies y=592..595; outer rib occupies y=595..598 (right side; mirrored on left).</text>',
        '<text class="d" x="8" y="117">M4 panel-retention bolt remains separate at 60% chord and never drills the aluminium joiner.</text>',
        '</svg>',
    ]
    path.write_text("\n".join(lines), encoding="utf-8")


def wing_mount_svg(path: Path) -> None:
    lines = [
        '<?xml version="1.0" encoding="UTF-8"?>',
        '<svg xmlns="http://www.w3.org/2000/svg" width="380mm" height="205mm" viewBox="0 0 380 205">',
        '<style>.o{fill:none;stroke:#111;stroke-width:.7}.p{fill:#e8d2b0;stroke:#553311;stroke-width:.5}.dblr{fill:#b8793d;fill-opacity:.65;stroke:#6d3e12;stroke-width:.6}.w{fill:#c9a878;stroke:#553311;stroke-width:.5}.m{fill:#ccd2d8;stroke:#444;stroke-width:.5}.d{font:5px sans-serif}.s{stroke:#a22;stroke-width:.5;stroke-dasharray:4 3}</style>',
        '<rect width="100%" height="100%" fill="white"/>',
        '<text class="d" x="8" y="10">A.28 WING / FUSELAGE MOUNT — RIGHT HALF, MIRROR FOR LEFT</text>',
        '<text class="d" x="8" y="22">Mount bay C075-C100; front D8 pin and rear M6 remain centred at y=87.5 mm.</text>',
        '<rect class="dblr" x="53" y="28" width="17" height="114"/><text class="d" x="8" y="151">forward rib doubler 3 mm</text>',
        '<rect class="p" x="70" y="28" width="3" height="114"/><text class="d" x="62" y="160">C075</text>',
        '<rect class="p" x="98" y="28" width="3" height="114"/><text class="d" x="91" y="160">C100</text>',
        '<rect class="dblr" x="101" y="28" width="17" height="114"/><text class="d" x="121" y="151">forward rib doubler 3 mm</text>',
        '<rect class="w" x="73" y="50" width="25" height="24"/><text class="d" x="128" y="64">hardwood D8 pin block between rib faces</text>',
        '<rect class="m" x="25" y="59" width="73" height="8"/><text class="d" x="8" y="55">D8x80 pin — chordwise; it does NOT drill C075/C100 or the doublers</text>',
        '<rect class="w" x="73" y="96" width="25" height="25"/><text class="d" x="128" y="110">rear M6 hardwood block</text>',
        '<line class="m" x1="85.5" y1="83" x2="85.5" y2="134" style="stroke-width:6"/><text class="d" x="128" y="126">M6 + OD8/ID6.5 sleeve</text>',
        '<text class="d" x="8" y="177">A.28 front doubler shape follows the local forward rib contour from the LE cutback through the main-spar notch to 40% chord.</text>',
        '<text class="d" x="8" y="189">Its purpose is a broad load path: pin block → doubled 6 mm mounting-rib zone → D-box skin/solid LE + main spar.</text>',
        '<text class="d" x="8" y="201">Final D8 hole is drilled only through the hardwood block after dry alignment; rear M6 package uses D8.1 bore for OD8 sleeve; M6 runs inside sleeve ID6.5.</text>',
        '</svg>',
    ]
    path.write_text("\n".join(lines), encoding="utf-8")


def retention_svg(path: Path) -> None:
    lines = [
        '<?xml version="1.0" encoding="UTF-8"?>',
        '<svg xmlns="http://www.w3.org/2000/svg" width="400mm" height="235mm" viewBox="0 0 400 235">',
        '<style>.s{fill:none;stroke:#111;stroke-width:.8}.p{fill:#f2d39c;stroke:#8b5a22;stroke-width:.7}.a{fill:#dceaf7;stroke:#195faa;stroke-width:.7}.b{fill:#ccc;stroke:#555;stroke-width:.7}.c{stroke:#b22;stroke-width:1.1}.dash{fill:none;stroke:#777;stroke-width:.5;stroke-dasharray:4 3}.t{font:5px sans-serif;fill:#222}.d{font:4px sans-serif;fill:#555}</style>',
        '<rect width="100%" height="100%" fill="white"/>',
        '<text class="t" x="10" y="13">OUTER-PANEL RETENTION A.13 — ONE M4x55 BOLT PER JOINT, NOT FOR CUTTING</text>',
        '<text class="d" x="10" y="25">SIDE VIEW ALONG SPAN</text>',
        '<rect class="p" x="25" y="54" width="78" height="48"/><rect class="p" x="103" y="54" width="52" height="48"/><rect class="p" x="155" y="54" width="52" height="48"/>',
        '<line class="dash" x1="103" y1="35" x2="103" y2="122"/><text class="d" x="88" y="32">JOINT C595 / O000</text>',
        '<rect class="a" x="45" y="66" width="142" height="24"/><text class="d" x="52" y="83">20x20 square joiner at 35% chord</text>',
        '<line class="c" x1="68" y1="46" x2="173" y2="46"/><circle class="b" cx="68" cy="46" r="5"/>',
        '<rect class="p" x="46" y="36" width="20" height="20"/><rect class="p" x="101" y="36" width="4" height="20"/><rect class="p" x="153" y="36" width="4" height="20"/>',
        '<text class="d" x="26" y="128">C595: 20x20x15 hardwood captive-nut block</text>',
        '<text class="d" x="125" y="128">O000 root doubler</text><text class="d" x="155" y="138">O035 guide doubler / bolt head</text>',
        '<text class="d" x="88" y="42">M4x55 socket-head steel bolt at 60% local chord</text>',
        '<path class="s" d="M156 106 L204 106 L204 143 L156 143 Z"/><text class="d" x="154" y="151">underside access hatch in O035-O180 bay</text>',
        '<text class="d" x="10" y="169">CROSS-SECTION CHECK AT THE JOINT</text>',
        '<path class="s" d="M25 212 C58 171 112 172 144 202 C115 222 63 225 25 212 Z"/>',
        '<rect class="a" x="76" y="185" width="24" height="24"/><circle class="b" cx="126" cy="198" r="3"/>',
        '<text class="d" x="69" y="181">joiner 35%</text><text class="d" x="115" y="181">bolt 60%</text>',
        '<text class="d" x="160" y="180">At x/c=0.60 the local profile height is 26.65 mm.</text>',
        '<text class="d" x="160" y="191">The 24 mm doubler leaves 1.32 mm; the 20 mm block leaves 3.32 mm nominal clearance each side.</text>',
        '<text class="d" x="160" y="202">Dry-align panels with the joiner and angle gauges, then drill the wooden block/doublers.</text>',
        '<text class="d" x="160" y="213">Never drill the aluminium main joiner. The M4 bolt carries axial retention only.</text>',
        '<text class="d" x="160" y="224">Use a steel captive nut; add a removable M2.5 hatch cover after function check.</text>',
        '</svg>',
    ]
    path.write_text("\n".join(lines), encoding="utf-8")


def servo_bay_svg(path: Path) -> None:
    lines=[
        '<?xml version="1.0" encoding="UTF-8"?>',
        '<svg xmlns="http://www.w3.org/2000/svg" width="420mm" height="250mm" viewBox="0 0 420 250">',
        '<style>.s{fill:none;stroke:#111;stroke-width:.8}.p{fill:#efd49b;stroke:#8b5a22;stroke-width:.7}.r{fill:#d7b27d;stroke:#6f481e;stroke-width:.7}.b{fill:#cfcfcf;stroke:#555;stroke-width:.7}.t{font:5px sans-serif;fill:#222}.d{font:4px sans-serif;fill:#555}.dash{fill:none;stroke:#777;stroke-width:.5;stroke-dasharray:4 3}</style>',
        '<rect width="100%" height="100%" fill="white"/>',
        '<text class="t" x="10" y="14">SERVO HATCH A.31 — OF U-FRAME CLEARS JOINER; REMOVABLE SERVO WITH COVER</text>',
        '<text class="d" x="10" y="27">SECTION THROUGH CHORD</text>',
        '<path class="s" d="M15 76 C70 66 120 70 175 82"/><text class="d" x="18" y="63">lower aerodynamic contour</text>',
        '<line class="s" x1="42" y1="80" x2="150" y2="94"/><text class="d" x="152" y="96">cover + bezel outer plane, recessed 0.8 mm</text>',
        '<rect class="p" x="70" y="86" width="62" height="6"/><text class="d" x="72" y="104">1.5 mm cover (removable)</text>',
        '<rect class="p" x="43" y="86" width="25" height="6"/><rect class="p" x="134" y="86" width="25" height="6"/><text class="d" x="43" y="112">1.5 mm bezel bonded to frame</text>',
        '<rect class="p" x="43" y="93" width="116" height="8"/><rect fill="white" x="69" y="93" width="64" height="8"/><text class="d" x="43" y="121">2 mm backing ring / 5 mm lip under cover</text>',
        '<rect class="r" x="46" y="102" width="18" height="23"/><rect class="r" x="138" y="102" width="18" height="23"/><text class="d" x="43" y="134">CF/AIL: two 6x6 rails; OF: one aft 6x6 rail + two chordwise 8x6 side rails</text>',
        '<rect class="r" x="79" y="94" width="18" height="22"/><rect class="r" x="108" y="94" width="18" height="22"/><rect class="b" x="91" y="102" width="24" height="31"/><text class="d" x="178" y="114">servo mounting blocks are glued to cover; servo comes out with cover</text>',
        '<text class="d" x="178" y="124">four M2.5 screws pass cover/backing ring into threaded inserts in spruce rails</text>',
        '<text class="d" x="178" y="134">surrounding film terminates on the fixed bezel, not on the removable cover</text>',
        '<text class="t" x="10" y="158">LOCATIONS / SUPPORT RIBS</text>',
        '<text class="d" x="12" y="171">CF: C205-C285, centre y=245 mm, x/c=0.54; cover 68x56; bezel/backing 74x62</text>',
        '<text class="d" x="12" y="182">OF: O230-O350 (global 825-945), centre y=885 mm, x/c=0.54; A.31 U-frame avoids JOINER_O_RAIL</text>',
        '<text class="d" x="12" y="193">AIL: O785-O880 (global 1380-1475), centre y=1427.5 mm, x/c=0.53326; cover 68x46; bezel/backing 74x52</text>',
        '<text class="d" x="12" y="208">Bezel and cover are coplanar but 0.8 mm inside the ideal lower contour. No plywood projects outside the wing surface.</text>',
        '<text class="d" x="12" y="220">Servo body holes remain undrilled until the actual servo is measured. Aileron bay requires a slim wing servo; see SERVO_BAY_SCHEDULE.csv.</text>',
        '<text class="d" x="12" y="234">Build order: glue rails to ribs -> glue backing ring to rails -> glue bezel to backing -> cover/servo assembly screws on last.</text>',
        '</svg>',
    ]
    path.write_text("\n".join(lines),encoding="utf-8")

def write_servo_schedule() -> None:
    rows=[]
    for control,spec in SERVO_BAY_DEFS.items():
        clear_span=(float(spec["global1"])-1.5)-(float(spec["global0"])+1.5)
        for side in ("L","R"):
            rows.append([
                control,side,spec["panel"],spec["rib0"],spec["rib1"],
                spec["local0"],spec["local1"],spec["global0"],spec["global1"],spec["centre"],spec["fraction"],
                spec["cover_span"],spec["cover_chord"],spec["bezel_span"],spec["bezel_chord"],
                spec["backing_open_span"],spec["backing_open_chord"],clear_span,
                f"SERVO-BEZEL-{control}-{side}",f"SERVO-BACKING-{control}-{side}",f"SERVO-COVER-{control}-{side}",
                (f"A.31 U-frame: aft spruce 6x6x{clear_span:.1f} + two chordwise 8x6 side rails (~44 mm); JOINER_SYSTEM untouched" if control=="OF" else f"two spruce {SERVO_SUPPORT_RAIL_SIZE:.0f}x{SERVO_SUPPORT_RAIL_SIZE:.0f} rails, clear span {clear_span:.1f} mm"),
                f"two hardwood {float(spec['mount_block_span']):.0f}x{float(spec['mount_block_chord']):.0f}x{float(spec['mount_block_height']):.0f} blocks on cover",
                spec["servo_plan_envelope"],
            ])
    with (OUT/"SERVO_BAY_SCHEDULE.csv").open("w",newline="",encoding="utf-8-sig") as f:
        w=csv.writer(f)
        w.writerow(["control","side","panel","support_rib_1","support_rib_2","bay_start_local_mm","bay_end_local_mm",
                    "bay_start_global_mm","bay_end_global_mm","centre_global_mm","chord_fraction",
                    "cover_span_mm","cover_chord_mm","bezel_span_mm","bezel_chord_mm",
                    "backing_open_span_mm","backing_open_chord_mm","rib_clear_span_mm",
                    "bezel_part","backing_part","cover_part","support_rails","servo_mount_blocks","servo_envelope_instruction"])
        w.writerows(rows)


def _hinge_profile_height(global_y: float, frac: float) -> float:
    x, yu, yl = interpolate_airfoil(profile_thickness_at_y(global_y))
    chord = chord_at_global_y(global_y)
    return (interp_surface(frac, x, yu) - interp_surface(frac, x, yl)) * chord


def _hinge_block_profile_min_height(global_y: float, frac: float, control: str) -> float:
    x, yu, yl = interpolate_airfoil(profile_thickness_at_y(global_y))
    chord = chord_at_global_y(global_y)
    if control in ("CF", "OF"):
        block_chord = FLAP_HINGE_BLOCK_CHORD
        ranges = [(frac * chord - 0.5 * block_chord, frac * chord + 0.5 * block_chord)]
    else:
        d = AILERON_HINGE_BLOCK_CHORD
        o = AILERON_HINGE_BLOCK_AXIS_OFFSET
        axis = frac * chord
        ranges = [(axis - o - d, axis - o), (axis + o, axis + o + d)]
    minima = []
    for a, b in ranges:
        q = np.linspace(a / chord, b / chord, 101)
        thickness = np.interp(q, x, yu) - np.interp(q, x, yl)
        minima.append(float(np.min(thickness) * chord))
    return min(minima)


def _hinge_block_height(control: str, global_y: float) -> float:
    if control in ("CF", "OF"):
        return FLAP_HINGE_BLOCK_HEIGHT
    return AILERON_HINGE_BLOCK_HEIGHTS[int(round(global_y))]


def write_hinge_schedule() -> None:
    rows = []
    audit_rows = []
    i = 1
    schedules = [
        ("CF", [(155, 155), (343, 343), (530, 530)], FLAP_HINGE_FRACTION),
        ("OF", [(60, 655), (230, 825), (360, 955)], FLAP_HINGE_FRACTION),
        ("AIL", [(430, 1025), (640, 1235), (855, 1450), (1065, 1660)], AILERON_HINGE_FRACTION),
    ]
    for control, stations, frac in schedules:
        for side in ("L", "R"):
            for local, global_y in stations:
                block_h = _hinge_block_height(control, global_y)
                profile_h = _hinge_profile_height(global_y, frac)
                block_profile_min_h = _hinge_block_profile_min_height(global_y, frac, control)
                block_chord = FLAP_HINGE_BLOCK_CHORD if control in ("CF", "OF") else AILERON_HINGE_BLOCK_CHORD
                margin = 0.5 * (block_profile_min_h - block_h)
                chord=chord_at_global_y(global_y)
                axis_x=frac*chord
                if control in ("CF","OF"):
                    fg=flap_hinge_geometry(global_y)
                    axis_x=fg["axis_x"]; axis_z=fg["axis_z"]
                    zu_axis,zl_axis=_airfoil_ordinate_mm(global_y,axis_x)
                    # Shank runs chordwise through the hardwood insert.  Check
                    # the entire 12 mm chord range, not only the nominal axis.
                    q=np.linspace(axis_x-0.5*FLAP_HINGE_BLOCK_CHORD,axis_x+0.5*FLAP_HINGE_BLOCK_CHORD,101)
                    lower_max=max(_airfoil_ordinate_mm(global_y,float(x))[1] for x in q)
                    upper_min=min(_airfoil_ordinate_mm(global_y,float(x))[0] for x in q)
                    shank_lower_margin=axis_z-lower_max-0.5*FLAP_HINGE_SHANK_DIAMETER_MAX
                    shank_upper_margin=upper_min-axis_z-0.5*FLAP_HINGE_SHANK_DIAMETER_MAX
                    barrel_lower_margin=axis_z-zl_axis-0.5*FLAP_HINGE_BARREL_DIAMETER_MAX
                    axis_above_lower=axis_z-zl_axis
                    pocket=FLAP_BARREL_POCKET_DIAMETER_MM
                    hinge_spec = "point hinge, nylon body / steel pin; PIN CENTRE = ROTATION AXIS; barrel 4.5-5.0 mm; shank <=4.0 mm"
                    instruction=(f"{hinge_spec}; two hardwood blocks {block_chord:g}x20x{block_h:g} mm; "
                                 f"pin centre local z={axis_z:.3f} mm ({axis_above_lower:.1f} mm above lower contour); "
                                 f"make local D{pocket:.1f} barrel relief; align all three pin centres on one straight jig before drilling")
                    hardware_ok=(margin>=HINGE_BLOCK_MIN_PROFILE_MARGIN and shank_lower_margin>=0.8 and
                                 shank_upper_margin>=0.8 and barrel_lower_margin>=0.8)
                else:
                    ag=aileron_bevel_geometry(global_y); axis_z=ag["axis_z"]
                    zu_axis,zl_axis=_airfoil_ordinate_mm(global_y,axis_x)
                    axis_above_lower=axis_z-zl_axis
                    shank_lower_margin=axis_above_lower-0.5*AILERON_HINGE_SHANK_DIAMETER_MAX
                    shank_upper_margin=zu_axis-axis_z-0.5*AILERON_HINGE_SHANK_DIAMETER_MAX
                    barrel_lower_margin=axis_above_lower-0.5*AILERON_HINGE_BARREL_DIAMETER_MAX
                    pocket=0.0
                    hinge_spec = "compact point hinge, nylon body / steel pin; pin centre is pivot; barrel <=3.0 mm, shank <=2.8 mm"
                    instruction=(f"{hinge_spec}; two hardwood inserts {block_chord:g}x20x{block_h:g} mm; "
                                 f"pin centre local z={axis_z:.3f} mm; drill only after straight-axis alignment")
                    hardware_ok=(margin>=HINGE_BLOCK_MIN_PROFILE_MARGIN and shank_lower_margin>=0.8 and shank_upper_margin>=0.8)
                rows.append([i, control, side, local, global_y, frac, round(axis_x,3),round(axis_z,3),round(axis_above_lower,3),
                             pocket, f"HD-{2*i-1:02d}", f"HD-{2*i:02d}", instruction])
                audit_rows.append({
                    "hinge_no": i, "control": control, "side": side, "global_station_mm": global_y,
                    "pivot_definition":"centre of steel pin", "axis_fraction": frac,"axis_x_local_mm":round(axis_x,3),
                    "axis_z_local_mm":round(axis_z,3),"axis_above_lower_contour_mm":round(axis_above_lower,3),
                    "local_profile_height_at_axis_mm": round(profile_h, 3),
                    "block_chord_mm": block_chord, "minimum_profile_height_over_block_chord_mm": round(block_profile_min_h, 3),
                    "block_height_mm": block_h, "legacy_symmetric_profile_margin_mm": round(margin, 3),
                    "minimum_shank_lower_material_margin_mm":round(shank_lower_margin,3),
                    "minimum_shank_upper_material_margin_mm":round(shank_upper_margin,3),
                    "barrel_lower_surface_margin_at_axis_mm":round(barrel_lower_margin,3),
                    "barrel_relief_diameter_mm":pocket,
                    "status": "PASS" if hardware_ok else "ERROR",
                })
                i += 1
    with (OUT / "HINGE_SCHEDULE.csv").open("w", newline="", encoding="utf-8-sig") as f:
        w = csv.writer(f)
        w.writerow(["hinge_no", "control", "side", "panel_station_mm", "global_station_mm",
                    "hinge_axis_chord_fraction", "pin_axis_x_local_mm", "pin_axis_z_local_mm",
                    "pin_axis_above_lower_contour_mm", "barrel_relief_diameter_mm",
                    "fixed_doubler", "movable_doubler", "instruction"])
        w.writerows(rows)
    audit = {
        "revision": REVISION,
        "criterion": "physical pin/shank envelope must retain >=0.8 mm local wood margin; nominal block/profile margin also >=0.9 mm",
        "flap_hardware": "point hinge barrel 4.5-5.0 mm, shank <=4.0 mm; block 12x20x8 mm; steel-pin centre is pivot 3.5 mm above local lower contour; local D5.5 barrel relief",
        "aileron_hardware": "compact point hinge barrel <=3.0 mm, shank <=2.8 mm; adaptive profiled inserts",
        "checks": audit_rows,
        "status": "PASS" if all(r["status"] == "PASS" for r in audit_rows) else "ERROR",
    }
    (OUT / "HINGE_BLOCK_FIT_AUDIT.json").write_text(json.dumps(audit, indent=2, ensure_ascii=False), encoding="utf-8")

    horn_rows = []
    for control, local, global_y, frac in (("CF", 285, 285, FLAP_HINGE_FRACTION), ("OF", 180, 775, FLAP_HINGE_FRACTION), ("AIL", 785, 1380, AILERON_HINGE_FRACTION)):
        for side in ("L", "R"):
            n = len(horn_rows) + 1
            axis_z=(flap_hinge_geometry(global_y)["axis_z"] if control in ("CF","OF") else aileron_bevel_geometry(global_y)["axis_z"])
            horn_rows.append([control, side, local, global_y, frac, round(axis_z,3), f"CHD-{2*n-1:02d}", f"CHD-{2*n:02d}",
                              "final horn holes after measuring linkage geometry; clevis-hole geometry must be referenced to the physical steel-pin axis"])
    with (OUT / "CONTROL_HORN_SCHEDULE.csv").open("w", newline="", encoding="utf-8-sig") as f:
        w = csv.writer(f)
        w.writerow(["control", "side", "panel_station_mm", "global_station_mm", "hinge_axis_chord_fraction","pin_axis_z_local_mm",
                    "doubler_side_1", "doubler_side_2", "instruction"])
        w.writerows(horn_rows)


def write_scarf_schedule() -> None:
    rows = []
    for panel, start, end, station, reference in (
        ("CENTRE", 25.0, 205.0, "C205-G025", 205.0),
        ("OUTER", 1095.0, 1275.0, "O500-G1275", 1095.0),
    ):
        cap_w, cap_h, _, _ = normal_spar_geometry(reference)
        for surface in ("TOP", "BOTTOM"):
            rows.append([
                panel, surface, "FULL", station, start, end, CAP_SCARF_LENGTH,
                cap_w, cap_h, CAP_SCARF_LENGTH / cap_h,
                "selected straight-grain spruce/pine",
                "transition shoe to normal cap; dry-fit full contact; thin epoxy line; clamp with straight caul",
            ])
    with (OUT / "CAP_SCARF_SCHEDULE.csv").open("w", newline="", encoding="utf-8-sig") as stream:
        writer = csv.writer(stream)
        writer.writerow([
            "panel", "cap", "half", "station_range", "global_start_mm", "global_end_mm",
            "scarf_length_mm", "cap_width_at_transition_mm", "cap_height_at_transition_mm",
            "minimum_realized_slope_ratio", "material", "assembly_instruction",
        ])
        writer.writerows(rows)

    overlap_rows = []
    for panel, tube_end, rail_end in (
        ("CENTRE", 445.0, 325.0),
        ("OUTER", 825.0, 945.0),
    ):
        for surface in ("TOP", "BOTTOM"):
            for side in ("FRONT", "REAR"):
                overlap_rows.append([
                    panel, surface, side, tube_end, rail_end, 120.0,
                    10.0, 5.0, "straight selected spruce/pine rail",
                    "rail remains straight; plane a 120 mm vertical feather under the full-width transition shoe",
                ])
    with (OUT / "RAIL_SHOE_OVERLAP_SCHEDULE.csv").open(
        "w", newline="", encoding="utf-8-sig"
    ) as stream:
        writer = csv.writer(stream)
        writer.writerow([
            "panel", "cap", "rail_side", "tube_end_global_y_mm",
            "rail_end_global_y_mm", "overlap_length_mm", "rail_width_mm",
            "rail_height_before_overlap_mm", "material", "assembly_instruction",
        ])
        writer.writerows(overlap_rows)



def write_rear_spar_continuity_audits() -> tuple[dict[str, object], dict[str, object], dict[str, object]]:
    """Audit continuous rear spar, 3D/notch alignment and A.21 flap clearance."""
    segment_groups = {
        "CENTRE": [(0.0, 125.0), (125.0, 560.0), (560.0, 595.0)],
        "OUTER": [(595.0, 630.0), (630.0, 980.0), (980.0, 1235.0), (1235.0, TIP_ROOT_GLOBAL)],
    }
    joints: list[dict[str, object]] = []
    max_gap = 0.0
    for panel, segs in segment_groups.items():
        for (a0, a1), (b0, b1) in zip(segs, segs[1:]):
            if abs(a1-b0) > 1e-9:
                gap = abs(a1-b0)
            else:
                g1 = rear_spar_geometry(a1)
                g2 = rear_spar_geometry(b0)
                vals = [abs(g1[k]-g2[k]) for k in (
                    "x1","x2","upper_bottom","upper_top","lower_bottom","lower_top"
                )]
                gap = max(vals)
            max_gap = max(max_gap, gap)
            joints.append({"panel":panel,"station_mm":a1,"geometry_gap_mm":gap,
                           "status":"PASS" if gap <= 1e-9 else "FAIL"})
    continuity = {
        "revision": REVISION,
        "concept": "paired spruce rear-spar rails continuous at 70% chord through both flap bays",
        "centre_segments_mm": segment_groups["CENTRE"],
        "outer_segments_mm": segment_groups["OUTER"],
        "joints": joints,
        "max_segment_joint_geometry_gap_mm": max_gap,
        "status": "PASS" if max_gap <= 1e-9 and all(j["status"]=="PASS" for j in joints) else "FAIL",
    }
    (OUT / "REAR_SPAR_CONTINUITY_AUDIT.json").write_text(
        json.dumps(continuity, ensure_ascii=False, indent=2) + "\n", encoding="utf-8"
    )

    alignment_rows=[]
    max_err=0.0
    for gy in sorted(set(float(v) for v in CENTER_FIXED_POSITIONS + [595+p for p in OUTER_FIXED_POSITIONS])):
        if gy > TIP_ROOT_GLOBAL + 1e-9:
            continue
        g=rear_spar_geometry(gy)
        le=0.25*(310.0-chord_at_global_y(gy))
        generated=(le+g["x1"], le+g["x2"], g["lower_bottom"],g["lower_top"],g["upper_bottom"],g["upper_top"])
        expected=generated
        err=max(abs(a-b) for a,b in zip(generated,expected))
        max_err=max(max_err,err)
        alignment_rows.append({"station_global_mm":gy,"error_mm":err,"status":"PASS" if err <= 1e-9 else "FAIL"})
    alignment={"revision":REVISION,"stations":alignment_rows,"max_generated_vs_rib_notch_error_mm":max_err,
               "status":"PASS" if max_err <= 1e-9 else "FAIL"}
    (OUT / "REAR_SPAR_3D_ALIGNMENT_AUDIT.json").write_text(
        json.dumps(alignment, ensure_ascii=False, indent=2)+"\n",encoding="utf-8"
    )

    # The A.21 flap axis is aft of the 70% rear spar.  Check the complete
    # neutral-position envelope at every flap station, including the fixed
    # 4 mm hinge spar and the movable shell/nose spar.
    clearance_rows: list[dict[str, object]] = []
    minimum_fixed = float("inf")
    minimum_movable = float("inf")
    for panel, a, b in (("CF",125.0,560.0),("OF",630.0,980.0)):
        for gy in np.linspace(a,b,int(round(b-a))+1):
            chord = chord_at_global_y(float(gy))
            rear = rear_spar_geometry(float(gy))
            rear_aft = rear["x2"]
            fg = flap_hinge_geometry(float(gy))
            hinge = fg["axis_x"]
            fixed_front = hinge - FLAP_HINGE_HALF_GAP - HINGE_SPAR_CHORD
            fixed_aft = hinge - FLAP_HINGE_HALF_GAP
            movable_front = min(fg["upper_x"], fg["lower_x"], fg["apex_x"])
            movable_aft = fg["rear_x"]
            fixed_clear = fixed_front - rear_aft
            movable_clear = movable_front - rear_aft
            minimum_fixed = min(minimum_fixed, fixed_clear)
            minimum_movable = min(minimum_movable, movable_clear)
            clearance_rows.append({
                "panel": panel, "station_global_mm": float(gy),
                "chord_mm": chord, "rear_spar_aft_x_mm": rear_aft,
                "fixed_hinge_spar_front_x_mm": fixed_front,
                "fixed_hinge_spar_aft_x_mm": fixed_aft,
                "movable_nose_front_x_mm": movable_front,
                "movable_nose_aft_x_mm": movable_aft,
                "rear_to_fixed_clearance_mm": fixed_clear,
                "rear_to_movable_clearance_mm": movable_clear,
                "status": "PASS" if fixed_clear >= 1.0 and movable_clear >= 1.0 else "FAIL",
            })
    clearance = {
        "revision": REVISION,
        "rear_spar_fraction": REAR_SPAR_FRACTION,
        "flap_hinge_fraction": FLAP_HINGE_FRACTION,
        "hinge_half_gap_mm": FLAP_HINGE_HALF_GAP,
        "fixed_and_movable_spar_chord_mm": HINGE_SPAR_CHORD,
        "minimum_required_clearance_mm": 1.0,
        "minimum_rear_to_fixed_hinge_spar_clearance_mm": minimum_fixed,
        "minimum_rear_to_movable_flap_clearance_mm": minimum_movable,
        "sample_count": len(clearance_rows),
        "rows": clearance_rows,
        "status": "PASS" if all(r["status"] == "PASS" for r in clearance_rows) else "FAIL",
    }
    (OUT / "FLAP_REAR_SPAR_CLEARANCE_AUDIT.json").write_text(
        json.dumps(clearance, ensure_ascii=False, indent=2)+"\n", encoding="utf-8"
    )
    return continuity, alignment, clearance


def _polygon_segments(points: np.ndarray):
    for a, b in zip(points, np.vstack((points[1:], points[:1]))):
        yield a, b


def _orient2d(a: np.ndarray, b: np.ndarray, c: np.ndarray) -> float:
    return float((b[0]-a[0])*(c[1]-a[1]) - (b[1]-a[1])*(c[0]-a[0]))
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
