sinyakov-sa/plane/(commit log)

2026-10-22 проект крыла и файлы резки пенала и соответствующих нервюр
    [01_C595_ROOT_PLY3_nominal.dxf, 02_C560_C525_PLY2_nominal.dxf, 03_C445_PLY3_nominal.dxf, MG20_Wing_A36_SmoothBREP_KOMPAS.step, SERVO_BAY_SCHEDULE.csv, SERVO_JOINER_CLEARANCE_AUDIT.json]
2026-10-23 хвост и нервюры колодок
    [FIT_TESTS.dxf, MG20_Tail_RevA_Envelope.step, MG20_Tail_RevA_Frame.step, O0350-AFT.dxf, O0350-FWD.dxf, O0385-AFT.dxf, O0385-FWD.dxf, O0405-AFT.dxf]
2026-10-23 хвост
    [Clearance_Sweep.csv, Cut_Parts_List.csv, Fit_Test_Slots_5mm_3mm.dxf, HS_L_Elevator.step, HS_L_Fixed.step, HS_R_Elevator.step, HS_R_Fixed.step, HS_R_Fixed_AP203.step]
